jsdenim/thermonuino/main/Specifications Thermonuio.md

Le projet Thermonuino est un ensemble de composants qui communiquent entre eux pour gérer le chauffage d’un appartement.

Le mode de commande est par fil pilote : les radiateurs sont réglés au maximum, et on les commande soit en “CONFORT” \= rien dans le fil pilote, pour les faire chauffer, soit en “HORS-GEL” \= demi-alternance dans le fil pilote.

Il y a 4 type de composants dans le système :
La partie pilote, la partie console, la partie mesure, et la partie détection de fenêtre ouvertes.

La partie pilote et reliée à la partie console par deux paires de cuivre : 5V, GND, et RX et TX pour communiquer.
Les parties mesure et détection de fenêtre communiquent avec la console par RF 433 Mhz via des modules CC1101. Pour ces derniers, chaque module doit avoir une adresse unique et vaguement aléatoire sur 32000 possibilités, (pour éviter des conflits avec d’autres appartements).

Tous les composants fonctionnent avec des Atmega328p à 8Mhz, en 5v quand il y a une alimentation continue, ou en 3.3v quand ils sont sur pile.

Le système est capable de gérer 4 zones de chauffage, et dans chaque zone, il y a une sonde de mesure, et éventuellement un détecteur de portes ouvertes.

Fonctionnement général :

La température commandée se fait par zone, et par apprentissage progressif. Dans un premier temps, l’utilisateur va indiquer sur chaque zone la température qu’il souhaite, et le système va mémoriser qu’à telle heure, tel jour de la semaine, il doit faire telle température dans la zone. Chaque fois qu’il reprécise son souhait, cela enrichit la programmation.

La partie console permet de dériver de la programmation habituelle pour toutes les zones, en demandant un peu plus chaud, un peu plus froid, rien du tout….

Les détecteurs de porte ouverte permettent de mettre en pause le chauffage dans la zone correspondante.

# Partie Pilote

Sur la partie haute tension, elle gère les ordre dans le fil pilote. Ensuite, il y a une alimentation 5V qui alimente la logique de PCB, et alimente aussi la partie console.
Les deux PCB sont reliés par deux paires torsadées, une pour le 5v, l’autre pour une communication série en 9600 bauds.

Cette partie gère aussi une lecture des trames TIC d’un compteur Linky.
La TIC est employée pour deux choses : lire la date et l’heure (et la transmettre a la console), et déterminer la variation de courant soutirée lorsqu’un radiateur est commandé (ce qui aide pour la logique de chauffage).

La partie pilote envoie à la console l’heure courante, l’estimation déduite de la puissance des radiateurs sur chaque zone.
Elle reçoit de la partie console des instructions de chauffage pour chaque zone.
L’instruction est sous forme de duty cycle.
La durée du cycle est indiquée par la console pour toutes les zones à la fois. Probablement que 30 minutes est une bonne base de travail.
Ensuite, la console indique pour chaque zone le temps de travail sur la durée du cycle, par une valeur comprise entre 0 et 255\. 0 représentant aucune activation du chauffage, 255 une activation permanente pour les 30 prochaine minutes du cycle de travail.
127 représente une activation durant 15 minutes, découpées en plusieurs morceaux pour être réparti équitablement dans le temps de travail des 30 minutes.

La réception de nouvelles instructions de travail provoque la rupture du duty cycle déjà en cours.

Sur la partie pilote, il y a un bouton statut, et un bouton par zone, une chaîne de LED adressable, une pour le statut, une pour le Linky, et une par zone.
Tant qu’on appuie sur rien, la partie pilote respecte ce que dit la console.
La LED statut est alors verte.

Si on appuie sur l’un des boutons d’une zone, la partie pilote n’écoute plus ce que dit la centrale. La zone correspondante est inversée, et on ne fait rien de plus. Plusieurs zones peuvent ainsi être forcées à être allumées.
Le bouton statut permet de revenir au mode normal.

Dans tous les cas, les LED des zones indiquent si le chauffage est commandé ou pas.

Si la détection de la puissance d’une zone échoue, on peut afficher une LED violette quand elle n’est pas commandée. Le reste du temps, quand on fait chauffer une zone, on allume en orange, si non éteint.

# Partie Console

La partie console dispose d’un CC1101 pour échanger avec les sondes de mesure et le détecteur de portes ouvertes.

La partie console est responsable de mémoriser la programmation de la température dans chaque pièce, et d’ordonner à la partie pilote un rythme de chauffage pour chaque zone.
La mémoire se fait sur l’EEPROM séparée, accessible en I2C, d’une capacité de 512Kbits.

La partie console dispose d’un ATH30 en I2C pour une mesure de température “de secours”, c’est à dire si les sondes de mesures ne donnent plus de signal.

Le PCB dispose d’une chaine de LED adressables pour chaque zone, et une sous la mode sélectionné, et une au centre du boitier.

La console n'a pas d'écran et ne doit donc pas porter de menu utilisateur complexe. Les interactions utilisateur finales disponibles sur la console sont limitées à la molette de mode et aux LED d'état. Les menus de programmation détaillés sont portés par la sonde avec écran.

## Régulation par puissance lissée

La console ne doit pas piloter le chauffage par simple seuil instantané, par exemple tout allumer tant que la température est sous la consigne puis tout couper dès que la consigne est dépassée. Le comportement recherché doit être plus progressif et peu perceptible.

Pour chaque zone, la console doit raisonner en puissance thermique à injecter sur une période glissante, typiquement une heure. L'apprentissage doit permettre d'estimer qu'une zone a besoin d'une certaine énergie de maintien, par exemple l'équivalent de 3500 W pendant une heure, pour rester stable dans un contexte donné.

La puissance électrique des radiateurs de chaque zone est fournie par la partie pilote, qui l'apprend grâce aux variations de puissance TIC observées pendant les cycles d'apprentissage. Cette information permet à la console de convertir une puissance de maintien souhaitée en workload 0..255 envoyé au pilote. La console considère comme cohérente une puissance comprise entre `700 VA` et `3000 VA`, bornes incluses. Toute autre valeur, notamment `0` lorsque l'apprentissage du pilote a échoué, est remplacée par la valeur de secours `1200 VA`.

Exemple : si une zone dispose de radiateurs estimés à `2400 W` et que l'algorithme souhaite injecter l'équivalent de `1200 W` pendant l'heure, la console peut demander environ 50 % de travail sur cette zone. Le pilote se charge ensuite de lisser ce duty cycle dans le cycle court de commande fil pilote.

Dans une première version de production, la console peut utiliser une régulation proportionnelle simple : si la température mesurée d'une zone est inférieure à sa consigne effective, elle estime une puissance demandée proportionnelle à l'écart, la borne entre une puissance minimale utile et une puissance maximale, puis convertit cette puissance en workload `0..255` à partir de la puissance installée apprise pour la zone. Si la puissance installée est inconnue, la console peut utiliser une valeur de secours prudente jusqu'à réception d'une estimation fiable du pilote.

Cette logique doit rester visible dans le simulateur Web : pour chaque zone, il doit être possible d'observer au moins la puissance installée apprise, la puissance de maintien demandée par l'algorithme, le workload 0..255 correspondant, et l'effet thermique simulé.

L'apprentissage doit aussi tenir compte des habitudes d'aération. Pour chaque zone et chaque créneau hebdomadaire, la console conserve un compteur d'ouverture de porte/fenêtre. Si une porte est ouverte pendant le créneau, le compteur augmente. Si, la semaine suivante, le même créneau passe sans ouverture, le compteur diminue. Une habitude d'aération récurrente peut alors réduire légèrement la puissance demandée avant ou pendant ce créneau, afin d'éviter de chauffer inutilement juste avant une phase où l'air chaud sera évacué.

L’utilisateur peut choisir un mode à l’aide d’une molette, qui s’applique alors sur toutes les zones. Cette molette est réalisée par une piste de cuivre découverte : une seule entrée de mode doit normalement être active à la fois. Pendant les petits recouvrements ou états incertains où aucune entrée ou plusieurs entrées sont actives, la console conserve le dernier mode clairement sélectionné.

* Normal : respecte la programmation habituelle apprise pour chaque zone.
* Plus : augmente d’un degré tout l’appartement par rapport à la programmation normale.
* Moins : diminue d’un degré tout l’appartement par rapport à la programmation normale.

  Les modes plus et moins peuvent être utilisés de manière impulsionnelle : si l'utilisateur part de Plus ou Moins, revient brièvement sur Normal, puis revient sur le même mode Plus ou Moins en moins de 3 secondes, l'effet s'additionne par pas de 1 °C. L'override reste actif tant que la molette reste sur Plus ou Moins.

* Douche : pendant 30 minutes, la zone salle de bain, zone 4, vise une consigne augmentée de 2 °C par rapport à la programmation normale. Cela peut conduire la régulation à demander un workload très élevé au début si l'écart de température est important, mais le chauffage doit ensuite être modulé comme pour les autres modes. Le reste de l’appartement applique temporairement une consigne réduite de 1 °C, car l'utilisateur sort souvent de la douche avec une sensation de chaleur.

* Stop : tout les chauffages sont coupés. Les sondes reçoivent `global_mode = Stop` dans les réponses RF et doivent se mettre en OFF fonctionnel.

* Vacance : applique une consigne Vacances configurable, 17 °C par défaut, pour tout l’appartement, mesuré uniquement sur la centrale. Si la molette est sur Vacance, le mode vacances est forcé et reste actif tant que la molette reste sur cette position.

Le mode vacances peut aussi se déclencher de lui-même lorsque les détecteurs de mouvement ne rapportent plus de mouvement récent, c'est-à-dire depuis environ 48 h. (Fonctionnalité non appliquée lorsqu’aucune zone n’a plus d’information des thermomètres.) Il faut distinguer le mode Vacance forcé par la molette du mode Auto-vacances : le mode automatique s'arrête dès qu'une présence est de nouveau détectée. Une détection PIR ne doit pas déclencher une émission RF immédiate pour préserver les piles ; chaque front de détection est comptabilisé localement par interruption, conservé jusqu'à un ACK valide, puis envoyé lors du prochain échange RF normal. L'indication locale « présence récente » sur 15 minutes doit utiliser les cycles réels du watchdog, car `millis()` ne progresse pas pendant le sommeil profond. La console horodate les présences reçues avec son horloge interne. L'heure fournie par la partie pilote/Linky est une condition normale de démarrage ; la logique applicative considère ensuite l'heure disponible. La première synchronisation horaire valide doit réinitialiser la référence d'absence afin qu'un temps par défaut ou transitoire au démarrage ne déclenche jamais Auto-vacances immédiatement.

L'apprentissage de programmation ne doit être modifié que lorsque la molette est sur Normal. Les modes Plus, Moins, Douche, Stop, Vacance forcé ou Vacance automatique ne doivent pas effacer ni renforcer l'apprentissage existant.

Si une zone est bloquée en porte/fenêtre ouverte mais que le thermomètre de la zone reçoit ensuite une demande utilisateur explicite de consigne, la console doit ignorer temporairement l'information porte ouverte pour cette zone. Ce contournement permet de reprendre le chauffage si le détecteur d'ouverture est défectueux ou si son aimant est mal placé. Dès que le détecteur d'ouverture reparle, l'état porte est considéré de nouveau fiable et le contournement est annulé.

La LED du mode :
Vert \= Normal
Plus \= Orangé
Moins \= Bleu
Douche \= Alternance Orangé / Vert
Stop \= éteint
Vacance \= Bleu clignotant doucement (1 part 10 secondes)

Fonctions des LED par zone :

* Jaune : chauffe en cours.
* Bleu : porte ouverte détectée
* Éteint : pas d’action en cours.
* Violet fixe : plus de communication avec le détecteur de porte ouverte.
* Violet clignotant 1 seconde toutes les 6 secondes : pile du détecteur de porte ouverte à remplacer.
* Rouge clignotant 1 seconde toutes les 6 secondes : pile de la sonde de mesure à remplacer.
* Rouge fixe : plus de communication avec la sonde de mesure.
* Flash violet de 100 ms : réception d'une trame du détecteur de porte ouverte.
* Flash rouge de 100 ms : réception d'une trame de sonde.

Si plusieurs états doivent être affichés sur la même LED de zone, l'affichage peut être séquencé sur une période d'environ 7 secondes. Par exemple, si une porte est ouverte et que la pile du détecteur de porte est faible, la LED peut rester bleue pendant 6 secondes puis afficher 1 seconde de violet. Si seul le chauffage est actif, la LED reste jaune sur toute la période, ce qui donne une impression continue.

La luminosité globale des LED de la console est limitée à `49` en journée. Elle monte progressivement depuis le minimum `3` entre 7h et 9h, reste au maximum jusqu'à 17h, puis redescend progressivement jusqu'au minimum à 21h. En l'absence d'heure valide, la console utilise la luminosité minimale.

La partie console indique aux sondes de mesure de basculer en OFF lorsque l’une des conditions suivantes est remplie :
Le mode de fonctionnement est sur STOP ou VACANCE
La température de la centrale est supérieure à 23° depuis plus d’un jour.

# Partie Mesure

ATH30 en I2C, détecteur de mouvement, état de la pile.

La communication avec la console se fait à l’aide d’un module CC1101 alimenté en 3,3 V permanent.
Par défaut, le CC1101 est placé en basse consommation par commande SPI `SPWD`. Quand il communique avec la console, il écoute pendant quelques secondes la réponse de la console qui accuse réception de ce que la sonde communique, et indique aussi les messages qui étaient en attente pour la sonde de mesure.

La partie sonde dispose aussi un écran et d’un switch bidirectionnel \+ bouton.
La fréquence de communication avec la centrale dépend des conditions, et des interactions avec l’utilisateur :

* Tant que la température est stable, et sans interaction de la part de l’utilisateur, ou que la centrale a indiqué qu’il fallait se mettre en OFF, la sonde ne parle que toutes les heures.
* La sonde signale sous quelques secondes tout changement de température de plus de 0.45°.
* De même, si l'utilisateur fait des changements sur la température transitoire dans la pièce, ou sur la programmation, ils sont communiqués à la centrale sous quelques secondes.

La sonde dispose donc de plusieurs états de fonctionnement, avec une répercussion sur l’écran.

* Normal : affichage HOME classique.
* Menu : navigation et réglages locaux sur deux niveaux.
* Batterie faible : l'écran normal reste utilisable, mais l'information est visible dans le menu Etat et transmise à la console.
* Batterie critique : la sonde affiche un écran bloquant `REMPLACER PILES`, barré par une croix, signale l'état critique à la console pendant environ 1 h, puis cesse toute activité pour éviter de descendre la pile trop bas.
* Défaut RF bloquant : si le self-test SPI du CC1101 échoue au démarrage, la sonde affiche un écran bloquant `RF 433 MHZ KO`, barré par une croix, puis s'arrête. Ce self-test doit rester facilement désactivable temporairement dans le sketch pour tester un PCB avant soudure du CC1101.
* OFF fonctionnel : lorsque la console demande Stop ou Vacance, la sonde affiche l'écran correspondant et ne perturbe pas l'apprentissage.

En mode normal, l’écran HOME affiche principalement la température actuelle en grands chiffres. La flèche représente l'écart entre la consigne courante et la température mesurée : droite si l'écart est nul, inclinée vers le haut si la consigne est plus haute que la mesure, inclinée vers le bas si elle est plus basse.

La flèche n'est affichée que si la console indique qu'il y a eu du chauffage sur la zone dans la journée passée. Si la zone n'a pas chauffé depuis environ 24 h, la flèche est masquée afin de ne pas donner l'impression qu'une action de chauffage est attendue ou pertinente.

L'écran eInk utilise le refresh partiel pour les ajustements rapides pendant une interaction utilisateur, par exemple lorsque l'utilisateur fait défiler une consigne. En revanche, lorsqu'une interaction se termine et qu'une modification est validée ou sauvegardée, le retour à l'écran précédent doit se faire avec un refresh complet. Le flash du refresh complet fait partie de l'interface utilisateur : il indique que la modification est prise en compte et que l'on revient à l'état précédent.

Si l'utilisateur manœuvre le switch vers le haut ou vers le bas, cela signale un souhait de monter ou baisser la température de façon transitoire, c'est-à-dire seulement juqu’au prochain point de programmation.
Si l’utilisateur fait suivre ce gestion par un appui sur le bouton central, cela transforme l’instruction en changement pérenne sur la programmation.

Un appui long sur le bouton central, environ 3 secondes, fait entrer dans le menu depuis HOME. Depuis le menu, le même appui long ramène à HOME. Une absence d'interaction pendant environ 60 secondes ramène aussi à HOME.

## Interface menu de la sonde

Le menu de la sonde doit rester rapide à parcourir. Le premier niveau n'est donc pas une liste de rubriques abstraites, mais une suite de pages directement utiles. Certaines pages affichent un indicateur `+` lorsqu'un sous-menu existe pour consulter des détails ou effectuer un réglage.

Le switch directionnel sert à faire défiler les pages principales. Le bouton central entre dans le sous-menu signalé par `+`, ou bascule une valeur en édition si la page courante est directement réglable. Une fois une valeur en édition, les directions `+` et `-` modifient la valeur, puis un nouvel appui central valide et sauvegarde. Une validation qui revient au niveau précédent doit utiliser un refresh complet, assumé comme retour visuel de sauvegarde.

Pages principales proposées :

| Page principale | Affichage direct | Sous-menu `+` |
|---|---|---|
| Présence | Indique si une présence humaine a été vue récemment, typiquement sur les 15 dernières minutes. Cette information n'est pas un témoin temps réel sur HOME ; elle est mise à jour dans le service de données puis consultable ici. | Historique court ou dernier instant de détection, si cela devient utile au diagnostic. |
| Batterie | Pourcentage de pile, calculé entre tension pleine et tension critique. La tension critique vaut 0 %. La page affiche un `+`. | Tension brute, tension pleine de référence, seuil faible, seuil critique, état `test sans pile` si la mesure est quasi nulle. |
| Lien console | Etat synthétique de la communication avec la centrale : OK si une réponse console valide a été reçue récemment, KO sinon. La page affiche un `+`. | Etat RF détaillé, identifiant RF local, identifiant console appris, résumé de la dernière réponse console. |
| Thermomètre | Valeur réelle mesurée par l'AHT30, affichée au dixième de degré avant correction et avant arrondi au pas de `0,5 °C`. La page affiche un `+`. | Température brute au dixième de degré et étalonnage AHT30 : offset en dixièmes de degrés, borné à `-2,5 °C` / `+2,5 °C`, envoyé à la console puis rediffusé par celle-ci. |
| Apprentissage | Etat synthétique de l'apprentissage pour la zone : consigne habituelle connue, fallback utilisé, ou absence d'information fiable. La page affiche un `+`. | Zone affectée, association de la sonde à une zone, activation/désactivation de l'apprentissage, consultation et maintenance de la mémoire apprise pour la zone. |

Sous-menu de `Lien console` :

| Page de détail | Rôle |
|---|---|
| Debug RF | Distingue le self-test SPI local du CC1101 et la réception effective d'une réponse console valide. |
| Identifiants RF | Affiche l'identifiant RF local et l'identifiant console appris. |
| Dernière réponse | Résume la dernière trame console valide : mode global, consigne courante, indicateur chauffage 1 h / 24 h, porte ouverte, délai conseillé avant prochain rapport. |

Sous-menu de `Batterie` :

| Page de détail | Rôle |
|---|---|
| Tension | Tension brute en millivolts. |
| Seuils | Tension pleine de référence, seuil batterie faible, seuil batterie critique. |
| Etat | Normal, faible, critique, ou test sans pile mesurable. |

Sous-menu de `Thermomètre` :

| Page de détail | Rôle |
|---|---|
| Brut | Température AHT30 avant correction. |
| Correction | Offset AHT modifiable, en dixièmes de degrés, qui devient effectif lorsqu'il est mémorisé puis rediffusé par la console. |
| Corrigé | Température finale utilisée pour HOME et les trames RF. |
| Vacances | Consigne utilisée par la console en mode Vacances forcé ou Auto-vacances. La sonde l'obtient depuis la réponse RF de la console et peut envoyer une demande administrative pour la modifier. La valeur durable est sauvegardée uniquement côté console. |

Sous-menu de `Apprentissage` :

| Page de détail | Rôle |
|---|---|
| Zone | Affiche la zone chauffage affectée à la sonde : zone 1 à 4. |
| Association | Permet de demander l'association ou le changement d'association de la sonde. Un appui central entre en édition, `+` et `-` choisissent la zone candidate 1 à 4, et chaque changement force l'envoi d'une trame RF avec `admin_request = association` et `pair_zone_request`. L'association finale reste mémorisée côté console. |
| Consigne programmee | Affiche la consigne habituelle actuellement retenue par la console pour la zone. |
| Actif | Active ou désactive l'apprentissage pour la zone affectée. Si l'apprentissage est inactif, la console ignore la programmation apprise pour cette zone et applique directement la consigne envoyée par la sonde. Ce réglage est mémorisé par zone côté console. |
| Comm. console | Indique si la communication avec la console est utilisable : `OK` si une réponse console valide a été reçue récemment, `ABSENTE` sinon. La consigne affichée sur la sonde doit toujours être réalignée sur la consigne renvoyée par la console lorsqu'un ACK valide est reçu. |
| Reset zone | Envoie à la console une demande d'effacement de l'apprentissage de la zone affectée à cette sonde. L'écran indique l'envoi tant que la demande n'a pas été acquittée. |
| Reset global | Envoie à la console une demande d'effacement de tout l'apprentissage. L'écran indique l'envoi tant que la demande n'a pas été acquittée. |
| Semaine type | Envoie à la console une demande de chargement de la semaine type pour toutes les zones. L'écran indique l'envoi tant que la demande n'a pas été acquittée. |

La modification quotidienne de température ne se fait pas dans ce menu. Elle reste portée par HOME : `+` ou `-` applique une variation transitoire, puis un appui central peut transformer cette demande en modification pérenne de la programmation selon la logique d'apprentissage.

Le pourcentage de batterie affiché est une valeur pratique, pas une mesure chimique exacte. Il est calculé ainsi :

```text
pourcentage = clamp((tension_mesuree - tension_critique) / (tension_pleine - tension_critique), 0, 1) * 100
```

Si la mesure de pile vaut environ `0 V` ou une valeur très faible, par exemple `<= 0,05 V`, la sonde considère qu'elle est alimentée par programmateur ou banc de test sans pile mesurable, et le contrôle batterie ne bloque pas l'appareil.

Un détecteur de mouvement PIR permettent de savoir s’il y a toujours quelqu’un dans la zone. Du point de vue global de l’appartement, on peut déduire après 2 jours sans mouvement dans tout l’appartement qu’il n’y a personne, et qu’on peut basculer automatiquement en mode vacance. Au niveau d’un pièce, cela peut aussi servir à enrichir la programmation : si on remarque que la personne passe souvent dans un même créneau horaire, et plus rarement dans un autre, on peux ajuster la consigne avec cela.

# Partie détection fenêtre ouverte

Etat de la pile, interrupteur REED, CC1101.
Signale un changement d’état si on ne revient pas à l’état précédent en moins de 10 secondes.
Parle au moins toutes les heures à la centrale.
Un bouton permet de déclencher une interaction locale, notamment pour générer l'identifiant initial de l'appareil, demander l'association, puis faire avancer la zone proposée pendant l'association.

Le détecteur de porte ouverte utilise le même montage de mesure batterie que la sonde : entrée `BAT_SENS` sur A0 / PCINT8, pont diviseur 1 Mohm / 1 Mohm, mesure avant régulateur 3 V, calcul `ADC * 3300 mV * 2 / 1023`.

Contrairement à la sonde, le détecteur de porte ouverte n'utilise qu'une seule pile. Ses seuils batterie sont donc distincts :

* batterie absente ou banc de test : mesure `<= 50 mV`, ignorée pour les alertes ;
* batterie faible : environ `1000 mV` ;
* batterie critique : environ `850 mV`.

En batterie critique, le détecteur peut continuer à signaler son état à la console pendant environ 1 h, puis il doit cesser les émissions périodiques et se rendormir afin d'éviter une décharge trop profonde.

# Robustesse temporelle

Les Atmega328p du projet sont destinés à fonctionner 24 h / 24, sans arrêt volontaire. Le code doit donc tenir compte du débordement de `millis()`.

Sur Arduino/ATmega328p, `millis()` est stocké sur 32 bits non signés et revient à zéro après environ 49,7 jours. Tout code qui mémorise une date issue de `millis()` doit donc être écrit de façon compatible avec ce retour à zéro.

La règle recommandée est de comparer les durées par soustraction non signée :

```cpp
if ((uint32_t)(millis() - lastEventAt) >= intervalMs) {
  lastEventAt = millis();
  // action
}
```

Il faut éviter les comparaisons directes du type :

```cpp
if (millis() > lastEventAt + intervalMs) {
  // fragile au débordement
}
```

Un redémarrage volontaire du MCU lorsqu'on détecte que `millis()` est redevenu inférieur à une valeur précédente peut sembler simple, mais ce ne doit pas être la solution par défaut. Un reboot peut interrompre une communication RF, perdre un état temporaire non sauvegardé, ou provoquer un comportement visible pour l'utilisateur. Il peut rester acceptable comme garde-fou dans un module très simple, à condition que les compteurs importants aient été sauvegardés ou soient reconstruisibles.

Pour le code final, les temporisations doivent donc être conçues comme tolérantes au débordement. Les modules qui gardent des états longs doivent aussi distinguer les horodatages courts basés sur `millis()` des dates calendaires reçues de la console ou du Linky.

# Réglages techniques RF CC1101

Les essais de portée entre la console et le détecteur de porte ouverte ont montré que la communication CC1101 est très sensible aux périodes où le microcontrôleur est occupé à faire autre chose. Les motifs LED de diagnostic ne doivent donc pas bloquer l'exécution radio.

Réglages validés pour les tests de portée :

* La console/dial reste en réception presque permanente.
* Les modules sur pile ne doivent pas émettre des rafales aveugles. Ils utilisent un protocole à tentative unique, ACK, timeout et retry.
* Avant d'émettre, un module sur pile passe brièvement en réception et vérifie si le canal semble occupé. Si le canal est occupé, il attend un délai aléatoire avant de réessayer.
* La trame de test contient un préfixe `TNU`, l'identifiant source, un compteur, un type, puis le compteur accusé :
  * `B` pour une balise du détecteur de porte ouverte ;
  * `A` pour un accusé de réception de la console ;
  * le dernier octet vaut 0 dans une balise, et vaut le compteur reçu dans un ACK.
* Après une trame émise, le module sur pile passe immédiatement en réception et attend un ACK de la console pendant environ 300 ms.
* Si l'ACK n'arrive pas avant timeout, le module attend un délai aléatoire de backoff, puis réessaie. Le backoff augmente avec le nombre d'échecs.
* Valeurs de départ recommandées :
  * écoute canal avant émission : 30 ms ;
  * timeout ACK côté module sur pile : 300 ms ;
  * nombre maximal de tentatives : 6 ;
  * backoff initial : 100 à 600 ms, augmenté à chaque tentative.
* La console répond par une courte série d'ACK pendant environ 300 ms, pour donner plusieurs chances au module sur pile de les recevoir sans saturer le canal.
* Pendant l'émission des ACK, la console peut indiquer visuellement l'émission de retour, par exemple en passant la LED SDB en orange.
* Sur le détecteur de porte ouverte, le résultat de transaction peut être indiqué pendant une fenêtre courte :
  * LED fixe pendant environ 1 s si l'ACK a été reçu ;
  * flash court d'environ 150 ms si aucun ACK n'a été reçu.
* Les FIFO RX doivent être vidées seulement en cas d'overflow réel (`RXBYTES & 0x80`). Il ne faut pas vider la FIFO quand une trame partielle est en cours de réception.
* Les motifs LED doivent être non bloquants. Un `delay()` long dans un clignotement peut faire manquer les balises ou les ACK suivants.
* La reconfiguration complète du CC1101 ne doit pas être faite périodiquement pendant l'écoute normale, car elle peut tomber au moment où une trame arrive. Elle est utile au démarrage, ou après une erreur radio identifiée.
* Les PCB esclaves alimentent le CC1101 en 3,3 V permanent. Il ne faut pas couper son alimentation avec une broche MCU ; la basse consommation RF se fait par commande SPI.
* Le temps laissé après `STX` doit dépendre de la taille réelle de la trame et du débit radio. Un délai qui suffit pour une trame de 6 octets peut couper une trame applicative de 30 à 50 octets avant la fin. Les tests utilisent GDO0 pour attendre la fin d'émission, avec un timeout de secours.
* Sur les appareils sur pile, entre deux cycles d'émission et de réception d'ACK, le CC1101 doit être placé dans le mode le plus économique possible en énergie. Le test actuel peut garder la RF active pour faciliter le diagnostic, mais le code final devra passer explicitement en basse consommation hors fenêtre de communication.

## Sommeil des esclaves sur pile

Les esclaves sur pile, notamment détecteur de porte ouverte et sonde de mesure, doivent dormir entre deux événements. En phase normale :

* le CC1101 doit être placé en mode basse consommation avec le strobe `SPWD` hors fenêtre de communication ;
* l'ATmega doit passer en sommeil profond quand il n'a ni LED de diagnostic à afficher, ni trame RF à envoyer, ni ACK à attendre ;
* le réveil doit être possible par bouton utilisateur, changement d'état REED, et timer périodique ;
* le réveil bouton/REED doit utiliser une source d'interruption adaptée, par exemple pin-change interrupt sur ATmega328P ;
* le réveil périodique peut utiliser le watchdog en mode interruption. Pour les esclaves sur pile, le watchdog doit être testé avec sa période longue, environ 8 s sur ATmega328P. La période applicative réelle est ensuite exprimée en nombre de cycles watchdog : 3 cycles pour le test courant, puis un autre multiple de 8 s en fonctionnement final.

Attention : en sommeil profond, `millis()` ne progresse pas, car le timer Arduino est arrêté. Les délais longs liés au réveil périodique, comme le prochain beacon automatique, doivent donc être comptés avec une base de temps réveillée par watchdog ou équivalent, pas uniquement avec `millis()`.

Tout sketch qui utilise le watchdog doit le désactiver explicitement au tout début de `setup()` avant toute initialisation longue. Après une reprogrammation ou un reset, l'ATmega peut redémarrer avec le watchdog encore actif ; sans désactivation immédiate, le module peut entrer dans une boucle de resets avant même d'allumer une LED ou d'initialiser l'écran.

Après réveil, l'esclave doit réveiller le CC1101, reconfigurer la radio si nécessaire, envoyer sa trame, attendre l'ACK console, puis remettre le CC1101 et l'ATmega en basse consommation.

Si un esclave n'obtient aucun ACK sur 10 échanges applicatifs consécutifs, il doit considérer que la console est hors service ou non alimentée. Dans cet état, il cesse les émissions périodiques rapprochées et ne retente automatiquement qu'après une longue période, par exemple 12 h. Un appui utilisateur sur le bouton local doit sortir immédiatement de cet état et déclencher une nouvelle tentative.

# Protocole RF applicatif console / esclaves

Les sondes de mesure et les détecteurs de porte ouverte doivent utiliser le même format de trame dans le sens esclave vers console. La console doit utiliser un format unique de réponse dans le sens console vers esclave, quel que soit le type d'esclave.

La couche RF doit distinguer clairement :

* les champs nécessaires à la communication elle-même : préfixe, version, longueur, identifiants, type de trame, compteur, flags, CRC radio ;
* les champs applicatifs : mesures, état de porte, présence, consignes, mode global, commandes d'administration.

Le CC1101 est configuré avec CRC matériel. Ce CRC valide l'intégrité radio de la trame reçue. Un checksum applicatif supplémentaire n'est pas prioritaire tant que les trames restent courtes et que le CRC CC1101 est activé.

## Identifiants

Chaque équipement RF possède un identifiant stable sur 15 bits environ. Le CC1101 ne fournit pas d'identifiant matériel unique comparable à une adresse MAC ; l'identifiant doit donc être géré par le firmware.

Sur les esclaves, si aucun identifiant n'est présent en EEPROM au démarrage, l'appareil attend une interaction utilisateur avant de démarrer son fonctionnement normal :

* bouton unique du détecteur de porte ouverte ;
* bouton central du switch directionnel de la sonde.

Le temps écoulé entre le démarrage et cette interaction est utilisé comme une source d'entropie pour générer l'identifiant. L'identifiant généré est ensuite écrit en EEPROM interne de l'esclave et réutilisé aux démarrages suivants. Les collisions ne sont pas gérées explicitement, car elles sont jugées suffisamment improbables pour ce système.

Si le bouton d'un esclave est maintenu enfoncé pendant son démarrage, l'EEPROM locale de l'esclave est effacée. Cela force notamment la régénération d'un identifiant au démarrage suivant, et permet de remettre l'appareil dans un état proche de la sortie de fabrication.

La console possède également un identifiant RF stable, généré au premier démarrage si aucun identifiant valide n'est présent, puis conservé en EEPROM interne de l'ATmega. Les esclaves doivent apprendre l'identifiant de leur console afin de ne pas traiter les réponses provenant d'une autre installation.

Par convention de stockage, les informations de fonctionnement propres à un microcontrôleur doivent être conservées dans l'EEPROM interne de son ATmega : identifiant RF local, identifiant RF de la console appris par un esclave, table courte d'association `slave_id -> type -> zone` côté console, paramètres techniques courts. L'EEPROM I2C séparée de la console est réservée aux données volumineuses ou applicatives : apprentissage utilisateur, programmation horaire et historique compact.

La console dispose d'un reset usine sans sonde ni commande série. A chaque démarrage, avant d'attendre la partie pilote, elle incrémente un compteur en EEPROM interne et ouvre une fenêtre de 5 secondes. Si elle reste alimentée plus de 5 secondes, ce compteur est remis à zéro. Si elle est alimentée puis coupée avant la fin de cette fenêtre 5 fois de suite, le 6e démarrage déclenche un reset usine : EEPROM interne ATmega et EEPROM externe I2C sont effacées, puis la console reste bloquée en fin de procédure. L'utilisateur doit couper puis remettre le courant pour repartir sur une mémoire vierge. Les anciennes adresses EEPROM des premiers compteurs de démarrages courts sont réservées et ne doivent plus être réutilisées. Le compteur actif utilise une double signature et une valeur complémentée afin de ne pas interpréter un contenu EEPROM aléatoire comme un compteur valide. Pendant la fenêtre de détection, la LED centrale alterne lentement rouge/blanc ; pendant l'effacement, toutes les LED sont éteintes sauf la LED centrale qui alterne rouge/blanc toutes les 150 ms ; une fois l'effacement terminé, elle alterne rouge/blanc toutes les 5 secondes. L'effacement de l'EEPROM externe se fait par blocs I2C pour éviter un effacement octet par octet très long.

Les esclaves ne doivent pas mémoriser durablement leur zone d'affectation. La console est la seule source de vérité pour l'association `device_id -> zone`. Au démarrage, une sonde ou un détecteur récupère sa zone depuis le champ `assigned_zone` d'une réponse console. Si l'EEPROM de la console est effacée, les esclaves conservent leur identifiant RF et l'identifiant de la console, mais doivent être réaffectés à une zone.

Au démarrage, une sonde avec écran doit effectuer un premier échange RF avant d'afficher son état principal. Si la console répond avec une zone déjà affectée, la sonde peut afficher HOME. Si la console répond avec `assigned_zone = 0`, la sonde ouvre directement l'écran `PIECE ?` et prépare une trame d'association. Si aucune réponse console n'est reçue, elle affiche l'écran de console hors portée au lieu de continuer comme si les informations console étaient disponibles.

Pendant une association en cours, la console peut utiliser une zone proposée pour ses LED, mais elle ne doit pas l'envoyer comme `assigned_zone` tant que l'association n'a pas été sauvegardée en EEPROM. Dans les ACK RF, `assigned_zone = 0` signifie donc "pas encore affecté durablement", même si une zone est en cours de sélection.

Si aucun identifiant console n'est connu dans l'EEPROM d'un esclave, celui-ci peut apprendre l'identifiant de la console depuis le `source_id` d'une réponse valide reçue pendant les 3 premières minutes suivant son alimentation. Pendant cette même fenêtre de 3 minutes, un esclave peut aussi remplacer un identifiant console déjà mémorisé si une réponse valide ciblée vers lui provient d'une autre console. Cela permet de récupérer proprement après un reset usine de la console. Une fois appris, cet identifiant console est stocké en EEPROM locale de l'esclave.

Après apprentissage de l'identifiant console :

* l'esclave n'accepte comme réponse console que les trames dont `source_id` correspond à l'identifiant console mémorisé ;
* l'esclave vérifie que `target_id` correspond à son propre identifiant ;
* une trame venant d'une autre console est ignorée, même si son format est valide.

Les identifiants applicatifs sont ensuite :

* `source_id` : identifiant de l'équipement qui parle ;
* `target_id` : identifiant du destinataire attendu ;
* `0` peut être réservé pour une trame non encore appairée ou une diffusion d'association ;
* la console possède aussi son propre identifiant RF.

La zone n'est pas déduite de l'identifiant radio. L'association entre `device_id`, type d'appareil et zone est mémorisée par la console.

## Association RF

La console n'entre automatiquement en association que pendant une fenêtre courte après son démarrage, environ les 3 premières minutes. Pendant cette fenêtre seulement, elle accepte les trames destinées à `target_id = 0` comme candidates à l'association. En dehors de cette fenêtre, une trame reçue depuis un identifiant inconnu est ignorée ou traitée comme non appairée, mais ne doit pas provoquer une association automatique.

Pendant cette fenêtre d'association automatique, la console doit privilégier la réception RF et l'émission d'ACK. Les self-tests périodiques non indispensables, notamment les tests I2C et lectures capteur pouvant bloquer brièvement, doivent être suspendus ou fortement espacés pour ne pas perturber l'association.

Pendant cette fenêtre, si la console reçoit une trame valide d'un esclave dont l'identifiant est inconnu, elle bascule en phase d'association pour cet esclave. L'esclave n'utilise pas une trame spéciale d'association : il continue d'envoyer la même trame de rapport que d'habitude. La console se concentre alors sur `source_id`, `device_type` et les informations nécessaires à mémoriser l'appareil.

Dès qu'une association est active pour un `source_id`, la console doit considérer temporairement cet esclave comme connu pour le filtrage RF, même si l'association n'est pas encore sauvegardée en EEPROM. Cela permet à l'esclave de cibler la console avec son `target_id` réel après avoir appris l'identifiant console lors du premier ACK.

La phase d'association sert à :

* mémoriser l'identifiant RF de l'esclave dans l'EEPROM de la console ;
* mémoriser le type d'appareil ;
* choisir la zone à laquelle l'esclave est affecté.

La console doit prévoir jusqu'à deux esclaves par zone de chauffage. Avec les 4 zones, cela représente 8 esclaves associés au maximum dans la table courte stockée en EEPROM interne.

Pendant la fenêtre où la console accepte les associations, la LED centrale est blanche. Pendant l'association, les LED des 4 zones de chauffage de la console ne représentent plus l'état du chauffage. Elles indiquent la zone candidate pour l'association. La zone qui sera sauvegardée clignote en blanc.

Si une sonde avec écran reçoit une réponse valide de la console avec `assigned_zone = 0`, elle doit basculer automatiquement sur l'écran d'affectation `PIECE ?`. L'utilisateur peut alors choisir la zone avec `+` / `-` et valider pour envoyer `admin_request = 1` avec `pair_zone_request`. Quand la console renvoie ensuite une zone `1..4`, la sonde revient à son fonctionnement normal.

Chaque appui sur le bouton de l'esclave provoque l'envoi d'une nouvelle trame. Pendant l'association, la console interprète cette nouvelle trame comme une demande de passer à la zone candidate suivante. La sélection boucle sur les 4 zones de chauffage.

Une demande de changement de zone doit être traitée comme un événement mémorisé côté esclave, et non comme un simple état instantané du bouton. Si l'échange RF doit être répété faute d'ACK, les retries doivent conserver le même numéro de séquence afin que la console ne fasse avancer la zone qu'une seule fois.

Pendant l'association, l'esclave conserve localement la dernière zone candidate demandée. Chaque appui incrémente cette valeur locale, même si l'ACK précédent a été manqué, afin d'éviter de renvoyer indéfiniment une ancienne zone confirmée. Quand un ACK valide est reçu, la valeur `assigned_zone` renvoyée par la console resynchronise cette zone candidate locale.

Au démarrage d'un esclave, les trames périodiques automatiques peuvent être retardées quelques secondes afin de ne pas monopoliser le MCU dans un échange RF sans ACK juste au moment où l'utilisateur veut déclencher l'association. Une trame déclenchée par bouton reste prioritaire et peut être envoyée immédiatement.

Si aucune nouvelle trame de changement de zone n'est reçue pendant environ 10 secondes, la console sauvegarde l'association courante en EEPROM. Une fois l'association terminée, les LED de zone reviennent à leur rôle normal.

En fin d'association, la console doit confirmer visuellement la zone sauvegardée en allumant en blanc pendant environ 5 secondes la LED de la zone chauffage associée. Elle revient ensuite à son affichage normal.

Après réception d'une trame valide et émission de l'ACK, la console peut signaler le dialogue RF en éteignant brièvement les autres LED et en faisant clignoter en cyan uniquement la LED de l'affectation qui vient de parler. Cela permet de distinguer l'activité radio générique de l'appareil effectivement reconnu.

## Enveloppe commune

Toutes les trames RF applicatives doivent commencer par une enveloppe commune :

| Champ | Taille | Description |
|---|---:|---|
| magic | 3 octets | Valeur ASCII `TNU` pour filtrage simple |
| version | 1 octet | Version du protocole RF applicatif |
| frame_type | 1 octet | Type de trame : rapport esclave, réponse console, association, diagnostic |
| source_id | 2 octets | Identifiant RF de l'émetteur |
| target_id | 2 octets | Identifiant RF du destinataire, ou `0` en association/diffusion |
| sequence | 1 octet | Compteur incrémenté à chaque nouvelle trame émise par une source |
| ack_sequence | 1 octet | Séquence accusée, ou `0xFF` si non applicable |
| payload_len | 1 octet | Nombre d'octets applicatifs qui suivent |
| payload | variable | Données applicatives |

Le champ `sequence` sert à ignorer les doublons quand une même trame est répétée. La console doit mémoriser au moins la dernière séquence reçue par `source_id`. Un doublon doit être ignoré côté applicatif, mais la console peut tout de même renvoyer une réponse afin d'aider l'esclave à recevoir son ACK.

## Trame esclave vers console

La trame "esclave vers console" doit être commune aux sondes et aux détecteurs de porte ouverte. Certains champs peuvent valoir `non disponible` selon le type d'appareil.

La console doit valider la cohérence minimale du payload avant d'utiliser les champs applicatifs. Par exemple, `device_type` doit correspondre au type attendu pour l'appareil connu, `temp_count` ne doit pas dépasser la capacité maximale prévue, `door_open` doit valoir `0` ou `1`, et `user_delta_steps` doit rester entre `-8` et `+8`.

Champs applicatifs proposés :

| Champ | Taille | Description |
|---|---:|---|
| device_type | 1 octet | `1` sonde/interface, `2` détecteur porte ouverte |
| battery_mv | 2 octets | Tension pile en millivolts |
| status_flags / pair_zone_request | 1 octet | En fonctionnement normal : flags d'état courts. Pendant `admin_request = 1` : zone candidate demandée, `1..4` ; `0` si aucune demande explicite |
| admin_request | 1 octet | Aucune, association, affecter à zone, effacer apprentissage zone, effacer apprentissage global |
| user_delta_steps | 1 octet signé | Variation utilisateur en pas de 0,5 °C, de `-8` à `+8`, `0` si aucune |
| temp_count | 1 octet | Nombre de mesures de température embarquées. Dans l'implémentation courante : `1` si la sonde a une température courante valide, sinon `0`. |
| temperatures | variable | Température courante mesurée par la sonde, en dixièmes de degrés. La console horodate la réception et gère l'historique nécessaire à la régulation et à l'apprentissage. |
| presence_count | 1 octet | Nombre de détections humaines depuis le dernier envoi |
| door_toggle_count | 1 octet | Nombre de changements d'état REED depuis le dernier envoi |
| door_open | 1 octet | `0` fermé ou non disponible par défaut, `1` ouvert |
| aht_offset | 1 octet signé | Correction AHT en dixièmes de degrés, de `-25` à `+25`, soit `-2,5 °C` à `+2,5 °C`. Valeur spéciale `127` si l'esclave n'envoie pas de demande de correction. |
| setpoint | 2 octets | Consigne locale de la sonde en dixièmes de degrés. Utilisée par la console lorsque l'apprentissage est désactivé pour la zone. |
| report_flags | 1 octet | Flags courts du rapport : consigne locale présente, apprentissage désactivé demandé pour la zone, humidité présente, autres flags futurs. |
| humidity_deci_pct | 2 octets | Humidité relative mesurée par l'AHT, en dixièmes de pourcent, de `0` à `1000`. Valide uniquement si le flag `has_humidity` est positionné. Non disponible sur un détecteur porte ouverte. |
| vacation_setpoint | 2 octets | Consigne Vacances demandée par la sonde, en dixièmes de degrés. Valide uniquement si le flag `has_vacation_setpoint` est positionné et si `admin_request = 8`. |

Pour les compteurs d'événements (`presence_count`, `door_toggle_count`), le module conserve la valeur tant qu'une réponse console valide n'a pas été reçue. Après ACK, le compteur correspondant peut être remis à zéro.

Les températures sont encodées en dixièmes de degrés Celsius signés sur 1 octet avec offset, ou sur 2 octets signés si l'on privilégie la simplicité. Pour une première implémentation, utiliser 2 octets signés en dixièmes de degrés est plus lisible et moins risqué.

Le champ `temp_count` reste dimensionné pour permettre plusieurs mesures dans une future évolution, mais le comportement retenu pour le moment est volontairement simple : la sonde parle dès que la température change significativement et n'envoie donc que son état courant. Un détecteur de porte ouverte met `temp_count = 0`.

Les requêtes d'administration sont des demandes venant d'un esclave ou de son interface utilisateur. Elles ne sont exécutées par la console que si le contexte le permet, par exemple si la console est en mode association ou si la demande est confirmée par l'utilisateur.

Une demande `admin_request = 1` hors contexte d'association actif doit être ignorée par la console au niveau applicatif : elle ne doit pas changer d'association, ne doit pas changer d'état de zone, et ne doit pas déclencher de signal LED d'association. La couche RF peut tout de même répondre pour ne pas dégrader la robustesse radio.

La correction AHT est un réglage global de calibration. Une sonde avec écran peut proposer un menu d'étalonnage permettant de choisir une correction entre `-2,5 °C` et `+2,5 °C`. Si elle envoie une valeur dans cette plage, la console la mémorise dans l'EEPROM interne de l'ATmega, puis la rediffuse dans toutes ses réponses RF. Si la valeur reçue est hors plage, la console l'ignore comme si aucune correction n'avait été demandée.

L'humidité mesurée par l'AHT peut être utilisée par la console comme correction légère de confort en période de chauffage. La consigne affichée et renvoyée à la sonde reste la consigne utilisateur. Pour la régulation seulement, la console peut ajouter une correction proportionnelle de `0,0 °C` à `1,0 °C` entre `40 %` et `80 %` d'humidité relative, bornée hors de cette plage. Cette correction ne s'applique pas aux modes qui neutralisent la régulation normale, comme STOP ou Vacances.

La sonde ne conserve pas d'historique de température durable. La console est responsable d'horodater les températures reçues, de constituer l'historique utile et d'alimenter l'algorithme de régulation ou d'apprentissage.

Valeurs envisagées pour `admin_request` :

| Valeur | Signification |
|---:|---|
| 0 | aucune demande |
| 1 | demander l'association de l'appareil courant |
| 2 | affecter l'appareil courant à une zone |
| 3 | mettre la console en association pour la zone courante |
| 4 | effacer l'apprentissage de la zone |
| 5 | effacer l'apprentissage de toutes les zones |
| 6 | charger une semaine type complète dans la programmation de la console |
| 7 | sauvegarder la consigne courante de la sonde comme point pérenne de programmation |
| 8 | modifier la consigne Vacances mémorisée par la console |

Sur un détecteur de porte ouverte, un appui sur le bouton local peut émettre `admin_request = 1` pour demander l'association de l'appareil courant. Dans ce cas, l'esclave renseigne aussi `pair_zone_request` avec la zone candidate demandée. La console ne doit accepter cette demande que si le contexte d'association est actif ou explicitement autorisé.

Sur une sonde, les demandes `admin_request = 4`, `5` et `6` sont déclenchées depuis le menu `Apprentissage`. La console doit les traiter comme des commandes administratives de la zone associée à la sonde émettrice : reset de la zone courante, reset global, ou chargement d'une semaine type.

La demande `admin_request = 6` charge en EEPROM console une semaine type pour toutes les zones et tous les jours : 06h30 -> 19,5 °C, 16h30 -> 20,5 °C, 21h00 -> 17,5 °C.

La demande `admin_request = 7` est envoyée par la sonde lorsque l'utilisateur valide explicitement une consigne depuis HOME avec le bouton central. La console doit sauvegarder cette consigne en EEPROM comme modification pérenne de la programmation de la zone associée. Une simple variation `+` ou `-` sans validation centrale reste transitoire.

La demande `admin_request = 8` est envoyée par la sonde quand l'utilisateur modifie la consigne Vacances depuis le menu Thermomètre. La console sauvegarde cette valeur en EEPROM interne et la renvoie ensuite dans toutes ses réponses RF. La sonde ne conserve pas cette valeur en EEPROM : elle l'affiche à partir de la dernière réponse console reçue.

## Trame console vers esclave

La trame "console vers esclave" est envoyée en réponse à une trame reçue. Elle sert à accuser réception et à donner à l'esclave les informations utiles pour son affichage, son comportement et son association.

Les champs `global_mode`, `usual_setpoint`, `current_setpoint`, `heat_active` et `zone_door_open` décrivent l'état décidé par la console. Ils peuvent servir à l'affichage ou au comportement local de la sonde, mais la sonde ne décide pas combien chauffer. La décision de chauffage reste centralisée : la console applique l'apprentissage, le mode global, les portes ouvertes et les puissances apprises, puis envoie le workload correspondant à la partie pilote.

Champs applicatifs proposés :

| Champ | Taille | Description |
|---|---:|---|
| assigned_zone | 1 octet | Zone affectée à l'esclave : `0` non affecté, `1` à `4` zones chauffage |
| date_time | 6 octets | Année depuis 2000, mois, jour, heure, minute, seconde |
| global_mode | 1 octet | Normal, Plus, Moins, Douche/SDB, Stop, Vacance |
| heat_active | 1 octet | `1` si la console a commandé du chauffage sur la zone dans les dernières 24 h environ. La sonde utilise ce champ pour décider si la flèche HOME reste pertinente. |
| zone_door_open | 1 octet | `1` si une porte/fenêtre ouverte est connue dans la zone |
| reserved_0 | 2 octets | Réservé pour compatibilité de trame ; doit être émis à `0` et ignoré à la réception |
| usual_setpoint | 2 octets | Consigne habituelle de la zone en dixièmes de degrés |
| current_setpoint | 2 octets | Consigne actuelle appliquée à la zone en dixièmes de degrés |
| command_flags | 1 octet | Flags courts : chauffage vu dans la dernière heure, apprentissage désactivé pour la zone, dormir, OFF sonde, rafraîchir affichage, association acceptée |
| next_report_delay_s | 2 octets | Délai conseillé avant prochain rapport périodique |
| aht_offset | 1 octet signé | Correction AHT globale en dixièmes de degrés, de `-25` à `+25`, à appliquer aux mesures directes AHT des appareils qui possèdent ce capteur. |
| next_setpoint | 2 octets | Prochaine consigne connue pour la zone, en dixièmes de degrés. Valide uniquement si le flag `has_next_setpoint` est positionné. |
| next_setpoint_delay_min | 2 octets | Délai en minutes avant application de `next_setpoint`, depuis l'heure de la trame. Valide uniquement si le flag `has_next_setpoint` est positionné. |
| vacation_setpoint | 2 octets | Consigne Vacances actuellement mémorisée par la console, en dixièmes de degrés. |

`next_report_delay_s` doit être compris comme une limite maximale avant le prochain contact avec la console, et non comme une date exacte de réveil. L'esclave peut reparler plus tôt en cas d'événement local : changement d'état porte, bouton, batterie faible, variation utilisateur, changement de température significatif ou retry après échec ACK.

La sonde récupère `current_setpoint` à chaque réponse de la console et l'utilise comme point de départ lorsqu'on passe de l'affichage HOME à l'édition de consigne. La trame réponse transporte aussi la prochaine consigne programmée connue et le délai avant son application. La sonde horodate la réception de cette information ; si le délai est écoulé avant le prochain dialogue RF, elle applique localement cette prochaine consigne avant d'afficher ou d'éditer la consigne. Cela évite qu'une sonde qui n'a pas parlé à la console depuis un moment parte d'une ancienne consigne déjà remplacée côté console.

La console continue à demander un rapport périodique, typiquement toutes les heures, afin que la sonde reçoive régulièrement le point suivant. Le champ `next_setpoint` ne remplace pas une programmation complète embarquée dans la sonde : il sert à couvrir proprement le prochain changement entre deux échanges RF.

Flags utilisés :

| Sens | Bit | Signification |
|---|---:|---|
| esclave -> console | 0 | La trame contient une consigne locale `setpoint` exploitable |
| esclave -> console | 1 | La sonde demande l'apprentissage désactivé pour sa zone |
| esclave -> console | 2 | La trame contient une humidité exploitable |
| esclave -> console | 3 | La trame contient une consigne Vacances exploitable |
| console -> esclave | 0 | Chauffage vu dans la dernière heure sur la zone affectée |
| console -> esclave | 1 | Apprentissage désactivé pour la zone affectée |
| console -> esclave | 2 | La trame contient `next_setpoint` et `next_setpoint_delay_min` exploitables |

Un esclave doit valider la cohérence minimale de la réponse avant de la considérer comme un ACK applicatif valide. Par exemple, `assigned_zone` doit être compris entre `0` et `4`, et `next_report_delay_s` ne doit pas être nul.

Le champ `target_id` de l'enveloppe indique l'esclave destinataire de la réponse. Même si le contenu parle d'une zone, la réponse est adressée à un appareil précis.

La console mémorise le dernier contact valide reçu pour chaque type d'esclave associé à une zone. Si une sonde ou un détecteur de porte a déjà communiqué puis reste silencieux pendant environ 2 heures, la console marque l'appareil absent et affiche l'état LED correspondant. Un nouveau rapport valide lève immédiatement l'état absent.

Valeurs envisagées pour `global_mode` :

| Valeur | Mode |
|---:|---|
| 0 | Normal |
| 1 | Plus |
| 2 | Moins |
| 3 | Douche / SDB |
| 4 | Stop |
| 5 | Vacance |

Valeurs envisagées pour `command_flags` :

| Bit | Signification |
|---:|---|
| 0 | Chauffage vu dans la dernière heure sur la zone affectée à l'esclave |
| 1 | Apprentissage désactivé pour la zone affectée à l'esclave |
| 2 | Prochaine consigne connue présente dans la trame |

## Contraintes de taille

Le CC1101 permet des paquets plus grands que les trames de test actuelles, mais il faut rester conservateur pour la fiabilité et la mémoire RAM des ATmega328p.

Objectifs de départ :

* viser une trame totale proche de 48 octets quand c'est possible ; l'implémentation courante du rapport esclave utilise 54 octets enveloppe comprise après ajout de l'humidité et de la consigne Vacances ;
* accepter ponctuellement jusqu'à 64 octets si une sonde doit transmettre 12 températures ;
* éviter les allocations dynamiques ;
* encoder/décoder dans des structures C fixes ou dans un buffer `uint8_t`.

Si la trame de sonde avec 12 températures devient trop longue, la sonde peut envoyer moins de mesures par trame et augmenter temporairement la fréquence d'envoi.

## Stratégie d'implémentation

L'implémentation doit avancer en plusieurs étapes :

1. Remplacer la trame de test courte par une enveloppe commune avec `version`, `source_id`, `target_id`, `sequence`, `ack_sequence` et `payload_len`.
2. Garder un payload factice de taille proche du réel pour valider la portée et les timings avec des paquets plus longs.
3. Ajouter le décodage minimal côté console/dial : vérifier magic, version, longueur, source, target et séquence.
4. Ajouter la trame de réponse console avec les champs fixes, même si certaines valeurs sont encore simulées.
5. Remplacer progressivement le payload factice par les vraies mesures et consignes.

La première règle de robustesse est de ne jamais bloquer longtemps dans l'affichage ou dans une attente active pendant les fenêtres RX/TX.

## Points restants couche RF / matériel

Les points suivants concernent uniquement la couche de communication RF, les timings, la consommation ou l'impact matériel. Ils ne portent pas sur le sens fonctionnel du payload.

* Extraire les constantes, offsets, tailles et fonctions d'encodage/décodage RF dans un bloc commun partagé par les sketches, afin d'éviter les divergences entre console, sonde et détecteur de porte ouverte.
* Gérer plusieurs esclaves côté console en mémorisant les dernières séquences par `source_id`, et non avec une seule variable globale.
* Définir précisément la politique d'ACK des doublons : ne pas retraiter deux fois la même trame applicative, mais pouvoir réémettre une réponse si l'esclave répète une trame parce qu'il n'a pas entendu l'ACK précédent.
* Implémenter une vraie trame d'association RF, avec identifiants temporaires ou diffusion contrôlée, sans dépendre d'identifiants codés en dur.
* Rendre les identifiants RF persistants en EEPROM ou dans une mémoire équivalente, au lieu d'utiliser des constantes dans les sketches de test.
* Tester le passage du CC1101 en mode basse consommation entre deux fenêtres de communication sur les appareils sur pile, puis vérifier le temps nécessaire pour revenir en émission/réception fiable.
* Remplacer les délais bloquants restants pendant la séquence ACK par une petite machine d'état, pour préparer la console à gérer plusieurs appareils et éviter les périodes sourdes.
* Tester plusieurs esclaves sur le même canal avec backoff, ACK, répétitions et doublons.
* Définir une stratégie de récupération radio : overflow RX, trames invalides répétées, GDO0 bloqué, reset ciblé du CC1101, puis retour en RX.
* Vérifier que les réglages CC1101 retenus restent stables avec des trames de tailles différentes et avec la portée réellement nécessaire.

# Protocole entre la partie PILOTE et CONSOLE :

Liaison série 9600 abauds.
cable de 2m max. Est-ce utile de prévoir quelque chose pour s’assurer de recevoir des trammes d’info complette ?

Sens PILOTE \-\> CONSOLE :
TIMESTAMP : yyyy-mm-dd hh:mm:ss
Z1\_PUISSANCE : puissance apprise en VA équivalent watt ; `0` indique que l'apprentissage a échoué. La console valide ensuite la plage `700..3000 VA` définie pour la régulation.
Z2\_PUISSANCE
Z3\_PUISSANCE
Z4\_PUISSANCE

Le câblage définitif des sorties du pilote impose la correspondance suivante avec les zones logiques de la console : canal pilote `Z1` = SDB (zone logique 4), `Z2` = Bureau (zone logique 3), `Z3` = Chambre (zone logique 2), `Z4` = Salon (zone logique 1). La console applique ce même mapping aux workloads envoyés et aux puissances reçues ; les sondes, associations, programmes et LED continuent d'utiliser les zones logiques `1=Salon`, `2=Chambre`, `3=Bureau`, `4=SDB`.

Sens CONSOLE \-\> PILOTE

DC\_LENGTH \= 30, durée en minute
Z1\_WORKLOAD \= 0, pas de travail sur les 30 prochaines minutes
Z2\_WORKLOAD \= 255, travail permanence sur les 30 prochaines minutes
Z3\_WORKLOAD \= 127, travail 50% du temps sur les 30 prochaines minutes, réparti harmonieusement.
Z4\_WORKLOAD \= 64, travail 25% du temps sur les 30 prochaines minutes, réparti harmonieusement.

Le workload indiqué ici est purement indicatif. Il s’agit d’un byte qui peut aller de 0 à 255\.

# Programmation des consignes

La console assure une programmation hebdomadaire des consignes de température par zone. Le terme "apprentissage" désigne désormais surtout la création et la maintenance de cette programmation à partir des validations explicites de l'utilisateur.

Sur la sonde, une variation de consigne faite depuis HOME avec `+` ou `-` est transitoire si l'utilisateur ne fait rien d'autre. Si l'utilisateur appuie sur le bouton central avant de sortir de l'écran de consigne, la sonde demande à la console de sauvegarder cette consigne comme point pérenne de programmation.

Les modes Stop, Plus, Moins, Douche et Vacance ne modifient jamais la programmation mémorisée.

### **Découpage temporel**

La semaine est découpée en créneaux de **15 minutes**, soit :

* 96 créneaux par jour ;
* 672 créneaux par semaine ;
* un ensemble indépendant de créneaux pour chaque zone.

Une action effectuée par l'utilisateur est affectée au créneau de 15 minutes en cours, en utilisant le début du créneau.

Par exemple :

* une action à 18h03 correspond au créneau de 18h00 ;
* une action à 18h17 correspond au créneau de 18h15 ;
* une action à 18h29 correspond également au créneau de 18h15.

### **Signification d'un créneau**

Les créneaux représentent des **changements de consigne** et non l'état complet du chauffage.

Un créneau non renseigné ne signifie donc pas qu'aucune température n'est demandée. Il signifie simplement qu'aucun changement de consigne ne doit intervenir.

Par exemple :

18h00 : 20 °C
18h15 : \-
18h30 : \-
18h45 : \-
19h00 : \-
...
22h45 : 17 °C

signifie que la consigne passe à 20 °C à 18h00, reste à 20 °C jusqu'à 22h45, puis passe à 17 °C.

### **Application et héritage**

Une consigne transitoire ou pérenne force la consigne pendant 2 heures, sauf si un autre point de programmation intervient avant.

Un rapport périodique de sonde sans variation utilisateur et sans demande administrative ne recrée pas cette priorité temporaire. Après un redémarrage de la console, la consigne locale éventuellement ancienne annoncée par la sonde doit donc être resynchronisée depuis la programmation de la console, et non remplacer celle-ci.

Après ces 2 heures, la console revient à la consigne programmée précédente si elle existe. Si aucune consigne précédente n'existe, elle conserve la consigne courante jusqu'au prochain point de programmation.

La première journée programmée pour une zone devient sa **journée de référence**. Si un jour ne contient aucune programmation propre, il reprend cette journée de référence à heure équivalente. Ainsi, si le lundi contient 06h30 -> 19,5 °C, 16h30 -> 20,5 °C et 21h00 -> 17,5 °C, les jours encore vierges appliquent la même forme de journée.

Dès qu'un jour reçoit au moins un point explicite, il devient une journée autonome et peut donc être entièrement différent. Cela ne change toutefois ni la journée de référence, ni les autres jours restés vierges. Une exception programmée le jeudi peut transformer tout le jeudi sans modifier le vendredi, le samedi ou le dimanche, qui continuent à reprendre la journée de référence.

### **Anticipation d'une hausse**

Une hausse programmée peut être anticipée sur **un seul créneau de 15 minutes au maximum**. Pendant le créneau qui précède immédiatement le changement, la console connaît déjà la prochaine consigne. Si celle-ci est supérieure à la consigne courante et à la température mesurée, elle devient temporairement la cible de travail du régulateur.

Le point enregistré dans la programmation ne change pas et une baisse de consigne n'est jamais anticipée. Le workload reste calculé par le régulateur commun à partir de l'écart de température, de la puissance installée et des valeurs thermiques apprises. L'anticipation ne signifie donc pas nécessairement une chauffe à pleine puissance.

Le système doit avoir une **mémoire longue pour déterminer qu'une habitude est fiable, mais une mémoire courte pour détecter qu'une habitude est en train de changer**.

Des corrections proches et allant dans le même sens peuvent être considérées comme cohérentes sans nécessairement être strictement identiques. Par exemple, des corrections successives de 20 °C vers 19,5 °C puis vers 19 °C peuvent indiquer une même évolution de l'habitude.

### **Modifications temporaires**

La console générale de la maison permet à l'utilisateur d'indiquer temporairement qu'il souhaite avoir **plus chaud** ou **plus froid** que d'habitude.

Ces commandes constituent volontairement des corrections temporaires et **doivent être totalement exclues de la programmation par apprentissage**.

Elles ne doivent :

* ni créer une nouvelle consigne apprise ;
* ni renforcer une consigne existante ;
* ni diminuer la confiance d'une consigne ;
* ni être considérées comme une contradiction.

L'apprentissage doit uniquement tenir compte des modifications de consigne effectuées depuis les commandes permettant de définir réellement la température souhaitée dans une zone.

### **Stockage**

La programmation est enregistrée dans l'EEPROM externe I2C de **512 kbits (64 Kio)** présente dans la console. Elle ne doit pas être recopiée intégralement en RAM : la console peut lire les points nécessaires directement depuis cette EEPROM, qui supporte très bien les lectures répétées.

Avec des créneaux de 15 minutes, une semaine représente 672 créneaux par zone. Pour quatre zones, cela représente 2 688 créneaux.

La capacité disponible étant largement suffisante, la priorité doit être donnée à une structure de données simple, robuste et facilement modifiable plutôt qu'à une compression agressive des informations. Le format actuellement retenu conserve jusqu'à 6 changements par jour et par zone. Chaque point occupe deux octets : numéro du créneau dans la journée et consigne en demi-degrés. Un octet supplémentaire par zone mémorise sa journée de référence. Les points sont lus directement depuis l'EEPROM externe, sans copie de la semaine complète en RAM.

Les températures ne doivent pas être enregistrées sous forme de nombres à virgule flottante. Elles peuvent être représentées par une valeur entière correspondant aux températures utilisables par le système, par exemple par pas de 0,5 °C entre les limites autorisées.

La programmation et sa règle d'héritage sont implémentées par le même code C++ dans la console et dans le simulateur. Une abstraction commune fournit des opérations de lecture et de mise à jour par octet. Elle est raccordée à l'EEPROM I2C sur la console et à une EEPROM virtuelle initialisée à `0xFF` dans le simulateur. Le simulateur valide ainsi le format, l'adressage et les accès de stockage réellement employés en production.

L'énergie de maintien apprise pour chaque zone, sa confiance et la réponse thermique globale restent uniquement en RAM. Ces informations sont rapides à réapprendre et évoluent fréquemment ; elles ne doivent pas provoquer d'écritures périodiques dans l'EEPROM. Après une coupure de courant, le régulateur repart donc sur ses valeurs initiales et réapprend progressivement le comportement thermique.

Il faudra également tenir compte de **l'endurance en écriture de l'EEPROM** : les données ne doivent pas être réécrites inutilement à chaque cycle de fonctionnement. Les écritures devront être effectuées uniquement lorsqu'une information d'apprentissage doit réellement être conservée, et avec une logique de type `update` qui évite d'écrire une cellule si la valeur stockée est déjà correcte.

# PINOUT & PCB

## PCB Fil Pilote

Fonctionne en 5v avec un Atmega328 en 8mhz internal

LEDCHAINDATA sur PCINT21 : un réseau de 6 LED Adressables (XL-0807RGBC-2812B), dans cet ordre : LEDZONE4, LEDZONE3, LEDZONE2, LEDZONE1, LEDLINKY, LEDSTATUT.
BTNSTAT sur PCINT19, un swtich qui va vers GND quand on appuie dessus.
BTNMUX1 sur PCINT13, 10k vers GND quand SWZ1 est appuyé, 2,2k quand SWZ2 est appuyé.
BTNMUX2 sur PCINT12, 10k vers GND quand SWZ3 est appuyé, 2,2k quand SWZ4 est appuyé.

MOSI sur PCINT3
MISO sur PCINT4
HEARTBEAT sur PCINT18, lui envoyer du 5v pour que le watchdog n'active pas le reset.
TX sur PCINT17 (Pour echanger avec la console déportée)
RX sur PCINT16 (Pour echanger avec la console déportée)
LINKY\_RX sur PCINT22
CMDZ1 sur PCINT11, commande la base d'un MMBT3904. Envoyer du courant pour éteindre l'optocoupleur qui gère la zone.
CMDZ2 sur PCINT10, idem
CMDZ3 sur PCINT9, idem
CMDZ4 sur PCINT8, idem
SCK sur PCINT5

## PCB Sonde

Atmega328 qui fonctionne en 3v 8Mhz.

MOSI et RF\_MOSI sur PCINT3
MISO et RF\_MISO sur PCINT4
SCK et RF\_SCK sur PCINT5
BAT\_SENS sur PCINT8, donne la tension de la batterie entre deux résistance de 1MHom
BODYDETECT sur PCINT23, la sortie OUT d’un EG4005C.
RF\_CSN sur PCINT2
TX de débug sur PCINT17
RF\_GDO0 sur PCINT1
POT\_ALIM sur PCINT0, pour alimenter le potentiomètre de 10kHom que quand on veut en lire sa valeur.
Une LED sur PCINT21

Un switch SLLB510100 avec CMD\_SENS1 sur PCINT16, CMD\_SENS2 sur PCINT9, CMD\_BTN sur PCINT11 , lorsqu’ils sont actionnés, ils conduisent vers GND

Dans PCINT18, y-a le réseau WAKE qui arrive, qui devrait changer quand on appuie sur le bouton, ou que BODYDETECT change

un AHT20-F sur la ligne I2C avec I2CSDA sur PCINT12 et I2CSLC sur PCINT13
Un module à base de CC1101 au bout de RF\_\*

Un écran eInk GoodDisplay de 0.97 pouces avec CS\# sur PCINT22, RES\# sur PCINT20, D/C\# sur PCINT19, BUSY sur PCINT10, le SPI partagé avec le reste.

## PCB Porte Ouverte

Atmega328 qui fonctionne en 3v 8Mhz.

MOSI et RF\_MOSI sur PCINT3
MISO et RF\_MISO sur PCINT4
SCK et RF\_SCK sur PCINT5
BAT\_SENS sur PCINT8, donne la tension de la batterie entre deux résistance de 1MHom
BODYDETECT sur PCINT23, la sortie OUT d’un EG4005C.
RF\_CSN sur PCINT2
TX de débug sur PCINT17
RF\_GDO0 sur PCINT1
POT\_ALIM sur PCINT0, pour alimenter le potentiomètre de 10kHom que quand on veut en lire sa valeur.
Une LED sur PCINT11, qui doit envoyer du courant pour l’allumer.

DOOR\_OPEN sur PCINT18, traverse en parallèle des interrupteurs REED, qui vont vers GND.
Un bouton sur PCINT19 qui fait arriver 3.3v dans le pin quand on appuie dessus.

## PCB Console :

Atmega328 qui fonctionne en 5v 8Mhz.

eprom 24LC512T-I/SN en I2C avec I2CSDA sur PCINT12, et I2CSLC sur PCINT13

LEDCHAINDATA sur PCINT11, un ensemble de LEDS Adressables (XL-0807RGBC-2812B), avec dans l’odre : LEDSALON, LEDCHAMBRE, LEDBUREAU, LEDSDB, LEDCENTRE, LEDMODE.

Un module CC1101 avec CSN sur PCINT18, RF\_GDO0 sur PCINT10, MOSI sur PCINT4 et MISO sur PCINT3, SCK sur PCINT5

Puis une piste sur PCB avec plusieurs positions : chaque entree mode est reliee
au 5 V par une resistance de 4.7 kOhm, puis le contact du bouton/selecteur la
relie a GND quand cette position est active. Le firmware doit donc lire ces
entrees en actif bas : relache = HIGH, position active = LOW. Les retours se
font par ces pins :
MODE\_DOUCHE sur PCINT8
MODE\_STOP sur PCINT9
MODE\_PLUS sur PCINT2
MODE\_NORMAL sur PCINT1
MODE\_MOINS sur PCINT0
MODE\_VAC sur PCINT23.
