jsdenim/thermonuino/main/Documentations/eInk/Redux.jpg

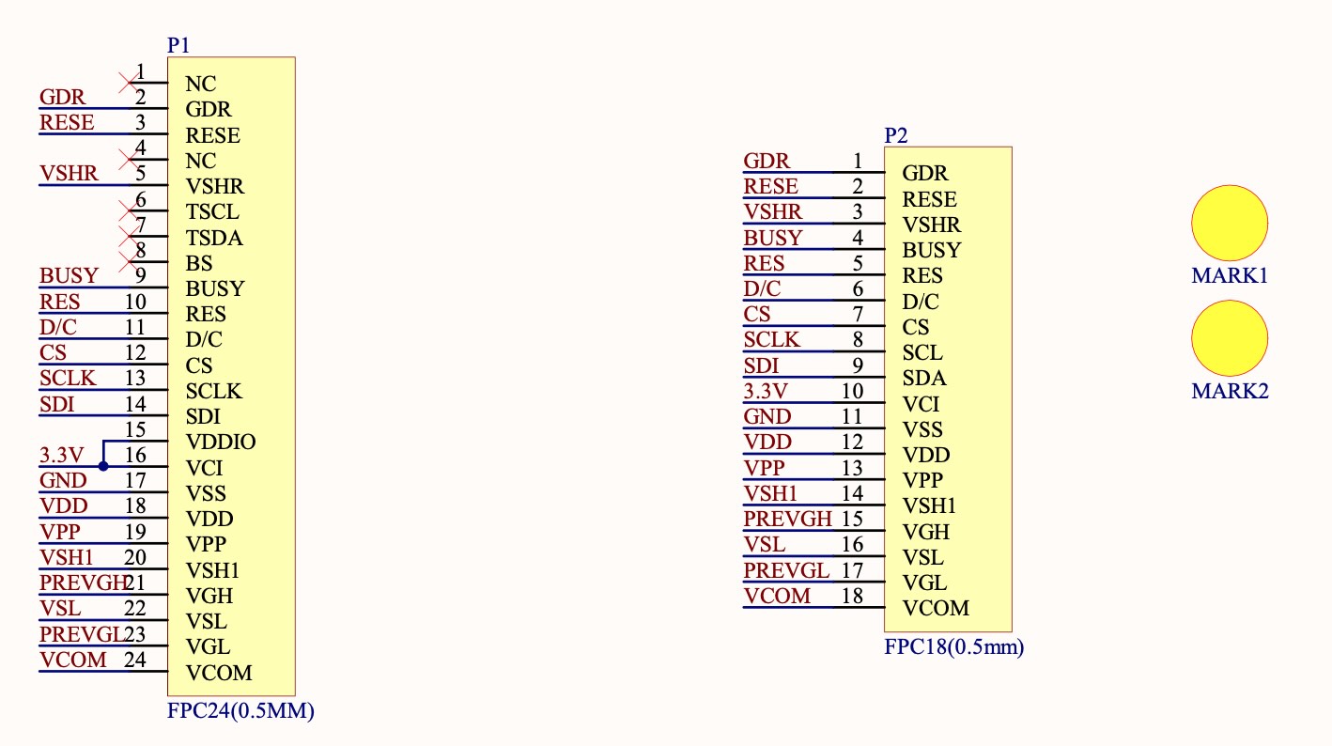
main/Documentations/eInk/Redux.jpg
