jsdenim/thermonuino/main/Documentations/Pilote/6 ordres fil pil.jpeg

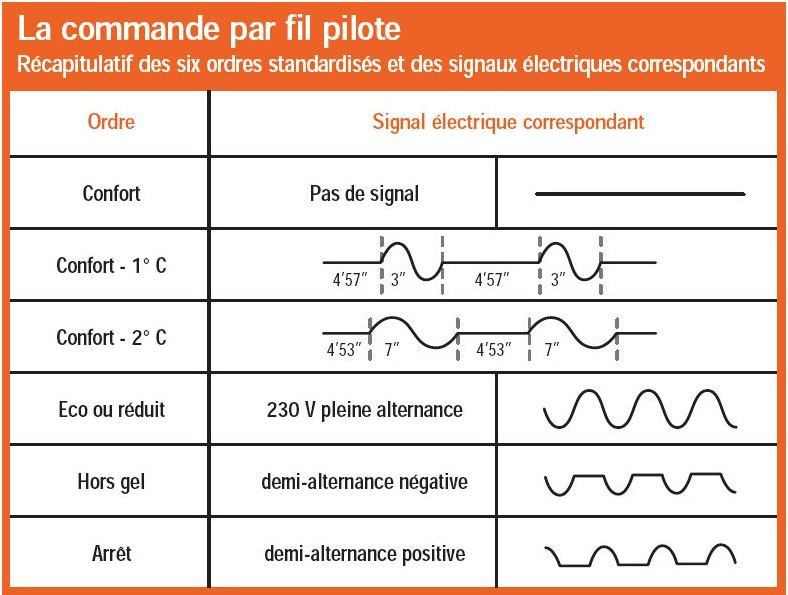
main/Documentations/Pilote/6 ordres fil pil.jpeg
