jsdenim/thermonuino/Guide utilisateur.md

# Guide utilisateur Thermonuino

Ce guide explique l'usage courant du chauffage Thermonuino, sans détail technique.

## Utilisation quotidienne

La console choisit automatiquement quand chauffer chaque pièce. Elle utilise les thermomètres, les détecteurs de fenêtre et la programmation que vous indiquez depuis les thermomètres.

La température d'une pièce se règle depuis le thermomètre de cette pièce :

1. Depuis l'écran principal, appuyer sur `+` ou `-`.
2. Régler la température voulue.
3. Laisser le thermomètre revenir tout seul à l'écran principal pour faire une demande temporaire.
4. Appuyer sur le bouton central avant le retour à l'écran principal pour enregistrer cette température dans la programmation habituelle.

Une demande temporaire dure environ 2 heures, sauf si un autre changement programmé arrive avant.

## Modes de la console

La molette de la console choisit le mode général.

| Mode | Effet |
|---|---|
| Normal | Fonctionnement habituel. La console suit la programmation et les thermomètres. |
| Plus | Demande un peu plus chaud temporairement, sans modifier la programmation. |
| Moins | Demande un peu moins chaud temporairement, sans modifier la programmation. |
| Douche | La salle de bain vise plus chaud pendant environ 30 minutes. Le reste du logement baisse légèrement. |
| Stop | Coupe le chauffage. |
| Vacances | Maintient une température basse de sécurité, autour de 17 degrés. |

Si aucun thermomètre ne signale de présence pendant environ 2 jours, la console peut passer automatiquement en Auto-vacances. Elle revient au fonctionnement normal dès qu'une présence est à nouveau signalée.

Les modes Plus, Moins, Douche, Stop et Vacances ne changent pas la programmation enregistrée.

## Partie pilote

La partie pilote est le module placé près du tableau électrique. Elle reçoit les décisions de la console, commande réellement le chauffage des quatre zones et lit les informations du compteur Linky.

Ne pas ouvrir le coffret ni intervenir sur son câblage. Les actions ci-dessous concernent uniquement les boutons accessibles prévus à cet effet.

### Boutons des zones

Chaque zone possède un bouton. Un appui fait passer la partie pilote en commande manuelle et inverse l'état de la zone correspondante : si elle était forcée à l'arrêt, elle chauffe ; si elle était forcée à chauffer, elle s'arrête.

Il est possible d'appuyer sur plusieurs boutons pour forcer plusieurs zones. Ce mode sert surtout au contrôle ou au dépannage. Un appui court sur le bouton `STATUT` permet de revenir immédiatement au fonctionnement automatique. Une nouvelle instruction complète reçue de la console remet également la partie pilote en fonctionnement automatique.

### Bouton Statut

| Action | Effet |
|---|---|
| Appui court | Annule les commandes manuelles et reprend les ordres de la console. |
| Appui long, environ 3 secondes | Relance l'apprentissage de la puissance des radiateurs. |

Pendant l'apprentissage, la partie pilote coupe d'abord toutes les zones, puis les allume une par une pendant environ 5 secondes. Elle observe la variation de consommation fournie par le Linky et mémorise la puissance estimée de chaque zone. Une variation inférieure à environ 500 VA est ignorée.

Le chauffage reprend automatiquement son fonctionnement normal à la fin du cycle. Lors d'un premier démarrage sans puissance déjà mémorisée, ce cycle peut se lancer tout seul.

### LED des zones de la partie pilote

| Etat | Signification |
|---|---|
| Orange | La zone est actuellement commandée à chauffer. |
| Eteinte | La zone ne chauffe pas et sa puissance est connue. |
| Violette | La zone ne chauffe pas, mais sa puissance n'a pas pu être déterminée. Relancer l'apprentissage peut corriger cela. |

### LED Linky de la partie pilote

| Etat | Signification |
|---|---|
| Flash vert | Une information utile vient d'être reçue du compteur Linky. |
| Eteinte | Aucune nouvelle information Linky ne vient d'être reçue. |

### LED Statut de la partie pilote

| Etat | Signification |
|---|---|
| Verte | Fonctionnement automatique, avec des ordres récents reçus de la console. |
| Orange | Commande manuelle activée avec les boutons de zone. |
| Bleue clignotante rapidement | Apprentissage de la puissance des zones en cours. |
| Rouge | La partie pilote n'a reçu aucune instruction de la console depuis environ 10 minutes. |

Au démarrage, le bref défilement bleu sur les LED est simplement un contrôle visuel du module.

## Thermomètres

L'écran principal affiche la température de la pièce.

Avec `+` ou `-`, le thermomètre passe sur l'écran de consigne. C'est la température souhaitée.

Un appui long sur le bouton central ouvre le menu. Le menu sert surtout à :

| Page | Utilité |
|---|---|
| Pièce ? | Choisir la pièce associée au thermomètre. |
| Apprentissage | Activer ou désactiver la programmation automatique de la pièce. |
| Thermomètre | Voir la mesure du capteur et régler une petite correction si besoin. |
| Batterie | Voir l'état de la pile. |
| Comm. console | Vérifier si le thermomètre parle bien avec la console. |
| Reset zone | Effacer la programmation de la pièce. |
| Reset global | Effacer toute la programmation. |

Si la console est en Stop ou Vacances, le thermomètre affiche l'état correspondant et ne change pas la programmation.

### Utiliser une consigne fixe dans une pièce

Ce réglage s'applique uniquement à la pièce associée au thermomètre. Les autres pièces continuent à suivre leur propre programmation.

1. Depuis l'écran principal, maintenir le bouton central environ 3 secondes.
2. Aller sur la page `APPRENT / ZONE`, puis appuyer sur le bouton central.
3. Faire défiler les pages jusqu'à `APPRENT ACTIF`.
4. Appuyer sur le bouton central : l'écran indique alors `APPRENT INACTIF`.
5. Le thermomètre transmet ce choix à la console. La console mémorise le réglage pour cette pièce et utilise désormais directement la consigne indiquée sur ce thermomètre, sans suivre sa programmation hebdomadaire.

Pour revenir à la programmation habituelle, refaire la même opération afin de repasser sur `APPRENT ACTIF`.

Les modes généraux de la console restent prioritaires : Stop arrête toujours le chauffage, Vacances applique sa température dédiée, et les modes Plus, Moins ou Douche conservent leurs effets habituels.

## Détecteurs de fenêtre

Un détecteur de fenêtre indique à la console qu'une fenêtre est ouverte.

Quand une fenêtre ouverte est détectée dans une pièce, la console évite de chauffer inutilement cette pièce.

## Appairage

L'appairage sert à dire à la console quel thermomètre ou quel détecteur de fenêtre appartient à quelle pièce.

La console accepte les appairages pendant les premières minutes après son démarrage. Pendant ce temps, la LED centrale est blanche.

### Appairer un thermomètre

1. Redémarrer la console.
2. Pendant que la LED centrale est blanche, aller dans le menu du thermomètre.
3. Ouvrir `Piece ?`.
4. Choisir la pièce.
5. Valider.
6. Attendre la confirmation.

### Appairer un détecteur de fenêtre

1. Redémarrer la console.
2. Pendant que la LED centrale est blanche, appuyer sur le bouton du détecteur.
3. Chaque appui fait passer à la pièce suivante.
4. Arrêter d'appuyer quand la bonne pièce est indiquée par la console.
5. Après quelques secondes sans appui, la console enregistre.

La console confirme la pièce enregistrée avec une LED de zone blanche pendant quelques secondes.

## Reset EEPROM

Un reset EEPROM efface les informations mémorisées localement dans l'appareil concerné. Il faut ensuite refaire l'appairage.

| Appareil | Procédure |
|---|---|
| Thermomètre | Maintenir le bouton central enfoncé pendant l'alimentation du thermomètre. |
| Détecteur de fenêtre | Maintenir le bouton du détecteur enfoncé pendant l'alimentation du détecteur. |
| Console | Couper puis remettre le courant 5 fois de suite en coupant à chaque fois avant 5 secondes. Au 6e démarrage, la console efface sa mémoire complète, puis reste en attente. Couper puis remettre le courant une dernière fois pour repartir. |

Après un reset d'un thermomètre ou d'un détecteur de fenêtre, l'appareil peut attendre une première pression de bouton pour recréer son identité.
Pendant la fenêtre de reset de la console, la LED centrale alterne lentement rouge/blanc. Pendant l'effacement, elle alterne rouge/blanc toutes les 150 ms. Quand l'effacement est terminé, elle alterne rouge/blanc toutes les 5 secondes.

## Signification des LED

### LED centrale de la console

| Etat | Signification |
|---|---|
| Verte quelques instants au démarrage | La console communique bien avec la partie pilote. |
| Rouge fixe | Problème avec la communication vers la partie pilote. La console s'arrête. |
| Rouge clignotant | Problème avec la radio 433 MHz. La console s'arrête. |
| Blanche | La console accepte les appairages. |
| Eteinte | Fonctionnement normal, rien de particulier à signaler. |

### LED de mode de la console

| Etat | Signification |
|---|---|
| Verte | Mode Normal. |
| Orange | Mode Plus. |
| Bleue | Mode Moins. |
| Orange et verte en alternance | Mode Douche. |
| Eteinte | Mode Stop. |
| Bleue, clignotement lent | Mode Vacances. |
| Bleue, clignotement lent alors que la molette est sur Normal | Auto-vacances : aucune présence vue depuis environ 2 jours. |

### LED des zones de la console

| Etat | Signification |
|---|---|
| Jaune ou orange fixe | La zone chauffe. |
| Bleue fixe | Fenêtre ouverte dans cette zone. |
| Eteinte | Rien de particulier. |
| Rouge fixe | Le thermomètre de cette zone ne donne plus de nouvelles. |
| Rouge clignotant lent | Pile du thermomètre faible. |
| Petit flash rouge | La console vient de recevoir une trame du thermomètre. |
| Violet fixe | Le détecteur de fenêtre de cette zone ne donne plus de nouvelles. |
| Violet clignotant lent | Pile du détecteur de fenêtre faible. |
| Petit flash violet | La console vient de recevoir une trame du détecteur de fenêtre. |
| Blanche clignotante | Zone candidate pendant un appairage. |
| Blanche fixe quelques secondes | Appairage enregistré sur cette zone. |

Si plusieurs choses arrivent en même temps, la console peut alterner les indications. Par exemple, une fenêtre ouverte peut s'afficher en bleu, puis laisser apparaître brièvement une alerte de pile faible.

### LED du détecteur de fenêtre

| Etat | Signification |
|---|---|
| Eteinte avec l'aimant en place | Fenêtre fermée. |
| Allumée sans l'aimant | Fenêtre ouverte. |
| Flash court après un appui | L'appui a été pris en compte. |
| Allumée environ 1 seconde après une émission | La console a répondu. |
| Flash court répété après une émission | La console n'a pas répondu. |

## En cas de doute

1. Vérifier le mode de la console.
2. Vérifier si la LED centrale signale un défaut.
3. Vérifier la LED de la zone concernée.
4. Vérifier l'écran du thermomètre.
5. Si un thermomètre ou un détecteur de fenêtre semble perdu, refaire l'appairage.
