jsdenim/thermonuino/tests/thermonuino-autre/README.md

# thermonuino
Centrale d'installation à Fil Pilote, en Arduino
