jsdenim/thermonuino/tests/thermonuino-autre/pilote-bt/info.md

Téléchargement Time@1.6.1
Time@1.6.0
Installing Time@1.6.1
Installed Time@1.6.1
