jsdenim/thermonuino/(list of files, drawings)

Other design files:
tests/Thermonuino 2/Centrale/Centrale-Commande.fzz
tests/Thermonuino 2/Centrale/Centrale-DIN.fzz
tests/Thermonuino 2/Stations/Projet Fritzing.fzz
