jsdenim/thermonuino/main/modules/sonde/sonde.ino

/*
  Thermonuino - module sonde

  Base de production :
    - affichage eInk GoodDisplay GDEM0097T61 ;
    - page HOME de l'interface sonde ;
    - eInk remis en deep sleep apres mise a jour.

  ATmega328P 3.3 V / 8 MHz.
*/

#include <SPI.h>
#include <Wire.h>
#include <EEPROM.h>
#include <avr/wdt.h>
#include <ThermioRfCc1101.h>
#include <ThermioRfFrame.h>
#include <ThermioRfIds.h>
#include <ThermioSlaveLink.h>
#include <ThermioSlavePower.h>

#include "SondeBatteryService.h"
#include "SondeDataService.h"
#include "SondeInputService.h"
#include "SondeRfStatusService.h"
#include "SondeUi.h"
#include "graphics/ThermioEink097.h"

constexpr uint8_t PIN_LED = 5;       // PCINT21 / PD5 / D5
constexpr uint8_t PIN_RF_CSN = 10;   // PCINT2 / PB2 / D10
constexpr uint8_t PIN_EPD_BUSY = A2; // PCINT10 / PC2 / A2
constexpr uint8_t PIN_EPD_RST = 4;   // PCINT20 / PD4 / D4
constexpr uint8_t PIN_EPD_DC = 3;    // PCINT19 / PD3 / D3
constexpr uint8_t PIN_EPD_CS = 6;    // PCINT22 / PD6 / D6
constexpr uint8_t PIN_BAT_SENS = A0;  // PCINT8 / PC0 / A0
constexpr uint8_t PIN_BODYDETECT = 7; // PCINT23 / PD7 / D7
constexpr uint8_t PIN_CMD_SENS1 = 0;  // PCINT16 / PD0 / D0, actif GND
constexpr uint8_t PIN_CMD_SENS2 = A1; // PCINT9 / PC1 / A1, actif GND
constexpr uint8_t PIN_CMD_BTN = A3;   // PCINT11 / PC3 / A3, actif GND
constexpr uint8_t PIN_WAKE = 2;       // PCINT18 / PD2 / D2
constexpr uint8_t PIN_RF_GDO0 = 9;     // PCINT1 / PB1 / D9
constexpr uint8_t PIN_RF_MOSI = 11;    // PCINT3 / PB3 / D11
constexpr uint8_t PIN_RF_MISO = 12;    // PCINT4 / PB4 / D12
constexpr uint8_t PIN_RF_SCK = 13;     // PCINT5 / PB5 / D13

constexpr UiPage FORCE_SCREEN_TEST_PAGE = UI_PAGE_HOME;
constexpr bool ENABLE_RF_STARTUP_SELF_TEST = true;
constexpr bool FAST_SETPOINT_ENTRY_TEST = true;
constexpr uint32_t EPD_SPI_HZ = 2000000;
constexpr uint16_t RF_DEFAULT_NODE_ID = 0x0501;
constexpr uint8_t RF_ASSOC_ZONE_COUNT = 4;
constexpr uint32_t RF_CONSOLE_LEARN_WINDOW_MS = 180000;
constexpr uint16_t RF_REPORT_INTERVAL_WATCHDOG_TICKS = 8; // ~64 s for the current test phase.
constexpr uint16_t RF_STARTUP_AUTO_REPORT_DELAY_WATCHDOG_TICKS = 2; // ~16 s
constexpr uint16_t RF_CHANNEL_LISTEN_MS = 30;
constexpr uint16_t RF_ACK_TIMEOUT_MS = 2000;
constexpr uint16_t RF_RX_SETTLE_MS = 50;
constexpr uint16_t RF_TX_COMPLETE_TIMEOUT_MS = 350;
constexpr uint8_t RF_MAX_ATTEMPTS = 6;
constexpr uint8_t RF_TX_COPIES_PER_ATTEMPT = 3;
constexpr uint16_t RF_TX_COPY_GAP_MS = 60;
constexpr uint16_t RF_BACKOFF_MIN_MS = 100;
constexpr uint16_t RF_BACKOFF_SPAN_MS = 500;
constexpr uint16_t RF_BACKOFF_STEP_MS = 150;
constexpr int16_t SETPOINT_STEP_DECI_C = 5;
constexpr int16_t SETPOINT_MIN_DECI_C = 50;
constexpr int16_t SETPOINT_MAX_DECI_C = 300;
constexpr int16_t VACATION_SETPOINT_DEFAULT_DECI_C = 170;
constexpr int16_t TEMP_CHANGE_RF_MAX_DECI_C = 230;
constexpr uint16_t CRITICAL_BATTERY_REPORT_WATCHDOG_TICKS = 450; // ~1 h.
constexpr uint8_t CRITICAL_BATTERY_RETRY_WATCHDOG_TICKS = 8; // ~1 min.
constexpr uint32_t SENSOR_PAUSE_AFTER_INPUT_MS = 120000;
constexpr uint32_t SETPOINT_EDIT_TIMEOUT_MS = 10000;
constexpr uint32_t MENU_IDLE_TIMEOUT_MS = 60000;
constexpr uint32_t CENTER_LONG_PRESS_MS = 3000;
constexpr uint8_t TEMPERATURE_REFRESH_WATCHDOG_TICKS = 8; // 8 x 8 s ~= 1 min.
constexpr uint8_t FULL_PARTIAL_REFRESH_X = 0;
constexpr uint8_t FULL_PARTIAL_REFRESH_Y = 0;
constexpr uint8_t FULL_PARTIAL_REFRESH_W = ThermioEink097::FrontWidth;
constexpr uint8_t FULL_PARTIAL_REFRESH_H = ThermioEink097::FrontHeight;
constexpr uint8_t HOME_DIGITS_REFRESH_X = 0;
constexpr uint8_t HOME_DIGITS_REFRESH_Y = 18;
constexpr uint8_t HOME_DIGITS_REFRESH_W = ThermioEink097::FrontWidth;
constexpr uint8_t HOME_DIGITS_REFRESH_H = 56;
constexpr uint8_t SETPOINT_SCREEN_REFRESH_X = 0;
constexpr uint8_t SETPOINT_SCREEN_REFRESH_Y = 0;
constexpr uint8_t SETPOINT_SCREEN_REFRESH_W = ThermioEink097::FrontWidth;
constexpr uint8_t SETPOINT_SCREEN_REFRESH_H = 74;
constexpr uint8_t FULL_REFRESH_PENDING_X = 0;
constexpr uint8_t FULL_REFRESH_PENDING_Y = 29;
constexpr uint8_t FULL_REFRESH_PENDING_W = ThermioEink097::FrontWidth;
constexpr uint8_t FULL_REFRESH_PENDING_H = 30;

enum ConsoleGlobalMode : uint8_t {
  CONSOLE_MODE_NORMAL = 0,
  CONSOLE_MODE_PLUS = 1,
  CONSOLE_MODE_MOINS = 2,
  CONSOLE_MODE_DOUCHE = 3,
  CONSOLE_MODE_STOP = 4,
  CONSOLE_MODE_VACATION = 5
};

constexpr ThermioRfIds::EepromSlot EEPROM_CONSOLE_ID = {
  0, 1, 2, 3, 0x54, 0x43
};

constexpr ThermioRfIds::EepromSlot EEPROM_NODE_ID = {
  4, 5, 6, 7, 0x54, 0x4E
};

const ThermioEink097::Pins einkPins = {
  PIN_EPD_CS,
  PIN_EPD_DC,
  PIN_EPD_RST,
  PIN_EPD_BUSY,
  PIN_RF_CSN
};

const ThermioRfCc1101::Pins rfPins = {
  PIN_RF_CSN,
  PIN_RF_GDO0,
  PIN_RF_MOSI,
  PIN_RF_MISO,
  PIN_RF_SCK
};

ThermioEink097 eink(einkPins, SPISettings(EPD_SPI_HZ, MSBFIRST, SPI_MODE0));
ThermioRfCc1101 radio(rfPins, SPISettings(1000000, MSBFIRST, SPI_MODE0));
ThermioSlaveLink link(RF_ASSOC_ZONE_COUNT);
SondeBatteryService batteryService({PIN_BAT_SENS});
SondeDataService dataService;
SondeInputService inputService({
  PIN_BODYDETECT,
  PIN_CMD_SENS1,
  PIN_CMD_SENS2,
  PIN_CMD_BTN,
  PIN_WAKE
});
SondeRfStatusService rfStatusService(radio);

bool lastDisplayOk = false;
UiState displayedUi = ui;
uint32_t criticalBatteryReportUntilWatchdogTick = 0;
uint32_t criticalBatteryNextReportWatchdogTick = 0;
uint32_t setpointEditUntilAt = 0;
uint32_t nextSetpointDueAtWatchdogTick = 0;
bool armSetpointEditTimeoutAfterRefresh = false;
bool setpointEditEntered = false;
bool batteryTerminalMode = false;
bool startupTerminalMode = false;
uint8_t temperatureWatchdogTicks = 0;
uint32_t awakeWatchdogTicks = 0;
uint32_t autoReportEnabledAtWatchdogTick = 0;
uint16_t rfReportIntervalWatchdogTicks = RF_REPORT_INTERVAL_WATCHDOG_TICKS;
uint8_t rfSequence = 0;
uint8_t presenceCountSinceAck = 0;
int8_t pendingUserDeltaSteps = 0;
uint8_t pendingAdminRequest = ThermioRfFrame::AdminNone;
bool pendingRfReport = false;
bool setpointReportPending = false;
bool pendingAhtOffsetReport = false;
bool pairingRequestActive = false;
bool pairingSendInProgress = false;
bool pairingLastOk = false;
bool consoleCommTestInProgress = false;
uint32_t menuLastInteractionAt = 0;
uint32_t centerPressedAt = 0;
bool centerWasPressed = false;
bool centerLongHandled = false;

void ledOn() {
  digitalWrite(PIN_LED, HIGH);
}

void ledOff() {
  digitalWrite(PIN_LED, LOW);
}

void isolateRfSpi() {
  digitalWrite(PIN_RF_CSN, HIGH);
}

void clearLocalEeprom() {
  for (uint16_t address = 0; address < EEPROM.length(); address++) {
    EEPROM.update(address, 0xFF);
  }
  link.clearConsoleId();
}

void waitForNodeIdCreation() {
  while (digitalRead(PIN_CMD_BTN) == LOW) {
    ledOn();
    delay(80);
    ledOff();
    delay(220);
  }

  while (digitalRead(PIN_CMD_BTN) != LOW) {
    ledOn();
    delay(40);
    ledOff();
    delay(460);
  }

  const uint16_t nodeId = ThermioRfIds::generate(PIN_BAT_SENS, RF_DEFAULT_NODE_ID);
  ThermioRfIds::save(EEPROM_NODE_ID, nodeId);
  link.setLocalId(nodeId);
  for (uint8_t i = 0; i < 3; i++) {
    ledOn();
    delay(120);
    ledOff();
    delay(120);
  }
  while (digitalRead(PIN_CMD_BTN) == LOW) {
    delay(10);
  }
}

bool consumeTemperatureRefreshWake(uint16_t watchdogTicks) {
  if (watchdogTicks == 0) {
    return false;
  }

  if (watchdogTicks >= TEMPERATURE_REFRESH_WATCHDOG_TICKS ||
      temperatureWatchdogTicks + watchdogTicks >= TEMPERATURE_REFRESH_WATCHDOG_TICKS) {
    temperatureWatchdogTicks = 0;
    return true;
  }

  temperatureWatchdogTicks += watchdogTicks;
  return false;
}

void sleepWhenIdle() {
  ledOff();
  isolateRfSpi();
  radio.sleep();
  ThermioSlavePower::sleepPowerDown(false);
}

bool fullRefreshPendingPixel(uint16_t x, uint16_t y, void *context) {
  (void)context;
  if (y < FULL_REFRESH_PENDING_Y ||
      y >= (uint16_t)FULL_REFRESH_PENDING_Y + FULL_REFRESH_PENDING_H) {
    return false;
  }

  const uint8_t stripe = (x + y * 2) % 18;
  return stripe < 5;
}

void syncUiFromDataService() {
  ui.currentTempKnown = dataService.currentTempKnown();
  if (ui.currentTempKnown) {
    ui.currentTempDeciC = dataService.currentTempDeciC();
    ui.rawTempDeciC = dataService.rawTempDeciC();
  }
  ui.humidityKnown = dataService.humidityKnown();
  if (ui.humidityKnown) {
    ui.humidityDeciPct = dataService.humidityDeciPct();
  }
  ui.ahtOffsetDeciC = dataService.temperatureOffsetDeciC();
  ui.batteryMv = batteryService.batteryMv();
  ui.batteryLow = batteryService.batteryLow();
  ui.batteryCritical = batteryService.batteryCritical();
  ui.rfSpiOk = rfStatusService.spiOk();
  ui.consoleOk = rfStatusService.consoleOk(awakeWatchdogTicks);
  ui.localRfId = link.localId();
  ui.consoleRfId = link.consoleId();
  ui.assignedZone = link.assignedZone();
  ui.pairingZoneRequest = link.pairZoneRequest();
  ui.pairingActive = pairingRequestActive;
  ui.pairingSending = pairingSendInProgress;
  ui.pairingOk = pairingLastOk;
  ui.consoleCommTesting = consoleCommTestInProgress;
  ui.resetZonePending = pendingAdminRequest == ThermioRfFrame::AdminClearZoneLearning;
  ui.resetGlobalPending = pendingAdminRequest == ThermioRfFrame::AdminClearAllLearning;
  ui.loadTypicalWeekPending = pendingAdminRequest == ThermioRfFrame::AdminLoadTypicalWeek;
}

void capturePresenceForReport() {
  const uint8_t detected = inputService.consumeMotionEvents();
  const uint16_t total = (uint16_t)presenceCountSinceAck + detected;
  presenceCountSinceAck = total > 255 ? 255 : (uint8_t)total;
}

void markPresenceForReport() {
  if (presenceCountSinceAck < 255) {
    presenceCountSinceAck++;
  }
}

bool temperatureChangeShouldTriggerRfReport() {
  return dataService.currentTempKnown() &&
      dataService.currentTempDeciC() <= TEMP_CHANGE_RF_MAX_DECI_C;
}

uint16_t nextReportDelayToWatchdogTicks(uint16_t seconds) {
  uint32_t ticks = ((uint32_t)seconds + 7) / 8;
  if (ticks < 1) {
    ticks = 1;
  }
  if (ticks > ThermioSlaveLink::ConsoleOfflineRetryWatchdogTicks) {
    ticks = ThermioSlaveLink::ConsoleOfflineRetryWatchdogTicks;
  }
  return ticks;
}

bool nextSetpointIsDue() {
  if (!ui.hasNextSetpoint || ui.nextSetpointDelayMin == 0) {
    return false;
  }
  return (int32_t)(awakeWatchdogTicks - nextSetpointDueAtWatchdogTick) >= 0;
}

bool applyDueNextSetpoint() {
  if (!nextSetpointIsDue()) {
    return false;
  }
  if (ui.setpointDeciC == ui.nextSetpointDeciC) {
    ui.hasNextSetpoint = false;
    return false;
  }
  ui.setpointDeciC = ui.nextSetpointDeciC;
  ui.hasNextSetpoint = false;
  return true;
}

uint8_t buildReportPacket(uint8_t *packet, uint8_t sequence) {
  ThermioRfFrame::Header header;
  header.frameType = ThermioRfFrame::FrameReport;
  header.sourceId = link.localId();
  header.targetId = link.reportTargetId();
  header.sequence = sequence;
  header.ackSequence = 0xFF;
  header.payloadLen = ThermioRfFrame::ReportPayloadLen;
  ThermioRfFrame::writeHeader(packet, header);

  ThermioRfFrame::Report report;
  report.deviceType = ThermioRfFrame::DeviceSonde;
  report.batteryMv = batteryService.batteryMv();
  report.pairZoneRequest = pairingRequestActive ? link.pairZoneRequest() : 0;
  report.adminRequest = pairingRequestActive ?
      (uint8_t)ThermioRfFrame::AdminPair : pendingAdminRequest;
  report.userDeltaSteps = pendingUserDeltaSteps;
  report.hasSetpoint = true;
  report.setpointDeciC = ui.setpointDeciC;
  report.learningEnabled = ui.learningEnabled;
  report.hasVacationSetpoint =
      pendingAdminRequest == ThermioRfFrame::AdminSetVacationSetpoint;
  report.vacationSetpointDeciC = ui.vacationSetpointDeciC;
  report.hasAhtOffset = pendingAhtOffsetReport;
  report.ahtOffsetDeciC = dataService.temperatureOffsetDeciC();
  report.hasHumidity = dataService.humidityKnown();
  report.humidityDeciPct = report.hasHumidity ? dataService.humidityDeciPct() : 0;
  report.tempCount = dataService.currentTempKnown() ? 1 : 0;
  if (report.tempCount > 0) {
    report.temperaturesDeciC[0] = dataService.currentTempDeciC();
  }
  report.presenceCount = presenceCountSinceAck;
  report.doorToggleCount = 0;
  report.doorOpen = false;
  ThermioRfFrame::encodeReportPayload(packet + ThermioRfFrame::HeaderLen, report);
  return ThermioRfFrame::HeaderLen + ThermioRfFrame::ReportPayloadLen;
}

bool syncPageFromConsoleMode(uint8_t globalMode) {
  const UiPage previousPage = ui.page;
  if (batteryTerminalMode || ui.page == UI_PAGE_RF_ERROR || ui.page == UI_PAGE_BATTERY_DEAD) {
    return false;
  }

  if (globalMode == CONSOLE_MODE_STOP) {
    ui.page = UI_PAGE_STOP;
    ui.setpointEditing = false;
    ui.menuInSubmenu = false;
    ui.menuEditing = false;
    ui.menuSubPage = UI_SUB_NONE;
  } else if (globalMode == CONSOLE_MODE_VACATION) {
    ui.page = UI_PAGE_VACATION;
    ui.setpointEditing = false;
    ui.menuInSubmenu = false;
    ui.menuEditing = false;
    ui.menuSubPage = UI_SUB_NONE;
  } else if (ui.page == UI_PAGE_STOP ||
             ui.page == UI_PAGE_VACATION ||
             ui.page == UI_PAGE_CONSOLE_LOST) {
    ui.page = UI_PAGE_HOME;
  }

  return ui.page != previousPage;
}

bool showConsoleLostPage() {
  if (batteryTerminalMode ||
      ui.page == UI_PAGE_RF_ERROR ||
      ui.page == UI_PAGE_BATTERY_DEAD ||
      ui.page == UI_PAGE_CONSOLE_LOST) {
    return false;
  }

  ui.page = UI_PAGE_CONSOLE_LOST;
  ui.setpointEditing = false;
  ui.menuInSubmenu = false;
  ui.menuEditing = false;
  ui.menuSubPage = UI_SUB_NONE;
  return true;
}

bool applyConsoleResponse(const ThermioRfFrame::Response &response, uint32_t now) {
  bool displayChanged = false;
  const uint8_t previousAssignedZone = link.assignedZone();
  const uint8_t previousGlobalMode = ui.lastGlobalMode;

  if (response.assignedZone >= 1 && response.assignedZone <= RF_ASSOC_ZONE_COUNT) {
    link.markAckReceived(response.assignedZone);
  } else {
    link.markAckReceived(0);
  }

  if (response.nextReportDelayS > 0) {
    rfReportIntervalWatchdogTicks = nextReportDelayToWatchdogTicks(response.nextReportDelayS);
  }

  const int16_t previousSetpoint = ui.setpointDeciC;
  const int16_t previousNextSetpoint = ui.nextSetpointDeciC;
  const int16_t previousVacationSetpoint = ui.vacationSetpointDeciC;
  const uint16_t previousNextSetpointDelayMin = ui.nextSetpointDelayMin;
  const bool previousHasNextSetpoint = ui.hasNextSetpoint;
  const int16_t previousOffset = dataService.temperatureOffsetDeciC();
  const bool previousConsoleOk = rfStatusService.consoleOk(awakeWatchdogTicks);
  const bool previousLearningEnabled = ui.learningEnabled;

  if (!ui.setpointEditing) {
    ui.setpointDeciC = response.currentSetpointDeciC;
  }
  ui.lastGlobalMode = response.globalMode;
  displayChanged = syncPageFromConsoleMode(response.globalMode);
  ui.zoneDoorOpen = response.zoneDoorOpen;
  ui.heatActive = response.heatActive;
  ui.heatLastHour = (response.commandFlags & ThermioRfFrame::ResponseFlagHeatLastHour) != 0;
  ui.learningEnabled = (response.commandFlags & ThermioRfFrame::ResponseFlagLearningDisabled) == 0;
  ui.hasNextSetpoint = response.hasNextSetpoint;
  ui.nextSetpointDeciC = response.nextSetpointDeciC;
  ui.nextSetpointDelayMin = response.nextSetpointDelayMin;
  ui.vacationSetpointDeciC = response.vacationSetpointDeciC;
  if (response.assignedZone == 0 && !pairingRequestActive && ui.page != UI_PAGE_MENU) {
    openPairingScreen();
    displayChanged = true;
  }
  if (response.hasNextSetpoint) {
    const uint32_t delayTicks =
        ((uint32_t)response.nextSetpointDelayMin * 60UL + 7UL) / 8UL;
    nextSetpointDueAtWatchdogTick = awakeWatchdogTicks + delayTicks;
  }
  dataService.setTemperatureOffsetDeciC(response.ahtOffsetDeciC);
  rfStatusService.recordConsoleResponse(awakeWatchdogTicks);

  if (previousOffset != response.ahtOffsetDeciC) {
    dataService.update(now, true);
  }

  displayChanged = displayChanged ||
      previousConsoleOk != rfStatusService.consoleOk(awakeWatchdogTicks) ||
      previousAssignedZone != link.assignedZone() ||
      previousGlobalMode != response.globalMode ||
      previousOffset != response.ahtOffsetDeciC ||
      previousLearningEnabled != ui.learningEnabled ||
      previousHasNextSetpoint != ui.hasNextSetpoint ||
      previousNextSetpoint != ui.nextSetpointDeciC ||
      previousNextSetpointDelayMin != ui.nextSetpointDelayMin ||
      previousVacationSetpoint != ui.vacationSetpointDeciC ||
      previousSetpoint != ui.setpointDeciC;
  return displayChanged;
}

bool readAck(uint8_t expectedSequence, bool &displayChanged) {
  if (radio.rxOverflow()) {
    radio.flushRx();
    radio.strobeRx();
    return false;
  }

  const uint8_t expectedLength = ThermioRfFrame::HeaderLen + ThermioRfFrame::ResponsePayloadLen;
  if (radio.rxBytes() < expectedLength + 1) {
    return false;
  }

  uint8_t packet[ThermioRfFrame::MaxPacketLen] = {0};
  const uint8_t length = radio.readPacket(packet, sizeof(packet));
  ThermioRfFrame::Header header;
  if (!ThermioRfFrame::readHeader(packet, length, header) ||
      header.frameType != ThermioRfFrame::FrameResponse ||
      header.targetId != link.localId() ||
      header.ackSequence != expectedSequence ||
      header.sourceId == link.localId()) {
    return false;
  }

  const uint32_t now = millis();
  const bool consoleIdCanBeUpdated =
      now < RF_CONSOLE_LEARN_WINDOW_MS &&
      header.sourceId != ThermioRfFrame::BroadcastId &&
      header.sourceId != link.localId();
  if (link.consoleIdKnown() &&
      header.sourceId != link.consoleId() &&
      !consoleIdCanBeUpdated) {
    return false;
  }

  ThermioRfFrame::Response response;
  if (!ThermioRfFrame::decodeResponse(packet, length, response, RF_ASSOC_ZONE_COUNT)) {
    return false;
  }

  if ((!link.consoleIdKnown() || header.sourceId != link.consoleId()) &&
      consoleIdCanBeUpdated) {
    link.setConsoleId(header.sourceId);
    ThermioRfIds::save(EEPROM_CONSOLE_ID, header.sourceId);
  }

  displayChanged = applyConsoleResponse(response, now) || displayChanged;
  presenceCountSinceAck = 0;
  pendingUserDeltaSteps = 0;
  pendingAhtOffsetReport = false;
  pendingAdminRequest = ThermioRfFrame::AdminNone;
  return true;
}

bool uiInputPending() {
  return inputService.hasPendingEvent() || inputService.centerPressed();
}

bool runRfExchange(bool *ackReceived = nullptr,
                   bool *abortedByUiOut = nullptr,
                   bool abortOnUi = true) {
  radio.wake();
  SPI.beginTransaction(SPISettings(1000000, MSBFIRST, SPI_MODE0));
  radio.configureTestRadio(ThermioRfFrame::MaxPacketLen);

  bool received = false;
  bool displayChanged = false;
  bool abortedByUi = false;
  const uint8_t sequence = rfSequence++;
  for (uint8_t attempt = 0; attempt < RF_MAX_ATTEMPTS && !received; attempt++) {
    if (abortOnUi && uiInputPending()) {
      abortedByUi = true;
      break;
    }
    if (radio.channelBusy(RF_CHANNEL_LISTEN_MS)) {
      delay(random(RF_BACKOFF_MIN_MS, RF_BACKOFF_MIN_MS + RF_BACKOFF_SPAN_MS + 1) + attempt * RF_BACKOFF_STEP_MS);
      if (abortOnUi && uiInputPending()) {
        abortedByUi = true;
        break;
      }
    }

    for (uint8_t copy = 0; copy < RF_TX_COPIES_PER_ATTEMPT; copy++) {
      if (abortOnUi && uiInputPending()) {
        abortedByUi = true;
        break;
      }
      uint8_t packet[ThermioRfFrame::MaxPacketLen] = {0};
      const uint8_t length = buildReportPacket(packet, sequence);
      radio.writePacket(packet, length);
      radio.waitTxComplete(RF_TX_COMPLETE_TIMEOUT_MS);
      if (copy + 1 < RF_TX_COPIES_PER_ATTEMPT) {
        delay(RF_TX_COPY_GAP_MS);
      }
    }
    if (abortOnUi && uiInputPending()) {
      abortedByUi = true;
      break;
    }

    radio.strobeRx();
    delay(RF_RX_SETTLE_MS);
    const uint32_t rxStartedAt = millis();
    while ((uint32_t)(millis() - rxStartedAt) < RF_ACK_TIMEOUT_MS) {
      if (abortOnUi && uiInputPending()) {
        abortedByUi = true;
        break;
      }
      if (readAck(sequence, displayChanged)) {
        received = true;
        break;
      }
      delay(10);
    }

    if (!received) {
      delay(random(RF_BACKOFF_MIN_MS, RF_BACKOFF_MIN_MS + RF_BACKOFF_SPAN_MS + 1) + attempt * RF_BACKOFF_STEP_MS);
    }
  }

  radio.idle();
  SPI.endTransaction();
  radio.sleep();
  if (!received && !abortedByUi) {
    link.markAckMissed(awakeWatchdogTicks);
    if (link.consoleOffline()) {
      displayChanged = showConsoleLostPage() || displayChanged;
    }
  }
  if (ackReceived != nullptr) {
    *ackReceived = received;
  }
  if (abortedByUiOut != nullptr) {
    *abortedByUiOut = abortedByUi;
  }
  return displayChanged;
}

void touchMenu(uint32_t now) {
  menuLastInteractionAt = now;
}

void enterMenu(uint32_t now) {
  ui.page = UI_PAGE_MENU;
  ui.menuInSubmenu = false;
  ui.menuEditing = false;
  if (ui.setpointEditing && setpointReportPending) {
    pendingRfReport = true;
    setpointReportPending = false;
  }
  ui.setpointEditing = false;
  ui.menuSubPage = UI_SUB_NONE;
  touchMenu(now);
  updateDisplay();
}

void exitMenu() {
  ui.page = UI_PAGE_HOME;
  ui.menuInSubmenu = false;
  ui.menuEditing = false;
  ui.menuSubPage = UI_SUB_NONE;
  updateDisplay();
}

void refreshMenuFast() {
  updateDisplayPartialCurrentOnly(FULL_PARTIAL_REFRESH_X,
                                  FULL_PARTIAL_REFRESH_Y,
                                  FULL_PARTIAL_REFRESH_W,
                                  FULL_PARTIAL_REFRESH_H);
}

void moveMenuMain(int8_t direction) {
  int8_t next = (int8_t)ui.menuPage + direction;
  if (next < 0) {
    next = UI_MENU_COUNT - 1;
  } else if (next >= UI_MENU_COUNT) {
    next = 0;
  }
  ui.menuPage = (UiMenuPage)next;
  ui.menuSubPage = UI_SUB_NONE;
}

void moveMenuSub(int8_t direction) {
  const uint8_t count = uiMenuSubCount(ui.menuPage);
  if (count == 0) {
    return;
  }

  int8_t index = uiMenuSubIndex(ui.menuPage, ui.menuSubPage);
  if (index < 0) {
    index = 0;
  } else {
    index += direction;
  }
  if (index < 0) {
    index = count - 1;
  } else if (index >= count) {
    index = 0;
  }
  ui.menuSubPage = uiMenuSubAt(ui.menuPage, index);
}

bool currentMenuSubEditable() {
  return ui.menuSubPage == UI_SUB_THERMO_OFFSET ||
      ui.menuSubPage == UI_SUB_THERMO_VACATION ||
      ui.menuSubPage == UI_SUB_LEARNING_ACTIVE ||
      ui.menuSubPage == UI_SUB_CONSOLE_PAIRING;
}

bool currentMenuSubAction() {
  return ui.menuSubPage == UI_SUB_LEARNING_RESET_ZONE ||
      ui.menuSubPage == UI_SUB_LEARNING_CONSOLE_COMM ||
      ui.menuSubPage == UI_SUB_LEARNING_RESET_GLOBAL ||
      ui.menuSubPage == UI_SUB_LEARNING_LOAD_TYPICAL;
}

void beginPairingEdit() {
  uint8_t zone = link.pairZoneRequest();
  if (zone < 1 || zone > RF_ASSOC_ZONE_COUNT) {
    zone = link.assignedZone();
  }
  if (zone < 1 || zone > RF_ASSOC_ZONE_COUNT) {
    zone = 1;
  }
  link.setPairZoneRequest(zone);
  pairingRequestActive = true;
  pairingLastOk = false;
  pendingRfReport = true;
}

void endPairingEdit() {
  pairingSendInProgress = true;
  pairingLastOk = false;
  pendingRfReport = false;
  updateDisplay();

  bool ackReceived = false;
  bool abortedByUi = false;
  link.markReportAttemptStarted(awakeWatchdogTicks);
  const bool displayChanged = runRfExchange(&ackReceived, &abortedByUi, false);

  pairingSendInProgress = false;
  pairingLastOk = ackReceived;
  pairingRequestActive = abortedByUi;
  pendingRfReport = abortedByUi;
  (void)displayChanged;
  updateDisplay();
}

void changePairingZone(int8_t direction) {
  int8_t zone = link.pairZoneRequest();
  if (zone < 1 || zone > RF_ASSOC_ZONE_COUNT) {
    zone = link.assignedZone();
  }
  if (zone < 1 || zone > RF_ASSOC_ZONE_COUNT) {
    zone = 1;
  }
  zone += direction;
  if (zone < 1) {
    zone = RF_ASSOC_ZONE_COUNT;
  } else if (zone > RF_ASSOC_ZONE_COUNT) {
    zone = 1;
  }
  link.setPairZoneRequest(zone);
  pairingRequestActive = true;
  pairingLastOk = false;
  pendingRfReport = true;
}

void cancelPairingRequest() {
  pairingRequestActive = false;
  pairingSendInProgress = false;
}

void openPairingScreen() {
  beginPairingEdit();
  ui.page = UI_PAGE_MENU;
  ui.menuPage = UI_MENU_LEARNING;
  ui.menuInSubmenu = true;
  ui.menuEditing = true;
  ui.menuSubPage = UI_SUB_CONSOLE_PAIRING;
}

void sendAdminRequest(uint8_t request) {
  pendingAdminRequest = request;
  pendingRfReport = false;
  updateDisplay();

  bool ackReceived = false;
  link.markReportAttemptStarted(awakeWatchdogTicks);
  (void)runRfExchange(&ackReceived, nullptr, false);

  pendingRfReport = !ackReceived;
  updateDisplay();
}

void testConsoleCommunication() {
  consoleCommTestInProgress = true;
  pendingRfReport = false;
  updateDisplay();

  bool ackReceived = false;
  link.markReportAttemptStarted(awakeWatchdogTicks);
  const bool displayChanged = runRfExchange(&ackReceived, nullptr, false);

  consoleCommTestInProgress = false;
  pendingRfReport = !ackReceived;
  (void)displayChanged;
  updateDisplay();
}

void handleMenuCenterClick(uint32_t now) {
  touchMenu(now);
  if (!ui.menuInSubmenu) {
    if (uiMenuSubCount(ui.menuPage) == 0) {
      return;
    }
    ui.menuInSubmenu = true;
    ui.menuEditing = false;
    ui.menuSubPage = uiMenuSubAt(ui.menuPage, 0);
    refreshMenuFast();
    return;
  }

  if (currentMenuSubEditable()) {
    if (ui.menuSubPage == UI_SUB_LEARNING_ACTIVE) {
      ui.learningEnabled = !ui.learningEnabled;
      pendingRfReport = true;
      updateDisplay();
      return;
    }

    ui.menuEditing = !ui.menuEditing;
    if (!ui.menuEditing) {
      if (ui.menuSubPage == UI_SUB_CONSOLE_PAIRING) {
        endPairingEdit();
      } else if (ui.menuSubPage == UI_SUB_THERMO_VACATION) {
        pendingAdminRequest = ThermioRfFrame::AdminSetVacationSetpoint;
        pendingRfReport = true;
      }
      updateDisplay();
    } else {
      if (ui.menuSubPage == UI_SUB_CONSOLE_PAIRING) {
        beginPairingEdit();
      }
      refreshMenuFast();
    }
    return;
  }

  if (currentMenuSubAction()) {
    if (ui.menuSubPage == UI_SUB_LEARNING_CONSOLE_COMM) {
      testConsoleCommunication();
      return;
    }

    uint8_t request = ThermioRfFrame::AdminClearAllLearning;
    if (ui.menuSubPage == UI_SUB_LEARNING_RESET_ZONE) {
      request = ThermioRfFrame::AdminClearZoneLearning;
    } else if (ui.menuSubPage == UI_SUB_LEARNING_LOAD_TYPICAL) {
      request = ThermioRfFrame::AdminLoadTypicalWeek;
    }
    sendAdminRequest(request);
    return;
  }

  ui.menuInSubmenu = false;
  ui.menuEditing = false;
  ui.menuSubPage = UI_SUB_NONE;
  updateDisplay();
}

bool updateCenterButton(uint32_t now) {
  const bool pressed = inputService.centerPressed();
  if (pressed && !centerWasPressed) {
    centerWasPressed = true;
    centerPressedAt = now;
    centerLongHandled = false;
  }

  if (pressed && !centerLongHandled &&
      (uint32_t)(now - centerPressedAt) >= CENTER_LONG_PRESS_MS) {
    centerLongHandled = true;
    if (ui.page == UI_PAGE_HOME) {
      enterMenu(now);
    } else if (ui.page == UI_PAGE_MENU) {
      exitMenu();
    }
    return true;
  }

  if (!pressed && centerWasPressed) {
    const bool shortPress = !centerLongHandled;
    centerWasPressed = false;
    centerLongHandled = false;
    if (shortPress && ui.page == UI_PAGE_HOME && ui.setpointEditing) {
      cancelPairingRequest();
      pendingAdminRequest = ThermioRfFrame::AdminSaveCurrentSetpoint;
      setpointReportPending = false;
      ui.setpointEditing = false;
      updateDisplayPartialCurrentOnly(SETPOINT_SCREEN_REFRESH_X,
                                      SETPOINT_SCREEN_REFRESH_Y,
                                      SETPOINT_SCREEN_REFRESH_W,
                                      SETPOINT_SCREEN_REFRESH_H);
      bool ackReceived = false;
      if (runRfExchange(&ackReceived, nullptr, false)) {
        updateDisplayPartial(FULL_PARTIAL_REFRESH_X,
                             FULL_PARTIAL_REFRESH_Y,
                             FULL_PARTIAL_REFRESH_W,
                             FULL_PARTIAL_REFRESH_H);
      }
      pendingRfReport = !ackReceived;
      return true;
    }
    if (shortPress && ui.page == UI_PAGE_MENU) {
      handleMenuCenterClick(now);
      return true;
    }
  }
  return false;
}

bool handleMenuInput(SondeInputEvent event, uint32_t now) {
  if (ui.page != UI_PAGE_MENU) {
    return false;
  }

  if (event == SONDE_INPUT_CENTER || event == SONDE_INPUT_NONE) {
    return false;
  }

  touchMenu(now);
  const int8_t direction = event == SONDE_INPUT_PLUS ? 1 : -1;
  if (ui.menuEditing && ui.menuSubPage == UI_SUB_THERMO_OFFSET) {
    int16_t nextOffset = ui.ahtOffsetDeciC + direction;
    if (nextOffset < -25) {
      nextOffset = -25;
    }
    if (nextOffset > 25) {
      nextOffset = 25;
    }
    dataService.setTemperatureOffsetDeciC(nextOffset);
    dataService.update(now, true);
    pendingAhtOffsetReport = true;
    pendingRfReport = true;
  } else if (ui.menuEditing && ui.menuSubPage == UI_SUB_THERMO_VACATION) {
    int16_t nextVacationSetpoint =
        ui.vacationSetpointDeciC + direction * SETPOINT_STEP_DECI_C;
    if (nextVacationSetpoint < SETPOINT_MIN_DECI_C) {
      nextVacationSetpoint = SETPOINT_MIN_DECI_C;
    }
    if (nextVacationSetpoint > SETPOINT_MAX_DECI_C) {
      nextVacationSetpoint = SETPOINT_MAX_DECI_C;
    }
    if (nextVacationSetpoint != ui.vacationSetpointDeciC) {
      ui.vacationSetpointDeciC = nextVacationSetpoint;
      pendingRfReport = true;
    }
  } else if (ui.menuEditing && ui.menuSubPage == UI_SUB_CONSOLE_PAIRING) {
    changePairingZone(direction);
  } else if (ui.menuInSubmenu) {
    moveMenuSub(direction);
  } else {
    moveMenuMain(direction);
  }
  refreshMenuFast();
  return true;
}

bool handleTerminalModeInput(SondeInputEvent event) {
  if (ui.page != UI_PAGE_STOP &&
      ui.page != UI_PAGE_VACATION &&
      ui.page != UI_PAGE_CONSOLE_LOST) {
    return false;
  }
  if (event == SONDE_INPUT_NONE) {
    return false;
  }

  ui.motionDetected = true;
  markPresenceForReport();
  link.forceRetryByUser();
  pendingRfReport = true;
  return true;
}

bool applyInputEvent(SondeInputEvent event) {
  if (ui.page != UI_PAGE_HOME) {
    return false;
  }

  if (event != SONDE_INPUT_PLUS && event != SONDE_INPUT_MINUS) {
    return false;
  }

  ui.motionDetected = true;
  markPresenceForReport();
  link.forceRetryByUser();
  cancelPairingRequest();
  dataService.pauseUntil(millis() + SENSOR_PAUSE_AFTER_INPUT_MS);
  armSetpointEditTimeoutAfterRefresh = true;

  if (!ui.setpointEditing) {
    (void)applyDueNextSetpoint();
    ui.setpointEditing = true;
    setpointEditEntered = true;
    return true;
  }

  int16_t nextSetpoint = ui.setpointDeciC;
  const int8_t deltaStep = event == SONDE_INPUT_PLUS ? 1 : -1;
  nextSetpoint += deltaStep * SETPOINT_STEP_DECI_C;
  if (nextSetpoint < SETPOINT_MIN_DECI_C) {
    nextSetpoint = SETPOINT_MIN_DECI_C;
  }
  if (nextSetpoint > SETPOINT_MAX_DECI_C) {
    nextSetpoint = SETPOINT_MAX_DECI_C;
  }
  if (nextSetpoint != ui.setpointDeciC) {
    ui.setpointDeciC = nextSetpoint;
    int16_t nextDelta = pendingUserDeltaSteps + deltaStep;
    if (nextDelta < -8) {
      nextDelta = -8;
    }
    if (nextDelta > 8) {
      nextDelta = 8;
    }
    pendingUserDeltaSteps = nextDelta;
    setpointReportPending = true;
  }
  return true;
}

void drainSetpointInputRepeats(uint32_t now) {
  if (ui.page != UI_PAGE_HOME || !ui.setpointEditing) {
    return;
  }

  for (uint8_t i = 0; i < 12; i++) {
    const SondeInputEvent event = inputService.update(now);
    if (event != SONDE_INPUT_PLUS && event != SONDE_INPUT_MINUS) {
      return;
    }
    if (!applyInputEvent(event)) {
      return;
    }
  }
}

bool enterBatteryTerminalMode() {
  if (!batteryService.batteryCritical() || batteryTerminalMode) {
    return false;
  }

  batteryTerminalMode = true;
  criticalBatteryReportUntilWatchdogTick =
      awakeWatchdogTicks + CRITICAL_BATTERY_REPORT_WATCHDOG_TICKS;
  criticalBatteryNextReportWatchdogTick =
      awakeWatchdogTicks + CRITICAL_BATTERY_RETRY_WATCHDOG_TICKS;
  pendingRfReport = true;
  ui.page = UI_PAGE_BATTERY_DEAD;
  return true;
}

void showFullRefreshPendingIndicator() {
  const bool wakeOk = eink.wakeForPartialUpdate();
  if (wakeOk) {
    eink.writeFrontImagePartial(fullRefreshPendingPixel,
                                nullptr,
                                FULL_REFRESH_PENDING_X,
                                FULL_REFRESH_PENDING_Y,
                                FULL_REFRESH_PENDING_W,
                                FULL_REFRESH_PENDING_H);
  }
  eink.sleep();
}

void updateDisplay() {
  isolateRfSpi();
  syncUiFromDataService();

  showFullRefreshPendingIndicator();

  const bool initOk = eink.init();
  ui.displayOk = initOk && lastDisplayOk;
  const bool refreshOk = eink.writeFrontImage(sondeScreenPixel, &ui);

  lastDisplayOk = initOk && refreshOk;
  ui.displayOk = lastDisplayOk;
  if (lastDisplayOk) {
    displayedUi = ui;
    if (ui.setpointEditing) {
      setpointEditUntilAt = millis() + SETPOINT_EDIT_TIMEOUT_MS;
      armSetpointEditTimeoutAfterRefresh = false;
    } else {
      armSetpointEditTimeoutAfterRefresh = false;
    }
    ledOff();
  }
  eink.sleep();
}

void updateDisplayPartial(uint8_t x, uint8_t y, uint8_t w, uint8_t h) {
  if (!lastDisplayOk) {
    updateDisplay();
    return;
  }

  isolateRfSpi();
  syncUiFromDataService();

  const bool wakeOk = eink.wakeForPartialUpdate();
  const bool refreshOk = wakeOk &&
      eink.writeFrontImagePartial(sondeScreenPixel,
                                  &displayedUi,
                                  sondeScreenPixel,
                                  &ui,
                                  x,
                                  y,
                                  w,
                                  h);

  lastDisplayOk = wakeOk && refreshOk;
  ui.displayOk = lastDisplayOk;
  if (lastDisplayOk) {
    displayedUi = ui;
    if (ui.setpointEditing) {
      setpointEditUntilAt = millis() + SETPOINT_EDIT_TIMEOUT_MS;
      armSetpointEditTimeoutAfterRefresh = false;
    } else {
      armSetpointEditTimeoutAfterRefresh = false;
    }
    ledOff();
  }
  eink.sleep();
}

void updateDisplayPartialCurrentOnly(uint8_t x, uint8_t y, uint8_t w, uint8_t h) {
  if (!lastDisplayOk) {
    updateDisplay();
    return;
  }

  isolateRfSpi();
  syncUiFromDataService();

  const bool wakeOk = eink.wakeForPartialUpdate();
  const bool refreshOk = wakeOk &&
      eink.writeFrontImagePartial(sondeScreenPixel, &ui, x, y, w, h);

  lastDisplayOk = wakeOk && refreshOk;
  ui.displayOk = lastDisplayOk;
  if (lastDisplayOk) {
    displayedUi = ui;
    if (ui.setpointEditing) {
      setpointEditUntilAt = millis() + SETPOINT_EDIT_TIMEOUT_MS;
      armSetpointEditTimeoutAfterRefresh = false;
    } else {
      armSetpointEditTimeoutAfterRefresh = false;
    }
    ledOff();
  }
  eink.sleep();
}

void setup() {
  wdt_disable();

  pinMode(PIN_LED, OUTPUT);
  pinMode(PIN_RF_CSN, OUTPUT);
  ledOff();
  isolateRfSpi();
  ui.setpointDeciC = 190;
  ui.nextSetpointDeciC = 190;
  ui.vacationSetpointDeciC = VACATION_SETPOINT_DEFAULT_DECI_C;
  ui.learningEnabled = true;

  Wire.begin();
  SPI.begin();
  eink.begin();
  inputService.begin();

  if (inputService.centerPressed()) {
    clearLocalEeprom();
  }

  uint16_t nodeId = RF_DEFAULT_NODE_ID;
  if (!ThermioRfIds::load(EEPROM_NODE_ID, nodeId)) {
    waitForNodeIdCreation();
  } else {
    link.setLocalId(nodeId);
  }

  uint16_t consoleId = ThermioRfFrame::BroadcastId;
  if (ThermioRfIds::load(EEPROM_CONSOLE_ID, consoleId, link.localId())) {
    link.setConsoleId(consoleId);
  }

  ThermioSlavePower::setupWatchdog8s();
  batteryService.begin();
  rfStatusService.begin();

  if (FORCE_SCREEN_TEST_PAGE != UI_PAGE_HOME) {
    ui.page = FORCE_SCREEN_TEST_PAGE;
    updateDisplay();
    return;
  }

  if (ENABLE_RF_STARTUP_SELF_TEST && !rfStatusService.spiOk()) {
    rfStatusService.update(awakeWatchdogTicks, true);
    if (!rfStatusService.spiOk()) {
      startupTerminalMode = true;
      ui.page = UI_PAGE_RF_ERROR;
      updateDisplay();
      return;
    }
  }

  dataService.begin();
  batteryService.update(awakeWatchdogTicks, true);
  rfStatusService.update(awakeWatchdogTicks, true);
  randomSeed(analogRead(PIN_BAT_SENS) ^ micros());
  enterBatteryTerminalMode();
  ui.motionDetected = inputService.motionDetected();
  capturePresenceForReport();
  dataService.update(millis(), true);
  pendingRfReport = true;
  bool startupAckReceived = false;
  link.markReportAttemptStarted(awakeWatchdogTicks);
  (void)runRfExchange(&startupAckReceived, nullptr, false);
  pendingRfReport = !startupAckReceived;
  autoReportEnabledAtWatchdogTick =
      awakeWatchdogTicks + RF_STARTUP_AUTO_REPORT_DELAY_WATCHDOG_TICKS;
  updateDisplay();
}

void loop() {
  if (FORCE_SCREEN_TEST_PAGE != UI_PAGE_HOME || startupTerminalMode) {
    sleepWhenIdle();
    return;
  }

  const uint16_t watchdogTicks = ThermioSlavePower::consumeWatchdogTicks();
  awakeWatchdogTicks += watchdogTicks;
  ThermioSlavePower::consumePinWake();
  const uint32_t now = millis();

  if (batteryTerminalMode) {
    if ((int32_t)(awakeWatchdogTicks - criticalBatteryReportUntilWatchdogTick) < 0) {
      const bool retryDue =
          (int32_t)(awakeWatchdogTicks - criticalBatteryNextReportWatchdogTick) >= 0;
      if (pendingRfReport || retryDue) {
        pendingRfReport = false;
        criticalBatteryNextReportWatchdogTick =
            awakeWatchdogTicks + CRITICAL_BATTERY_RETRY_WATCHDOG_TICKS;
        link.markReportAttemptStarted(awakeWatchdogTicks);
        (void)runRfExchange(nullptr, nullptr, false);
      }
    } else {
      ThermioSlavePower::disableWatchdog();
    }
    sleepWhenIdle();
    return;
  }

  const bool forceTemperatureRefresh = consumeTemperatureRefreshWake(watchdogTicks);
  bool displayNeedsRefresh = dataService.update(now, forceTemperatureRefresh);
  if (displayNeedsRefresh && temperatureChangeShouldTriggerRfReport()) {
    pendingRfReport = true;
  }
  if (batteryService.update(awakeWatchdogTicks)) {
    displayNeedsRefresh = true;
  }
  if (rfStatusService.update(awakeWatchdogTicks)) {
    displayNeedsRefresh = true;
  }
  if (!ui.setpointEditing && applyDueNextSetpoint()) {
    displayNeedsRefresh = true;
  }
  if (enterBatteryTerminalMode()) {
    displayNeedsRefresh = true;
  }

  const SondeInputEvent inputEvent = inputService.update(now, watchdogTicks);
  capturePresenceForReport();
  if (updateCenterButton(now)) {
    return;
  }

  ui.motionDetected = inputService.motionDetected();
  const bool terminalInputHandled = handleTerminalModeInput(inputEvent);
  if (!terminalInputHandled) {
    if (handleMenuInput(inputEvent, now)) {
      return;
    }

    if (ui.page == UI_PAGE_MENU) {
      if ((uint32_t)(now - menuLastInteractionAt) >= MENU_IDLE_TIMEOUT_MS) {
        exitMenu();
      }
      return;
    }
  }

  bool displayNeedsDigitsRefresh = false;
  bool displayNeedsFullRefresh = false;
  bool displayNeedsSetpointScreenRefresh = false;
  if (!terminalInputHandled && applyInputEvent(inputEvent)) {
    drainSetpointInputRepeats(now);
    if (setpointEditEntered) {
      setpointEditEntered = false;
      displayNeedsFullRefresh = !FAST_SETPOINT_ENTRY_TEST;
      displayNeedsSetpointScreenRefresh = FAST_SETPOINT_ENTRY_TEST;
    }
    if (!displayNeedsRefresh) {
      if (displayNeedsFullRefresh) {
        updateDisplay();
      } else if (displayNeedsSetpointScreenRefresh) {
        updateDisplayPartialCurrentOnly(SETPOINT_SCREEN_REFRESH_X,
                                        SETPOINT_SCREEN_REFRESH_Y,
                                        SETPOINT_SCREEN_REFRESH_W,
                                        SETPOINT_SCREEN_REFRESH_H);
      } else if (ui.setpointEditing) {
        updateDisplayPartialCurrentOnly(SETPOINT_SCREEN_REFRESH_X,
                                        SETPOINT_SCREEN_REFRESH_Y,
                                        SETPOINT_SCREEN_REFRESH_W,
                                        SETPOINT_SCREEN_REFRESH_H);
      } else {
        updateDisplayPartialCurrentOnly(HOME_DIGITS_REFRESH_X,
                                        HOME_DIGITS_REFRESH_Y,
                                        HOME_DIGITS_REFRESH_W,
                                        HOME_DIGITS_REFRESH_H);
      }
      return;
    }
    displayNeedsDigitsRefresh = !displayNeedsFullRefresh;
  }

  if (ui.setpointEditing && !armSetpointEditTimeoutAfterRefresh &&
      (int32_t)(now - setpointEditUntilAt) >= 0) {
    ui.setpointEditing = false;
    if (setpointReportPending) {
      pendingRfReport = true;
      setpointReportPending = false;
    }
    displayNeedsSetpointScreenRefresh = true;
  }

  if (displayNeedsFullRefresh) {
    updateDisplay();
  } else if (displayNeedsRefresh) {
    updateDisplayPartial(FULL_PARTIAL_REFRESH_X,
                         FULL_PARTIAL_REFRESH_Y,
                         FULL_PARTIAL_REFRESH_W,
                         FULL_PARTIAL_REFRESH_H);
  } else if (displayNeedsSetpointScreenRefresh) {
    updateDisplayPartialCurrentOnly(SETPOINT_SCREEN_REFRESH_X,
                                    SETPOINT_SCREEN_REFRESH_Y,
                                    SETPOINT_SCREEN_REFRESH_W,
                                    SETPOINT_SCREEN_REFRESH_H);
  } else if (displayNeedsDigitsRefresh) {
    if (ui.setpointEditing) {
      updateDisplayPartialCurrentOnly(SETPOINT_SCREEN_REFRESH_X,
                                      SETPOINT_SCREEN_REFRESH_Y,
                                      SETPOINT_SCREEN_REFRESH_W,
                                      SETPOINT_SCREEN_REFRESH_H);
    } else {
      updateDisplayPartialCurrentOnly(HOME_DIGITS_REFRESH_X,
                                      HOME_DIGITS_REFRESH_Y,
                                      HOME_DIGITS_REFRESH_W,
                                      HOME_DIGITS_REFRESH_H);
    }
  }

  if (lastDisplayOk) {
    ledOff();
  }
  isolateRfSpi();
  const bool autoReportDue = link.autoReportDue(
      awakeWatchdogTicks,
      autoReportEnabledAtWatchdogTick,
      rfReportIntervalWatchdogTicks);
  if (!ui.setpointEditing && !uiInputPending() && (pendingRfReport || autoReportDue)) {
    pendingRfReport = false;
    link.markReportAttemptStarted(awakeWatchdogTicks);
    bool abortedByUi = false;
    if (runRfExchange(nullptr, &abortedByUi)) {
      updateDisplayPartial(FULL_PARTIAL_REFRESH_X,
                           FULL_PARTIAL_REFRESH_Y,
                           FULL_PARTIAL_REFRESH_W,
                           FULL_PARTIAL_REFRESH_H);
    }
    if (abortedByUi) {
      pendingRfReport = true;
    }
  }
  if (ui.page == UI_PAGE_HOME && !ui.setpointEditing && !uiInputPending()) {
    sleepWhenIdle();
  }
}
