jsdenim/thermonuino/main/modules/sonde/SondeBatteryService.h

#ifndef SONDE_BATTERY_SERVICE_H
#define SONDE_BATTERY_SERVICE_H

#include <Arduino.h>

class SondeBatteryService {
public:
  struct Pins {
    uint8_t batterySense;
  };

  explicit SondeBatteryService(const Pins &pins) : pins_(pins) {
  }

  void begin();
  bool update(uint32_t watchdogTick, bool force = false);

  uint16_t batteryMv() const;
  bool batteryKnown() const;
  bool batteryLow() const;
  bool batteryCritical() const;

private:
  static const uint8_t RefreshWatchdogTicks = 38; // ~5 min at 8 s per tick.
  static const uint16_t AdcReferenceMv = 3300;
  static const uint16_t DividerMultiplier = 2;
  static const uint16_t NoBatteryThresholdMv = 500;
  static const uint16_t LowThresholdMv = 2000;
  static const uint16_t CriticalThresholdMv = 1700;

  Pins pins_;
  uint32_t nextRefreshAtWatchdogTick_ = 0;
  uint16_t batteryMv_ = 0;
  bool batteryKnown_ = false;
  bool batteryLow_ = false;
  bool batteryCritical_ = false;

  uint16_t readBatteryMv();
};

#endif
