jsdenim/thermonuino/tests/thermonuino-door-open-test/pcb_porte_ouverte_test/pcb_porte_ouverte_test.ino

/*
  Test PCB Thermonuino Porte Ouverte

  Cible: ATmega328P 3.3 V / 8 MHz.
  Pinout d'apres Specifications Thermonuio.md / PCB Porte Ouverte.

  Fonctions testees:
    - LED PCB sur PCINT11 / A3, active HIGH ;
    - DOOR_OPEN sur PCINT18 / D2, REED en parallele vers GND, actif LOW ;
    - bouton sur PCINT19 / D3, arrive a 3.3 V a l'appui, actif HIGH ;
    - CC1101 sur SPI, alimentation 3.3 V permanente.
    - sommeil ATmega + CC1101 SPWD, reveil bouton, REED ou watchdog.

  Codes LED:
    - demarrage: 1 blink court ;
    - test CC1101 OK au demarrage: 5 blinks courts ;
    - test CC1101 KO/timeout au demarrage: 2 blinks longs ;
    - REED ferme: LED fixe ;
    - bouton appuye: clignotement rapide tant que le bouton reste actif.
    - appui bouton detecte: 1 flash tres court ;
    - trame PAIR lancee: 3 flashs rapides ;
    - apres emission RF: LED allumee 1 s si ACK recu ;
    - apres emission RF sans ACK: flashs de 250 ms pendant 1 s.

  Le test SPI a des timeouts pour ne pas rester bloque si le CC1101 ne repond
  pas ou si MISO reste haut.

  Test RF portee:
    - tentative toutes les 3 s ;
    - ecoute canal avant emission ;
    - emission d'une balise puis attente courte d'un ACK ;
    - retry avec backoff aleatoire si l'ACK n'arrive pas.
*/

#include <EEPROM.h>
#include <SPI.h>
#include <avr/interrupt.h>
#include <avr/sleep.h>
#include <avr/wdt.h>

const uint8_t PIN_RF_EN = 8;       // PCINT0 / PB0 / D8
const uint8_t PIN_RF_GDO0 = 9;     // PCINT1 / PB1 / D9
const uint8_t PIN_RF_CSN = 10;     // PCINT2 / PB2 / D10
const uint8_t PIN_RF_MOSI = 11;    // PCINT3 / PB3 / D11
const uint8_t PIN_RF_MISO = 12;    // PCINT4 / PB4 / D12
const uint8_t PIN_RF_SCK = 13;     // PCINT5 / PB5 / D13

const uint8_t PIN_DOOR_OPEN = 2;   // PCINT18 / PD2 / D2, REED vers GND
const uint8_t PIN_BUTTON = 3;      // PCINT19 / PD3 / D3, appui vers 3.3 V
const uint8_t PIN_LED = A3;        // PCINT11 / PC3 / A3, active HIGH

const uint8_t CC1101_READ_BURST = 0xC0;
const uint8_t CC1101_WRITE_BURST = 0x40;
const uint8_t CC1101_PARTNUM = 0x30;
const uint8_t CC1101_VERSION = 0x31;
const uint8_t CC1101_TXFIFO = 0x3F;
const uint8_t CC1101_RXFIFO = 0x3F;
const uint8_t CC1101_PKTSTATUS = 0x38;
const uint8_t CC1101_RXBYTES = 0x3B;
const uint8_t CC1101_SRES = 0x30;
const uint8_t CC1101_SRX = 0x34;
const uint8_t CC1101_STX = 0x35;
const uint8_t CC1101_SIDLE = 0x36;
const uint8_t CC1101_SPWD = 0x39;
const uint8_t CC1101_SFRX = 0x3A;
const uint8_t CC1101_SFTX = 0x3B;

const unsigned int RF_POWER_UP_MS = 20;
const unsigned int CC1101_READY_TIMEOUT_MS = 15;
const unsigned int CC1101_TOTAL_TIMEOUT_MS = 120;
const unsigned int BUTTON_BLINK_MS = 90;
const uint16_t RF_BEACON_INTERVAL_WATCHDOG_TICKS = 3;
const uint16_t RF_STARTUP_AUTO_BEACON_DELAY_WATCHDOG_TICKS = 3;
const uint8_t RF_CONSOLE_OFFLINE_ACK_FAILURES = 10;
const uint16_t RF_CONSOLE_OFFLINE_RETRY_WATCHDOG_TICKS = 5400; // ~12 h at 8 s per tick
const unsigned long RF_CHANNEL_LISTEN_MS = 30;
const unsigned long RF_ACK_TIMEOUT_MS = 2000;
const unsigned int RF_RX_SETTLE_MS = 50;
const uint8_t RF_MAX_ATTEMPTS = 6;
const unsigned int RF_BACKOFF_MIN_MS = 100;
const unsigned int RF_BACKOFF_SPAN_MS = 500;
const unsigned int RF_BACKOFF_STEP_MS = 150;
const unsigned int RF_TX_COMPLETE_DELAY_MS = 350;
const uint8_t RF_TX_COPIES_PER_ATTEMPT = 3;
const unsigned int RF_TX_COPY_GAP_MS = 60;
const unsigned long RF_RESULT_LED_MS = 1000;
const unsigned int RF_RESULT_FAIL_ON_MS = 250;
const unsigned int BUTTON_ACCEPTED_ON_MS = 40;
const unsigned int PAIR_TX_BLINK_ON_MS = 70;
const unsigned int PAIR_TX_BLINK_OFF_MS = 70;
const unsigned long RF_CONSOLE_LEARN_WINDOW_MS = 180000;
const uint8_t RF_PROTOCOL_VERSION = 1;
const uint8_t RF_HEADER_LEN = 12;
const uint8_t RF_MAX_PACKET_LEN = 64;
const uint8_t RF_REPORT_PAYLOAD_LEN = 34;
const uint8_t RF_RESPONSE_PAYLOAD_LEN = 19;
const uint16_t RF_DEFAULT_NODE_ID = 0x0D01;
const uint16_t RF_BROADCAST_ID = 0x0000;
const uint8_t RF_FRAME_REPORT = 1;
const uint8_t RF_FRAME_RESPONSE = 2;
const uint8_t RF_DEVICE_TYPE_DOOR = 2;
const uint8_t RF_ADMIN_REQUEST_NONE = 0;
const uint8_t RF_ADMIN_REQUEST_PAIR = 1;
const uint8_t REPORT_DEVICE_TYPE = 0;
const uint8_t REPORT_BATTERY_MV = 1;
const uint8_t REPORT_STATUS_FLAGS = 3;
const uint8_t REPORT_ADMIN_REQUEST = 4;
const uint8_t REPORT_USER_DELTA_STEPS = 5;
const uint8_t REPORT_TEMP_COUNT = 6;
const uint8_t REPORT_TEMPERATURES = 7;
const uint8_t REPORT_PRESENCE_COUNT = 31;
const uint8_t REPORT_DOOR_TOGGLE_COUNT = 32;
const uint8_t REPORT_DOOR_OPEN = 33;
const uint8_t RESPONSE_ASSIGNED_ZONE = 0;
const uint8_t RESPONSE_ZONE_DOOR_OPEN = 9;
const uint8_t RESPONSE_COMMAND_FLAGS = 16;
const uint8_t RESPONSE_NEXT_REPORT_DELAY_S = 17;
const uint8_t RF_ASSOC_ZONE_COUNT = 5;
const int EEPROM_CONSOLE_MAGIC_0 = 0;
const int EEPROM_CONSOLE_MAGIC_1 = 1;
const int EEPROM_CONSOLE_ID_L = 2;
const int EEPROM_CONSOLE_ID_H = 3;
const int EEPROM_NODE_MAGIC_0 = 4;
const int EEPROM_NODE_MAGIC_1 = 5;
const int EEPROM_NODE_ID_L = 6;
const int EEPROM_NODE_ID_H = 7;
const uint8_t EEPROM_CONSOLE_MAGIC_VALUE_0 = 0x54;
const uint8_t EEPROM_CONSOLE_MAGIC_VALUE_1 = 0x43;
const uint8_t EEPROM_NODE_MAGIC_VALUE_0 = 0x54;
const uint8_t EEPROM_NODE_MAGIC_VALUE_1 = 0x4E;

const SPISettings RF_SPI_SETTINGS(1000000, MSBFIRST, SPI_MODE0);

unsigned long lastButtonBlinkAt = 0;
bool buttonBlinkOn = false;
uint32_t awakeWatchdogTicks = 0;
uint32_t lastRfBeaconAtWatchdogTick = 0;
uint32_t autoBeaconEnabledAtWatchdogTick = 0;
uint8_t rfSequence = 0;
bool rfResultActive = false;
bool rfResultAckReceived = false;
bool rfResultLedOn = false;
unsigned long rfResultUntil = 0;
unsigned long nextRfResultToggleAt = 0;
bool lastButtonPressed = false;
bool pendingPairRequest = false;
bool activePairRequest = false;
uint8_t pairZoneRequest = 0;
bool doorOpenState = false;
bool lastDoorOpenState = false;
uint8_t doorToggleCountSinceAck = 0;
uint8_t lastAssignedZone = 0;
bool lastZoneDoorOpen = false;
uint8_t lastCommandFlags = 0;
uint16_t lastNextReportDelayS = 0;
bool consoleIdKnown = false;
uint16_t learnedConsoleId = RF_BROADCAST_ID;
uint16_t rfNodeId = RF_DEFAULT_NODE_ID;
uint8_t consecutiveAckFailures = 0;
bool consoleOffline = false;
uint32_t consoleOfflineRetryAtWatchdogTick = 0;
volatile bool wakeByPinChange = false;
volatile uint16_t watchdogTicks = 0;

ISR(PCINT2_vect) {
  wakeByPinChange = true;
}

ISR(WDT_vect) {
  watchdogTicks++;
}

void ledOn() {
  digitalWrite(PIN_LED, HIGH);
}

void ledOff() {
  digitalWrite(PIN_LED, LOW);
}

void blinkLed(uint8_t count, unsigned int onMs, unsigned int offMs) {
  for (uint8_t i = 0; i < count; i++) {
    ledOn();
    delay(onMs);
    ledOff();
    delay(offMs);
  }
}

void updateWatchdogTime() {
  noInterrupts();
  const uint16_t ticks = watchdogTicks;
  watchdogTicks = 0;
  interrupts();
  awakeWatchdogTicks += ticks;
}

void setupWakeSources() {
  PCICR |= _BV(PCIE2);
  PCMSK2 |= _BV(PCINT18) | _BV(PCINT19);

  MCUSR &= ~_BV(WDRF);
  noInterrupts();
  WDTCSR = _BV(WDCE) | _BV(WDE);
  WDTCSR = _BV(WDIE) | _BV(WDP3) | _BV(WDP0); // interrupt every ~8 s
  interrupts();
}

void sleepAtmegaUntilEvent() {
  if (pendingPairRequest || rfResultActive || digitalRead(PIN_BUTTON) == HIGH) {
    return;
  }

  ADCSRA &= ~_BV(ADEN);
  set_sleep_mode(SLEEP_MODE_PWR_DOWN);
  noInterrupts();
  sleep_enable();
#if defined(BODS) && defined(BODSE)
  sleep_bod_disable();
#endif
  interrupts();
  sleep_cpu();
  sleep_disable();
  ADCSRA |= _BV(ADEN);
}

void clearLocalEeprom() {
  for (int address = 0; address < EEPROM.length(); address++) {
    EEPROM.update(address, 0xFF);
  }
  consoleIdKnown = false;
  learnedConsoleId = RF_BROADCAST_ID;
  rfNodeId = RF_DEFAULT_NODE_ID;
}

bool isValidNodeId(uint16_t nodeId) {
  return nodeId != RF_BROADCAST_ID && nodeId != learnedConsoleId && nodeId != 0xFFFF;
}

uint16_t generateNodeId() {
  uint32_t seed = micros() ^ ((uint32_t)millis() << 16);
  for (uint8_t i = 0; i < 24; i++) {
    seed ^= (uint32_t)analogRead(A0) << (i % 10);
    seed = (seed << 5) | (seed >> 27);
    delay(2);
  }

  uint16_t nodeId = (uint16_t)(seed & 0x7FFF);
  if (!isValidNodeId(nodeId)) {
    nodeId = RF_DEFAULT_NODE_ID;
  }
  return nodeId;
}

bool loadNodeIdFromEeprom() {
  const bool magicOk =
      EEPROM.read(EEPROM_NODE_MAGIC_0) == EEPROM_NODE_MAGIC_VALUE_0 &&
      EEPROM.read(EEPROM_NODE_MAGIC_1) == EEPROM_NODE_MAGIC_VALUE_1;
  if (!magicOk) {
    return false;
  }

  const uint16_t nodeId =
      (uint16_t)EEPROM.read(EEPROM_NODE_ID_L) |
      ((uint16_t)EEPROM.read(EEPROM_NODE_ID_H) << 8);
  if (!isValidNodeId(nodeId)) {
    return false;
  }

  rfNodeId = nodeId;
  return true;
}

void saveNodeIdToEeprom(uint16_t nodeId) {
  EEPROM.update(EEPROM_NODE_MAGIC_0, EEPROM_NODE_MAGIC_VALUE_0);
  EEPROM.update(EEPROM_NODE_MAGIC_1, EEPROM_NODE_MAGIC_VALUE_1);
  EEPROM.update(EEPROM_NODE_ID_L, nodeId & 0xFF);
  EEPROM.update(EEPROM_NODE_ID_H, nodeId >> 8);
  rfNodeId = nodeId;
}

void waitForNodeIdCreation() {
  while (digitalRead(PIN_BUTTON) == HIGH) {
    blinkLed(1, 80, 220);
  }

  while (digitalRead(PIN_BUTTON) != HIGH) {
    blinkLed(1, 40, 460);
  }

  saveNodeIdToEeprom(generateNodeId());
  blinkLed(3, 120, 120);
  while (digitalRead(PIN_BUTTON) == HIGH) {
    delay(10);
  }
}

void loadConsoleIdFromEeprom() {
  const bool magicOk =
      EEPROM.read(EEPROM_CONSOLE_MAGIC_0) == EEPROM_CONSOLE_MAGIC_VALUE_0 &&
      EEPROM.read(EEPROM_CONSOLE_MAGIC_1) == EEPROM_CONSOLE_MAGIC_VALUE_1;
  if (!magicOk) {
    consoleIdKnown = false;
    learnedConsoleId = RF_BROADCAST_ID;
    return;
  }

  learnedConsoleId =
      (uint16_t)EEPROM.read(EEPROM_CONSOLE_ID_L) |
      ((uint16_t)EEPROM.read(EEPROM_CONSOLE_ID_H) << 8);
  consoleIdKnown = learnedConsoleId != RF_BROADCAST_ID && learnedConsoleId != rfNodeId;
}

void saveConsoleIdToEeprom(uint16_t consoleId) {
  EEPROM.update(EEPROM_CONSOLE_MAGIC_0, EEPROM_CONSOLE_MAGIC_VALUE_0);
  EEPROM.update(EEPROM_CONSOLE_MAGIC_1, EEPROM_CONSOLE_MAGIC_VALUE_1);
  EEPROM.update(EEPROM_CONSOLE_ID_L, consoleId & 0xFF);
  EEPROM.update(EEPROM_CONSOLE_ID_H, consoleId >> 8);
  learnedConsoleId = consoleId;
  consoleIdKnown = true;
}

bool canLearnConsoleId() {
  return !consoleIdKnown && (uint32_t)millis() < RF_CONSOLE_LEARN_WINDOW_MS;
}

bool readDoorOpenState() {
  return digitalRead(PIN_DOOR_OPEN) != LOW;
}

void updateDoorState() {
  doorOpenState = readDoorOpenState();
  if (doorOpenState != lastDoorOpenState) {
    lastDoorOpenState = doorOpenState;
    if (doorToggleCountSinceAck < 255) {
      doorToggleCountSinceAck++;
    }
  }
}

uint16_t readBatteryMv() {
  return 3000;
}

uint8_t readAdminRequest() {
  return activePairRequest ? RF_ADMIN_REQUEST_PAIR : RF_ADMIN_REQUEST_NONE;
}

uint8_t nextPairZone(uint8_t currentZone) {
  if (currentZone < 1 || currentZone >= RF_ASSOC_ZONE_COUNT) {
    return 1;
  }
  return currentZone + 1;
}

void startRfResultIndicator(bool ackReceived) {
  rfResultActive = true;
  rfResultAckReceived = ackReceived;
  rfResultLedOn = ackReceived;
  rfResultUntil = millis() + RF_RESULT_LED_MS;
  nextRfResultToggleAt = millis();
  digitalWrite(PIN_LED, ackReceived ? HIGH : LOW);
}

bool updateRfResultIndicator() {
  if (!rfResultActive) {
    return false;
  }

  if ((int32_t)(millis() - rfResultUntil) >= 0) {
    rfResultActive = false;
    ledOff();
    return false;
  }

  if (rfResultAckReceived) {
    ledOn();
    return true;
  }

  if (!rfResultLedOn && (int32_t)(millis() - nextRfResultToggleAt) >= 0) {
    rfResultLedOn = true;
    ledOn();
    nextRfResultToggleAt = millis() + RF_RESULT_FAIL_ON_MS;
  } else if (rfResultLedOn && (int32_t)(millis() - nextRfResultToggleAt) >= 0) {
    rfResultLedOn = false;
    ledOff();
  }
  return true;
}

void rfPowerOn() {
  digitalWrite(PIN_RF_CSN, LOW);
  delayMicroseconds(10);
  digitalWrite(PIN_RF_CSN, HIGH);
  delay(RF_POWER_UP_MS);
}

void rfPowerOff() {
  SPI.beginTransaction(RF_SPI_SETTINGS);
  cc1101TransferStrobe(CC1101_SIDLE);
  cc1101TransferStrobe(CC1101_SPWD);
  SPI.endTransaction();
  digitalWrite(PIN_RF_CSN, HIGH);
  digitalWrite(PIN_RF_MOSI, LOW);
  digitalWrite(PIN_RF_SCK, LOW);
}

bool waitCc1101Ready(unsigned int timeoutMs) {
  const unsigned long startedAt = millis();
  while (digitalRead(PIN_RF_MISO) == HIGH) {
    if ((uint32_t)(millis() - startedAt) >= timeoutMs) {
      return false;
    }
  }

  return true;
}

bool cc1101ReadStatusRegister(uint8_t address, uint8_t &value) {
  digitalWrite(PIN_RF_CSN, LOW);
  if (!waitCc1101Ready(CC1101_READY_TIMEOUT_MS)) {
    digitalWrite(PIN_RF_CSN, HIGH);
    return false;
  }

  SPI.transfer(CC1101_READ_BURST | address);
  value = SPI.transfer(0x00);
  digitalWrite(PIN_RF_CSN, HIGH);
  return true;
}

uint8_t cc1101TransferStrobe(uint8_t strobe) {
  digitalWrite(PIN_RF_CSN, LOW);
  waitCc1101Ready(CC1101_READY_TIMEOUT_MS);
  const uint8_t status = SPI.transfer(strobe);
  digitalWrite(PIN_RF_CSN, HIGH);
  return status;
}

void cc1101ResetRadio() {
  digitalWrite(PIN_RF_CSN, HIGH);
  delayMicroseconds(5);
  digitalWrite(PIN_RF_CSN, LOW);
  waitCc1101Ready(CC1101_READY_TIMEOUT_MS);
  SPI.transfer(CC1101_SRES);
  digitalWrite(PIN_RF_CSN, HIGH);
  delay(2);
}

void cc1101WriteRegister(uint8_t address, uint8_t value) {
  digitalWrite(PIN_RF_CSN, LOW);
  waitCc1101Ready(CC1101_READY_TIMEOUT_MS);
  SPI.transfer(address);
  SPI.transfer(value);
  digitalWrite(PIN_RF_CSN, HIGH);
}

uint8_t cc1101ReadRegisterValue(uint8_t address) {
  uint8_t value = 0xFF;
  cc1101ReadStatusRegister(address, value);
  return value;
}

void cc1101FlushRx() {
  cc1101TransferStrobe(CC1101_SIDLE);
  cc1101TransferStrobe(CC1101_SFRX);
}

void cc1101ConfigureTestRadio() {
  cc1101ResetRadio();
  cc1101TransferStrobe(CC1101_SIDLE);
  cc1101TransferStrobe(CC1101_SFRX);
  cc1101TransferStrobe(CC1101_SFTX);

  cc1101WriteRegister(0x02, 0x06); // IOCFG0: sync word received/sent on GDO0
  cc1101WriteRegister(0x07, RF_MAX_PACKET_LEN); // PKTLEN
  cc1101WriteRegister(0x08, 0x05); // PKTCTRL0: variable length + CRC
  cc1101WriteRegister(0x0B, 0x06); // FSCTRL1
  cc1101WriteRegister(0x0D, 0x10); // FREQ2 433.92 MHz
  cc1101WriteRegister(0x0E, 0xB0); // FREQ1
  cc1101WriteRegister(0x0F, 0x71); // FREQ0
  cc1101WriteRegister(0x10, 0xF5); // MDMCFG4
  cc1101WriteRegister(0x11, 0x83); // MDMCFG3
  cc1101WriteRegister(0x12, 0x13); // MDMCFG2: 2-FSK, sync 30/32
  cc1101WriteRegister(0x15, 0x15); // DEVIATN
  cc1101WriteRegister(0x18, 0x18); // MCSM0
  cc1101WriteRegister(0x19, 0x16); // FOCCFG
  cc1101WriteRegister(0x23, 0xE9); // FSCAL3
  cc1101WriteRegister(0x24, 0x2A); // FSCAL2
  cc1101WriteRegister(0x25, 0x00); // FSCAL1
  cc1101WriteRegister(0x26, 0x1F); // FSCAL0

  digitalWrite(PIN_RF_CSN, LOW);
  waitCc1101Ready(CC1101_READY_TIMEOUT_MS);
  SPI.transfer(CC1101_WRITE_BURST | 0x3E); // PATABLE
  SPI.transfer(0xC0);
  digitalWrite(PIN_RF_CSN, HIGH);
}

void writeU16(uint8_t *buffer, uint8_t offset, uint16_t value) {
  buffer[offset] = value & 0xFF;
  buffer[offset + 1] = value >> 8;
}

uint16_t readU16(const uint8_t *buffer, uint8_t offset) {
  return (uint16_t)buffer[offset] | ((uint16_t)buffer[offset + 1] << 8);
}

uint8_t expectedPayloadLen(uint8_t frameType) {
  return frameType == RF_FRAME_RESPONSE ? RF_RESPONSE_PAYLOAD_LEN : RF_REPORT_PAYLOAD_LEN;
}

uint8_t buildRfPacket(uint8_t *packet, uint8_t frameType, uint8_t sequence, uint8_t ackSequence) {
  const uint8_t payloadLen = frameType == RF_FRAME_REPORT ? RF_REPORT_PAYLOAD_LEN : 0;

  packet[0] = 'T';
  packet[1] = 'N';
  packet[2] = 'U';
  packet[3] = RF_PROTOCOL_VERSION;
  packet[4] = frameType;
  writeU16(packet, 5, rfNodeId);
  writeU16(packet, 7, consoleIdKnown ? learnedConsoleId : RF_BROADCAST_ID);
  packet[9] = sequence;
  packet[10] = ackSequence;
  packet[11] = payloadLen;

  if (frameType == RF_FRAME_REPORT) {
    updateDoorState();
    uint8_t *payload = packet + RF_HEADER_LEN;
    const uint16_t batteryMv = readBatteryMv();
    payload[REPORT_DEVICE_TYPE] = RF_DEVICE_TYPE_DOOR;
    payload[REPORT_BATTERY_MV] = batteryMv & 0xFF;
    payload[REPORT_BATTERY_MV + 1] = batteryMv >> 8;
    payload[REPORT_STATUS_FLAGS] = activePairRequest ? pairZoneRequest : 0;
    payload[REPORT_ADMIN_REQUEST] = readAdminRequest();
    payload[REPORT_USER_DELTA_STEPS] = 0;
    payload[REPORT_TEMP_COUNT] = 12; // payload factice proche d'une sonde
    for (uint8_t i = 0; i < 12; i++) {
      const int16_t tempDeciC = 190 + i;
      payload[REPORT_TEMPERATURES + i * 2] = tempDeciC & 0xFF;
      payload[REPORT_TEMPERATURES + i * 2 + 1] = tempDeciC >> 8;
    }
    payload[REPORT_PRESENCE_COUNT] = 0;
    payload[REPORT_DOOR_TOGGLE_COUNT] = doorToggleCountSinceAck;
    payload[REPORT_DOOR_OPEN] = doorOpenState ? 1 : 0;
  }

  return RF_HEADER_LEN + payloadLen;
}

void waitRfTxComplete() {
  const unsigned long startedAt = millis();
  while (digitalRead(PIN_RF_GDO0) == LOW) {
    if ((uint32_t)(millis() - startedAt) >= RF_TX_COMPLETE_DELAY_MS) {
      return;
    }
  }

  while (digitalRead(PIN_RF_GDO0) == HIGH) {
    if ((uint32_t)(millis() - startedAt) >= RF_TX_COMPLETE_DELAY_MS) {
      return;
    }
  }
}

bool decodeResponsePayload(const uint8_t *packet) {
  const uint8_t *payload = packet + RF_HEADER_LEN;
  const uint8_t assignedZone = payload[RESPONSE_ASSIGNED_ZONE];
  const uint16_t nextReportDelayS = readU16(payload, RESPONSE_NEXT_REPORT_DELAY_S);

  if (assignedZone > RF_ASSOC_ZONE_COUNT || nextReportDelayS == 0) {
    return false;
  }

  lastAssignedZone = assignedZone;
  if (assignedZone >= 1 && assignedZone <= RF_ASSOC_ZONE_COUNT) {
    pairZoneRequest = assignedZone;
  }
  lastZoneDoorOpen = payload[RESPONSE_ZONE_DOOR_OPEN] != 0;
  lastCommandFlags = payload[RESPONSE_COMMAND_FLAGS];
  lastNextReportDelayS = nextReportDelayS;
  return true;
}

bool readThermonuinoPacket(uint16_t expectedSource, uint8_t expectedFrameType, uint8_t expectedAckSequence, uint8_t &sequence) {
  const uint8_t rxBytesRaw = cc1101ReadRegisterValue(CC1101_RXBYTES);
  if ((rxBytesRaw & 0x80) != 0) {
    cc1101FlushRx();
    cc1101TransferStrobe(CC1101_SRX);
    return false;
  }

  const uint8_t rxBytes = rxBytesRaw & 0x7F;
  const uint8_t expectedLength = RF_HEADER_LEN + expectedPayloadLen(expectedFrameType);
  if (rxBytes < expectedLength + 1) {
    return false;
  }

  uint8_t payload[RF_MAX_PACKET_LEN] = {0};
  uint8_t length = 0;
  digitalWrite(PIN_RF_CSN, LOW);
  waitCc1101Ready(CC1101_READY_TIMEOUT_MS);
  SPI.transfer(CC1101_READ_BURST | CC1101_RXFIFO);
  length = SPI.transfer(0x00);
  if (length > rxBytes - 1) {
    length = rxBytes - 1;
  }
  if (length > sizeof(payload)) {
    length = sizeof(payload);
  }
  for (uint8_t i = 0; i < length; i++) {
    payload[i] = SPI.transfer(0x00);
  }
  digitalWrite(PIN_RF_CSN, HIGH);
  cc1101FlushRx();
  cc1101TransferStrobe(CC1101_SRX);

  const uint16_t packetSourceId = readU16(payload, 5);
  const bool sourceOk = expectedSource == RF_BROADCAST_ID ?
      (packetSourceId != rfNodeId && canLearnConsoleId()) :
      packetSourceId == expectedSource;
  const bool ok = length >= RF_HEADER_LEN &&
      payload[0] == 'T' &&
      payload[1] == 'N' &&
      payload[2] == 'U' &&
      payload[3] == RF_PROTOCOL_VERSION &&
      payload[4] == expectedFrameType &&
      sourceOk &&
      readU16(payload, 7) == rfNodeId &&
      length == expectedLength &&
      payload[11] == length - RF_HEADER_LEN &&
      (expectedAckSequence == 0xFF || payload[10] == expectedAckSequence);
  if (ok && (expectedFrameType != RF_FRAME_RESPONSE || decodeResponsePayload(payload))) {
    if (expectedFrameType == RF_FRAME_RESPONSE && !consoleIdKnown) {
      saveConsoleIdToEeprom(packetSourceId);
    }
    sequence = payload[9];
    return true;
  }
  return false;
}

void sendThermonuinoPacket(uint8_t frameType, uint8_t sequence) {
  uint8_t payload[RF_MAX_PACKET_LEN] = {0};
  const uint8_t length = buildRfPacket(payload, frameType, sequence, 0xFF);
  cc1101TransferStrobe(CC1101_SIDLE);
  cc1101TransferStrobe(CC1101_SFTX);

  digitalWrite(PIN_RF_CSN, LOW);
  waitCc1101Ready(CC1101_READY_TIMEOUT_MS);
  SPI.transfer(CC1101_WRITE_BURST | CC1101_TXFIFO);
  SPI.transfer(length);
  for (uint8_t i = 0; i < length; i++) {
    SPI.transfer(payload[i]);
  }
  digitalWrite(PIN_RF_CSN, HIGH);
  cc1101TransferStrobe(CC1101_STX);
  waitRfTxComplete();
}

bool rfChannelBusy() {
  cc1101FlushRx();
  cc1101TransferStrobe(CC1101_SRX);
  delay(RF_CHANNEL_LISTEN_MS);
  const uint8_t pktStatus = cc1101ReadRegisterValue(CC1101_PKTSTATUS);
  const uint8_t rxBytes = cc1101ReadRegisterValue(CC1101_RXBYTES) & 0x7F;
  cc1101FlushRx();
  return (pktStatus & 0x10) == 0 || rxBytes >= 7; // CCA=0 means channel not clear.
}

bool captureButtonRequest() {
  const bool buttonPressed = digitalRead(PIN_BUTTON) == HIGH;
  const bool pressedNow = buttonPressed && !lastButtonPressed;
  if (pressedNow) {
    pairZoneRequest = nextPairZone(pairZoneRequest);
    pendingPairRequest = true;
    consoleOffline = false;
    consecutiveAckFailures = 0;
    blinkLed(1, BUTTON_ACCEPTED_ON_MS, 0);
  }
  lastButtonPressed = buttonPressed;
  return pressedNow;
}

void runRfBeaconExchange() {
  activePairRequest = pendingPairRequest;
  pendingPairRequest = false;
  if (activePairRequest) {
    blinkLed(3, PAIR_TX_BLINK_ON_MS, PAIR_TX_BLINK_OFF_MS);
  }

  rfPowerOn();
  SPI.beginTransaction(RF_SPI_SETTINGS);
  cc1101ConfigureTestRadio();

  bool received = false;
  const uint8_t beaconSequence = rfSequence;
  rfSequence++;
  for (uint8_t attempt = 0; attempt < RF_MAX_ATTEMPTS && !received; attempt++) {
    if (rfChannelBusy()) {
      delay(random(RF_BACKOFF_MIN_MS, RF_BACKOFF_MIN_MS + RF_BACKOFF_SPAN_MS + 1) + attempt * RF_BACKOFF_STEP_MS);
    }

    for (uint8_t copy = 0; copy < RF_TX_COPIES_PER_ATTEMPT; copy++) {
      sendThermonuinoPacket(RF_FRAME_REPORT, beaconSequence);
      if (copy + 1 < RF_TX_COPIES_PER_ATTEMPT) {
        delay(RF_TX_COPY_GAP_MS);
      }
    }
    cc1101TransferStrobe(CC1101_SRX);
    delay(RF_RX_SETTLE_MS);

    const unsigned long rxStartedAt = millis();
    while ((uint32_t)(millis() - rxStartedAt) < RF_ACK_TIMEOUT_MS) {
      uint8_t ackSequence = 0;
      if (readThermonuinoPacket(consoleIdKnown ? learnedConsoleId : RF_BROADCAST_ID, RF_FRAME_RESPONSE, beaconSequence, ackSequence)) {
        received = true;
        break;
      }
      delay(10);
    }

    if (!received) {
      delay(random(RF_BACKOFF_MIN_MS, RF_BACKOFF_MIN_MS + RF_BACKOFF_SPAN_MS + 1) + attempt * RF_BACKOFF_STEP_MS);
    }
  }

  cc1101TransferStrobe(CC1101_SIDLE);
  SPI.endTransaction();
  rfPowerOff();
  if (received) {
    doorToggleCountSinceAck = 0;
    consecutiveAckFailures = 0;
    consoleOffline = false;
  } else if (consecutiveAckFailures < RF_CONSOLE_OFFLINE_ACK_FAILURES) {
    consecutiveAckFailures++;
    if (consecutiveAckFailures >= RF_CONSOLE_OFFLINE_ACK_FAILURES) {
      consoleOffline = true;
      consoleOfflineRetryAtWatchdogTick =
          awakeWatchdogTicks + RF_CONSOLE_OFFLINE_RETRY_WATCHDOG_TICKS;
    }
  }
  activePairRequest = false;
  startRfResultIndicator(received);
}

bool testCc1101Spi() {
  const unsigned long startedAt = millis();
  bool ok = false;

  rfPowerOn();
  SPI.beginTransaction(RF_SPI_SETTINGS);

  uint8_t partnum = 0xFF;
  uint8_t version1 = 0xFF;
  uint8_t version2 = 0xFF;
  const bool readOk =
      cc1101ReadStatusRegister(CC1101_PARTNUM, partnum) &&
      cc1101ReadStatusRegister(CC1101_VERSION, version1) &&
      cc1101ReadStatusRegister(CC1101_VERSION, version2);

  if ((uint32_t)(millis() - startedAt) < CC1101_TOTAL_TIMEOUT_MS) {
    const bool busIsNotFloating = version1 != 0x00 && version1 != 0xFF;
    const bool responseIsStable = version1 == version2;
    const bool partnumLooksValid = partnum == 0x00;
    ok = readOk && busIsNotFloating && responseIsStable && partnumLooksValid;
  }

  SPI.endTransaction();
  rfPowerOff();
  return ok;
}

void updateButtonRequest() {
  captureButtonRequest();
}

void updateInputLed() {
  if (updateRfResultIndicator()) {
    return;
  }

  const bool reedClosed = digitalRead(PIN_DOOR_OPEN) == LOW;
  const bool buttonPressed = digitalRead(PIN_BUTTON) == HIGH;

  if (buttonPressed) {
    if ((uint32_t)(millis() - lastButtonBlinkAt) >= BUTTON_BLINK_MS) {
      lastButtonBlinkAt = millis();
      buttonBlinkOn = !buttonBlinkOn;
      digitalWrite(PIN_LED, buttonBlinkOn ? HIGH : LOW);
    }
    return;
  }

  buttonBlinkOn = false;
  if (reedClosed) {
    ledOn();
  } else {
    ledOff();
  }
}

void setup() {
  pinMode(PIN_LED, OUTPUT);
  ledOff();

  pinMode(PIN_DOOR_OPEN, INPUT_PULLUP);
  pinMode(PIN_BUTTON, INPUT);
  if (digitalRead(PIN_BUTTON) == HIGH) {
    clearLocalEeprom();
  }
  if (!loadNodeIdFromEeprom()) {
    waitForNodeIdCreation();
  }
  loadConsoleIdFromEeprom();
  doorOpenState = readDoorOpenState();
  lastDoorOpenState = doorOpenState;

  pinMode(PIN_RF_EN, INPUT);
  pinMode(PIN_RF_GDO0, INPUT);
  pinMode(PIN_RF_CSN, OUTPUT);
  pinMode(PIN_RF_MOSI, OUTPUT);
  pinMode(PIN_RF_MISO, INPUT);
  pinMode(PIN_RF_SCK, OUTPUT);
  
  digitalWrite(PIN_RF_CSN, HIGH);
  digitalWrite(PIN_RF_MOSI, LOW);
  digitalWrite(PIN_RF_SCK, LOW);
  SPI.begin();
  rfPowerOff();

  blinkLed(1, 80, 150);
  delay(1000);
  const bool rfOk = testCc1101Spi();
  blinkLed(rfOk ? 5 : 2, rfOk ? 100 : 350, rfOk ? 120 : 350);
  randomSeed(analogRead(A0) ^ micros());
  setupWakeSources();
  lastRfBeaconAtWatchdogTick = awakeWatchdogTicks;
  autoBeaconEnabledAtWatchdogTick =
      awakeWatchdogTicks + RF_STARTUP_AUTO_BEACON_DELAY_WATCHDOG_TICKS;
  
}

void loop() {
  updateWatchdogTime();
  updateDoorState();
  updateButtonRequest();
  const bool offlineRetryDue =
      consoleOffline &&
      (int32_t)(awakeWatchdogTicks - consoleOfflineRetryAtWatchdogTick) >= 0;
  const bool autoBeaconDue =
      (!consoleOffline || offlineRetryDue) &&
      (int32_t)(awakeWatchdogTicks - autoBeaconEnabledAtWatchdogTick) >= 0 &&
      (uint32_t)(awakeWatchdogTicks - lastRfBeaconAtWatchdogTick) >= RF_BEACON_INTERVAL_WATCHDOG_TICKS;
  if (pendingPairRequest || autoBeaconDue) {
    if (offlineRetryDue) {
      consoleOfflineRetryAtWatchdogTick =
          awakeWatchdogTicks + RF_CONSOLE_OFFLINE_RETRY_WATCHDOG_TICKS;
    }
    runRfBeaconExchange();
    lastRfBeaconAtWatchdogTick = awakeWatchdogTicks;
  }
  updateInputLed();
  sleepAtmegaUntilEvent();
  delay(5);
}
