jsdenim/thermonuino/tests/Thermonuino 2/Stations/MyThermonuino433Device/MyThermonuino433Device.ino

#include <Manchester.h>

#define DATA_ARRAY_SIZE 3
uint8_t data[DATA_ARRAY_SIZE] = {9, 9, 9};

#define TEMP_IDX_START 0
#define TEMP_IDX_END 3




// SETTINGS
#define INTVAL 5  // frequency of sending the data in seconds.
#define CHAN 1  // set channel bit (0=CH1,1=CH2,2=CH3, )
#define REP 3  // signal repeats (default=7x)
//#define ID 1318  // device id (1280-1535) [when disabled, random id on start]

// sleep function libraries
#include <avr/sleep.h>
#include <avr/interrupt.h>
#include <avr/power.h>
#include <avr/wdt.h>


// initialize DHT sensor library
#include <dht.h>
dht DHT;

#define TX_PIN  PB3
#define PIR_PIN  PB1
#define DHT_PIN  PB2
#define LED_PIN PB0

// variables of sleep code
volatile bool watchdogActive = false;
byte sleepCycles = 0;

// buffer to store message ready-to-send by bits
byte message[36];

long scale_constant = 112640L; // default scale_constant (1.1*1024*100)

// define watchdog timer interrupt action
ISR(WDT_vect) {
  watchdogActive = true;  // set flag
}

volatile bool excited = false;

void excitationFnc (){
  excited = true;
   //sleep();  // go to sleep!
}

void setup() {
  //OSCCAL = 0x4E;  // internal oscillator calibration value (important! see manual...)

  //man.workAround1MhzTinyCore(); //add this in order for transmitter to work with 1Mhz Attiny85/84
  man.setupTransmit(TX_PIN, MAN_1200);
  
  pinMode(LED_PIN, OUTPUT);  // STATUS LED
  pinMode(TX_PIN, OUTPUT);  // RF TRANSMITTER
  //pinMode(DHT_PIN, INPUT);  // DHT SENSOR

  //pinMode(PIR_PIN, INPUT);  // PIR

  //attachInterrupt(1, excitationFnc, RISING);
  
  data[0] = 0;
  data[1] = 1;
  data[2] = 2;

  ledBlink(10);
  
}

void loop() {


  for (int i = 5; i > 0; i--) {

    man.transmitArray(DATA_ARRAY_SIZE, data);
    ledBlink(1);
    delay(800);
 
  }

  delay(15000);

  
}


// A very simple led blinking function for feedback
void ledBlink(byte n) {
  for (n; n>0; n--) {
    digitalWrite(LED_PIN, HIGH);
    delay(150);
    digitalWrite(LED_PIN, LOW);
    delay(150);
  }
}

void resetData(){
  for(int i = 0; i < DATA_ARRAY_SIZE; i++){
    data[i] = 0;
  }
}
