jsdenim/thermonuino/main/modules/sonde/SondeUi.cpp

#include "SondeUi.h"

#include "graphics/ThermioEink097.h"
#include "graphics/ThermioFont5x7.h"

UiState ui = {};

namespace {

const UiMenuSubPage BatterySubPages[] = {
  UI_SUB_BATTERY_VOLTAGE,
  UI_SUB_BATTERY_THRESHOLDS,
  UI_SUB_BATTERY_STATE
};

const UiMenuSubPage ConsoleSubPages[] = {
  UI_SUB_CONSOLE_RF_DEBUG,
  UI_SUB_CONSOLE_IDS,
  UI_SUB_CONSOLE_LAST_RESPONSE
};

const UiMenuSubPage ThermometerSubPages[] = {
  UI_SUB_THERMO_RAW,
  UI_SUB_THERMO_OFFSET,
  UI_SUB_THERMO_CORRECTED,
  UI_SUB_THERMO_VACATION
};

const UiMenuSubPage LearningSubPages[] = {
  UI_SUB_CONSOLE_PAIRING,
  UI_SUB_LEARNING_SETPOINT,
  UI_SUB_LEARNING_ACTIVE,
  UI_SUB_LEARNING_CONSOLE_COMM,
  UI_SUB_LEARNING_RESET_ZONE,
  UI_SUB_LEARNING_RESET_GLOBAL,
  UI_SUB_LEARNING_LOAD_TYPICAL
};

bool rectPixel(int16_t x0,
               int16_t y0,
               int16_t w,
               int16_t h,
               uint16_t x,
               uint16_t y);
bool segmentedTempPixel(int16_t tempDeciC,
                        bool known,
                        int16_t x0,
                        int16_t y0,
                        uint16_t x,
                        uint16_t y,
                        bool roundHalfDegree = true);

uint8_t appendUint16(char *buffer, uint8_t pos, uint16_t value) {
  char digits[10];
  uint8_t count = 0;
  do {
    digits[count++] = '0' + (value % 10);
    value /= 10;
  } while (value > 0 && count < sizeof(digits));

  while (count > 0) {
    buffer[pos++] = digits[--count];
  }
  buffer[pos] = '\0';
  return pos;
}

uint8_t appendSignedDeciText(char *buffer, int16_t deciC) {
  uint8_t pos = 0;
  if (deciC < 0) {
    buffer[pos++] = '-';
    deciC = -deciC;
  } else if (deciC > 0) {
    buffer[pos++] = '+';
  }
  pos = appendUint16(buffer, pos, (uint16_t)(deciC / 10));
  buffer[pos++] = '.';
  buffer[pos++] = '0' + (deciC % 10);
  buffer[pos] = '\0';
  return pos;
}

int16_t roundToHalfDegree(int16_t tempDeciC) {
  if (tempDeciC >= 0) {
    return ((tempDeciC + 2) / 5) * 5;
  }
  return ((tempDeciC - 2) / 5) * 5;
}

bool textLinePixel(const char *text,
                   uint8_t x0,
                   uint8_t y0,
                   uint16_t x,
                   uint16_t y,
                   uint8_t scale = 2) {
  return ThermioFont5x7::textPixel(text, x0, y0, x, y, scale);
}

bool textLinePixelP(PGM_P text,
                    uint8_t x0,
                    uint8_t y0,
                    uint16_t x,
                    uint16_t y,
                    uint8_t scale = 2) {
  return ThermioFont5x7::textPixel_P(text, x0, y0, x, y, scale);
}

bool plusMarkerPixel(uint16_t x, uint16_t y) {
  return rectPixel(168, 12, 13, 3, x, y) ||
      rectPixel(173, 7, 3, 13, x, y);
}

uint8_t batteryPercent(uint16_t batteryMv) {
  const uint16_t noBatteryMv = 50;
  const uint16_t criticalMv = 1700;
  const uint16_t fullMv = 3000;
  if (batteryMv <= noBatteryMv || batteryMv <= criticalMv) {
    return 0;
  }
  if (batteryMv >= fullMv) {
    return 100;
  }
  return (uint8_t)(((uint32_t)(batteryMv - criticalMv) * 100UL) / (fullMv - criticalMv));
}

bool numericValueLinePixel(uint16_t value,
                           const char *suffix,
                           uint8_t x0,
                           uint8_t y0,
                           uint16_t x,
                           uint16_t y,
                           uint8_t scale = 2) {
  char text[16];
  uint8_t pos = appendUint16(text, 0, value);
  if (suffix != nullptr) {
    while (*suffix != '\0' && pos < sizeof(text) - 1) {
      text[pos++] = *suffix++;
    }
    text[pos] = '\0';
  }
  return textLinePixel(text, x0, y0, x, y, scale);
}

bool humidityLinePixel(bool known,
                       uint16_t humidityDeciPct,
                       uint16_t x,
                       uint16_t y) {
  char text[10];
  text[0] = 'H';
  text[1] = ' ';
  if (!known) {
    text[2] = 'N';
    text[3] = 'A';
    text[4] = '\0';
  } else {
    uint8_t pos = appendUint16(text, 2, (humidityDeciPct + 5) / 10);
    text[pos++] = 'P';
    text[pos++] = 'C';
    text[pos++] = 'T';
    text[pos] = '\0';
  }
  return textLinePixel(text, 70, 78, x, y, 1);
}

bool signedDeciLinePixel(int16_t value,
                         uint8_t x0,
                         uint8_t y0,
                         uint16_t x,
                         uint16_t y,
                         uint8_t scale = 2) {
  char text[18];
  appendSignedDeciText(text, value);
  return textLinePixel(text, x0, y0, x, y, scale);
}

bool centeredStatusPixel(PGM_P title,
                         PGM_P value,
                         bool hasSubmenu,
                         uint16_t x,
                         uint16_t y) {
  if (textLinePixelP(title, 6, 7, x, y, 2)) {
    return true;
  }
  if (hasSubmenu && plusMarkerPixel(x, y)) {
    return true;
  }
  return textLinePixelP(value, 22, 43, x, y, 3);
}

PGM_P zoneName(uint8_t zone) {
  switch (zone) {
    case 1:
      return PSTR("SALON");
    case 2:
      return PSTR("CHAMBRE");
    case 3:
      return PSTR("BUREAU");
    case 4:
      return PSTR("SDB");
    default:
      return PSTR("INCONNUE");
  }
}

bool menuMainPixel(const UiState *state, uint16_t x, uint16_t y) {
  switch (state->menuPage) {
    case UI_MENU_PRESENCE:
      return centeredStatusPixel(PSTR("PRESENCE"), state->motionDetected ? PSTR("OUI") : PSTR("NON"), false, x, y);
    case UI_MENU_BATTERY:
      if (centeredStatusPixel(PSTR("BATTERIE"), PSTR(""), true, x, y)) {
        return true;
      }
      if (state->batteryMv <= 50) {
        return textLinePixelP(PSTR("TEST"), 58, 43, x, y, 3);
      }
      return numericValueLinePixel(batteryPercent(state->batteryMv), " PCT", 36, 43, x, y, 3);
    case UI_MENU_CONSOLE:
      return centeredStatusPixel(PSTR("CONSOLE"), state->consoleOk ? PSTR("OK") : PSTR("KO"), true, x, y);
    case UI_MENU_THERMOMETER:
      if (textLinePixelP(PSTR("AHT30"), 6, 7, x, y, 2) || plusMarkerPixel(x, y)) {
        return true;
      }
      return segmentedTempPixel(state->rawTempDeciC,
                                state->currentTempKnown,
                                47,
                                30,
                                x,
                                y,
                                false) ||
          humidityLinePixel(state->humidityKnown, state->humidityDeciPct, x, y);
    case UI_MENU_LEARNING:
    default:
      return centeredStatusPixel(PSTR("APPRENT"), PSTR("ZONE"), true, x, y);
  }
}

bool menuSubPixel(const UiState *state, uint16_t x, uint16_t y) {
  switch (state->menuSubPage) {
    case UI_SUB_BATTERY_VOLTAGE:
      return textLinePixelP(PSTR("TENSION"), 6, 7, x, y, 2) ||
          numericValueLinePixel(state->batteryMv, " MV", 32, 43, x, y, 3);
    case UI_SUB_BATTERY_THRESHOLDS:
      return textLinePixelP(PSTR("SEUILS"), 6, 7, x, y, 2) ||
          textLinePixelP(PSTR("LOW 2000"), 20, 35, x, y, 2) ||
          textLinePixelP(PSTR("STOP 1700"), 20, 57, x, y, 2);
    case UI_SUB_BATTERY_STATE:
      return centeredStatusPixel(PSTR("ETAT PILE"),
                                 state->batteryCritical ? PSTR("STOP") : state->batteryLow ? PSTR("FAIBLE") : PSTR("OK"),
                                 false,
                                 x,
                                 y);
    case UI_SUB_CONSOLE_PAIRING:
      if (textLinePixelP(state->pairingSending ? PSTR("PIECE ENVOI") :
                         state->pairingOk ? PSTR("PIECE OK") :
                         state->pairingActive ? PSTR("PIECE EDIT") :
                         PSTR("PIECE ?"), 6, 7, x, y, 2)) {
        return true;
      }
      if (!state->pairingSending && !state->pairingOk && plusMarkerPixel(x, y)) {
        return true;
      }
      return textLinePixelP(zoneName(state->pairingZoneRequest), 22, 43, x, y, 3);
    case UI_SUB_CONSOLE_RF_DEBUG:
      return textLinePixelP(PSTR("DEBUG RF"), 6, 7, x, y, 2) ||
          textLinePixelP(state->rfSpiOk ? PSTR("SPI OK") : PSTR("SPI KO"), 20, 35, x, y, 2) ||
          textLinePixelP(state->consoleOk ? PSTR("ACK OK") : PSTR("ACK KO"), 20, 57, x, y, 2);
    case UI_SUB_CONSOLE_IDS:
      return textLinePixelP(PSTR("IDS RF"), 6, 7, x, y, 2) ||
          numericValueLinePixel(state->localRfId, " LOCAL", 12, 35, x, y, 2) ||
          numericValueLinePixel(state->consoleRfId, " CONS", 12, 57, x, y, 2);
    case UI_SUB_CONSOLE_LAST_RESPONSE:
      return textLinePixelP(PSTR("REPONSE"), 6, 7, x, y, 2) ||
          textLinePixelP(state->heatLastHour ? PSTR("CHAUF 1H") : PSTR("CHAUF 24H"), 16, 35, x, y, 2) ||
          textLinePixelP(state->zoneDoorOpen ? PSTR("PORTE OUV") : PSTR("PORTE OK"), 16, 57, x, y, 2);
    case UI_SUB_THERMO_RAW:
      if (textLinePixelP(PSTR("BRUT"), 6, 7, x, y, 2)) {
        return true;
      }
      return segmentedTempPixel(state->rawTempDeciC,
                                state->currentTempKnown,
                                47,
                                30,
                                x,
                                y,
                                false) ||
          humidityLinePixel(state->humidityKnown, state->humidityDeciPct, x, y);
    case UI_SUB_THERMO_OFFSET:
      return textLinePixelP(state->menuEditing ? PSTR("OFFSET EDIT") : PSTR("OFFSET"), 6, 7, x, y, 2) ||
          signedDeciLinePixel(state->ahtOffsetDeciC, 48, 43, x, y, 3);
    case UI_SUB_THERMO_CORRECTED:
      if (textLinePixelP(PSTR("CORRIGE"), 6, 7, x, y, 2)) {
        return true;
      }
      return segmentedTempPixel(state->currentTempDeciC, state->currentTempKnown, 47, 30, x, y) ||
          humidityLinePixel(state->humidityKnown, state->humidityDeciPct, x, y);
    case UI_SUB_THERMO_VACATION:
      if (textLinePixelP(state->menuEditing ? PSTR("VACANCES EDIT") : PSTR("VACANCES"),
                         6,
                         7,
                         x,
                         y,
                         2)) {
        return true;
      }
      return segmentedTempPixel(state->vacationSetpointDeciC, true, 47, 30, x, y);
    case UI_SUB_LEARNING_SETPOINT:
      if (textLinePixelP(PSTR("CONSIGNE"), 6, 7, x, y, 2)) {
        return true;
      }
      return segmentedTempPixel(state->setpointDeciC, true, 47, 30, x, y);
    case UI_SUB_LEARNING_ACTIVE:
      return centeredStatusPixel(PSTR("APPRENT"),
                                 state->learningEnabled ? PSTR("ACTIF") : PSTR("INACTIF"),
                                 false,
                                 x,
                                 y);
    case UI_SUB_LEARNING_CONSOLE_COMM:
      return centeredStatusPixel(PSTR("COMM. CONSOLE"),
                                 state->consoleCommTesting ? PSTR("ENVOI") :
                                 state->consoleOk ? PSTR("OK") : PSTR("ABSENTE"),
                                 false,
                                 x,
                                 y) ||
          (!state->consoleCommTesting && plusMarkerPixel(x, y));
    case UI_SUB_LEARNING_RESET_ZONE:
      return centeredStatusPixel(PSTR("RESET ZONE"), state->resetZonePending ? PSTR("ENVOI") : PSTR("OK"), false, x, y);
    case UI_SUB_LEARNING_RESET_GLOBAL:
      return centeredStatusPixel(PSTR("RESET ALL"), state->resetGlobalPending ? PSTR("ENVOI") : PSTR("OK"), false, x, y);
    case UI_SUB_LEARNING_LOAD_TYPICAL:
      return centeredStatusPixel(PSTR("SEMAINE TYPE"), state->loadTypicalWeekPending ? PSTR("ENVOI") : PSTR("OK"), false, x, y);
    case UI_SUB_NONE:
    default:
      return menuMainPixel(state, x, y);
  }
}
bool thickDiagonalPixel(uint16_t x1,
                        uint16_t y1,
                        uint16_t x2,
                        uint16_t y2,
                        uint16_t x,
                        uint16_t y) {
  const int32_t dx = (int32_t)x2 - x1;
  const int32_t dy = (int32_t)y2 - y1;
  const int32_t distance = ((int32_t)x - x1) * dy - ((int32_t)y - y1) * dx;
  return distance >= -220 && distance <= 220;
}

bool batteryDeadPixel(uint16_t x, uint16_t y) {
  if (thickDiagonalPixel(1, 1, ThermioEink097::FrontWidth - 2,
                         ThermioEink097::FrontHeight - 2, x, y) ||
      thickDiagonalPixel(ThermioEink097::FrontWidth - 2, 1, 1,
                         ThermioEink097::FrontHeight - 2, x, y)) {
    return true;
  }

  return ThermioFont5x7::textPixel_P(PSTR("REMPLACER"), 11, 20, x, y, 3) ||
      ThermioFont5x7::textPixel_P(PSTR("PILES"), 47, 48, x, y, 3);
}

bool stopPixel(uint16_t x, uint16_t y) {
  return ThermioFont5x7::textPixel_P(PSTR("STOP"), 56, 34, x, y, 3);
}

bool vacationPixel(uint16_t x, uint16_t y) {
  return ThermioFont5x7::textPixel_P(PSTR("VACANCES"), 29, 34, x, y, 3);
}

bool rfErrorPixel(uint16_t x, uint16_t y) {
  if (thickDiagonalPixel(1, 1, ThermioEink097::FrontWidth - 2,
                         ThermioEink097::FrontHeight - 2, x, y) ||
      thickDiagonalPixel(ThermioEink097::FrontWidth - 2, 1, 1,
                         ThermioEink097::FrontHeight - 2, x, y)) {
    return true;
  }

  return ThermioFont5x7::textPixel_P(PSTR("RF 433 MHZ"), 2, 26, x, y, 3) ||
      ThermioFont5x7::textPixel_P(PSTR("KO"), 65, 52, x, y, 3);
}

bool consoleLostPixel(uint16_t x, uint16_t y) {
  if (thickDiagonalPixel(1, 1, ThermioEink097::FrontWidth - 2,
                         ThermioEink097::FrontHeight - 2, x, y) ||
      thickDiagonalPixel(ThermioEink097::FrontWidth - 2, 1, 1,
                         ThermioEink097::FrontHeight - 2, x, y)) {
    return true;
  }

  return ThermioFont5x7::textPixel_P(PSTR("CONSOLE"), 28, 13, x, y, 3) ||
      ThermioFont5x7::textPixel_P(PSTR("HORS PORTEE"), 17, 43, x, y, 2);
}

bool rectPixel(int16_t x0,
               int16_t y0,
               int16_t w,
               int16_t h,
               uint16_t x,
               uint16_t y) {
  return (int16_t)x >= x0 && (int16_t)y >= y0 &&
      (int16_t)x < x0 + w && (int16_t)y < y0 + h;
}

uint8_t sevenSegmentMask(char value) {
  switch (value) {
    case '0':
      return 0b0111111;
    case '1':
      return 0b0000110;
    case '2':
      return 0b1011011;
    case '3':
      return 0b1001111;
    case '4':
      return 0b1100110;
    case '5':
      return 0b1101101;
    case '6':
      return 0b1111101;
    case '7':
      return 0b0000111;
    case '8':
      return 0b1111111;
    case '9':
      return 0b1101111;
    case 'C':
      return 0b0111001;
    case '-':
      return 0b1000000;
    default:
      return 0;
  }
}

bool sevenSegmentDigitPixel(char value,
                            int16_t x0,
                            int16_t y0,
                            uint16_t x,
                            uint16_t y) {
  const int16_t digitW = 29;
  const int16_t digitH = 48;
  const int16_t thick = 6;
  const uint8_t mask = sevenSegmentMask(value);
  if (mask == 0 || !rectPixel(x0, y0, digitW, digitH, x, y)) {
    return false;
  }

  return ((mask & 0b0000001) && rectPixel(x0 + thick, y0, digitW - 2 * thick, thick, x, y)) ||
      ((mask & 0b0000010) && rectPixel(x0 + digitW - thick, y0 + thick, thick, digitH / 2 - thick, x, y)) ||
      ((mask & 0b0000100) && rectPixel(x0 + digitW - thick, y0 + digitH / 2, thick, digitH / 2 - thick, x, y)) ||
      ((mask & 0b0001000) && rectPixel(x0 + thick, y0 + digitH - thick, digitW - 2 * thick, thick, x, y)) ||
      ((mask & 0b0010000) && rectPixel(x0, y0 + digitH / 2, thick, digitH / 2 - thick, x, y)) ||
      ((mask & 0b0100000) && rectPixel(x0, y0 + thick, thick, digitH / 2 - thick, x, y)) ||
      ((mask & 0b1000000) && rectPixel(x0 + thick, y0 + digitH / 2 - thick / 2, digitW - 2 * thick, thick, x, y));
}

bool sevenSegmentCommaPixel(int16_t x0, int16_t y0, uint16_t x, uint16_t y) {
  return rectPixel(x0, y0 + 35, 4, 4, x, y) ||
      rectPixel(x0 - 1, y0 + 39, 3, 3, x, y);
}

bool sevenSegmentDegreePixel(int16_t x0, int16_t y0, uint16_t x, uint16_t y) {
  return rectPixel(x0 + 2, y0 + 1, 5, 2, x, y) ||
      rectPixel(x0 + 2, y0 + 8, 5, 2, x, y) ||
      rectPixel(x0, y0 + 3, 2, 5, x, y) ||
      rectPixel(x0 + 7, y0 + 3, 2, 5, x, y);
}

bool segmentedTempPixel(int16_t tempDeciC,
                        bool known,
                        int16_t x0,
                        int16_t y0,
                        uint16_t x,
                        uint16_t y,
                        bool roundHalfDegree) {
  const int16_t digitW = 29;
  const int16_t digitH = 48;
  const int16_t gap = 4;
  const int16_t commaW = 4;
  const int16_t totalW = digitW * 3 + gap * 4 + commaW + 9;
  if (!rectPixel(x0, y0, totalW, digitH, x, y)) {
    return false;
  }

  char tens = '-';
  char units = '-';
  char decimal = '-';
  if (known) {
    if (roundHalfDegree) {
      tempDeciC = roundToHalfDegree(tempDeciC);
    }
    const int16_t tempAbs = tempDeciC < 0 ? -tempDeciC : tempDeciC;
    uint8_t whole = tempAbs / 10;
    if (whole > 99) {
      whole = 99;
    }
    tens = whole >= 10 ? (char)('0' + whole / 10) : ' ';
    if (tempDeciC < 0 && whole < 10) {
      tens = '-';
    }
    units = (char)('0' + whole % 10);
    decimal = (char)('0' + tempAbs % 10);
  }

  const int16_t tensX = x0;
  const int16_t unitsX = tensX + digitW + gap;
  const int16_t commaX = unitsX + digitW + gap - 1;
  const int16_t decimalX = commaX + commaW + gap;
  const int16_t degreeX = decimalX + digitW + gap;

  return sevenSegmentDigitPixel(tens, tensX, y0, x, y) ||
      sevenSegmentDigitPixel(units, unitsX, y0, x, y) ||
      sevenSegmentCommaPixel(commaX, y0, x, y) ||
      sevenSegmentDigitPixel(decimal, decimalX, y0, x, y) ||
      sevenSegmentDegreePixel(degreeX, y0, x, y);
}

bool homeSetpointPixel(int16_t setpointDeciC, uint16_t x, uint16_t y) {
  return textLinePixelP(PSTR("CONSIGNE"), 36, 4, x, y, 2) ||
      segmentedTempPixel(setpointDeciC, true, 66, 20, x, y);
}

}

uint8_t uiMenuSubCount(UiMenuPage page) {
  switch (page) {
    case UI_MENU_BATTERY:
      return sizeof(BatterySubPages) / sizeof(BatterySubPages[0]);
    case UI_MENU_CONSOLE:
      return sizeof(ConsoleSubPages) / sizeof(ConsoleSubPages[0]);
    case UI_MENU_THERMOMETER:
      return sizeof(ThermometerSubPages) / sizeof(ThermometerSubPages[0]);
    case UI_MENU_LEARNING:
      return sizeof(LearningSubPages) / sizeof(LearningSubPages[0]);
    case UI_MENU_PRESENCE:
    default:
      return 0;
  }
}

UiMenuSubPage uiMenuSubAt(UiMenuPage page, uint8_t index) {
  switch (page) {
    case UI_MENU_BATTERY:
      return index < uiMenuSubCount(page) ? BatterySubPages[index] : UI_SUB_NONE;
    case UI_MENU_CONSOLE:
      return index < uiMenuSubCount(page) ? ConsoleSubPages[index] : UI_SUB_NONE;
    case UI_MENU_THERMOMETER:
      return index < uiMenuSubCount(page) ? ThermometerSubPages[index] : UI_SUB_NONE;
    case UI_MENU_LEARNING:
      return index < uiMenuSubCount(page) ? LearningSubPages[index] : UI_SUB_NONE;
    case UI_MENU_PRESENCE:
    default:
      return UI_SUB_NONE;
  }
}

int8_t uiMenuSubIndex(UiMenuPage page, UiMenuSubPage subPage) {
  const uint8_t count = uiMenuSubCount(page);
  for (uint8_t i = 0; i < count; i++) {
    if (uiMenuSubAt(page, i) == subPage) {
      return i;
    }
  }
  return -1;
}

bool sondeScreenPixel(uint16_t x, uint16_t y, void *context) {
  UiState *state = (UiState *)context;

  if (x == 0 || y == 0 ||
      x == ThermioEink097::FrontWidth - 1 ||
      y == ThermioEink097::FrontHeight - 1) {
    return true;
  }

  if (state->page == UI_PAGE_BATTERY_DEAD) {
    return batteryDeadPixel(x, y);
  }
  if (state->page == UI_PAGE_STOP) {
    return stopPixel(x, y);
  }
  if (state->page == UI_PAGE_VACATION) {
    return vacationPixel(x, y);
  }
  if (state->page == UI_PAGE_CONSOLE_LOST) {
    return consoleLostPixel(x, y);
  }
  if (state->page == UI_PAGE_RF_ERROR) {
    return rfErrorPixel(x, y);
  }

  if (state->page == UI_PAGE_MENU) {
    return state->menuInSubmenu ? menuSubPixel(state, x, y) : menuMainPixel(state, x, y);
  }

  if (state->page != UI_PAGE_HOME) {
    return ThermioFont5x7::textPixel_P(PSTR("MENU"), 80, 38, x, y, 2);
  }

  if (state->setpointEditing) {
    return homeSetpointPixel(state->setpointDeciC, x, y);
  }

  return segmentedTempPixel(state->currentTempDeciC, state->currentTempKnown, 66, 20, x, y);
}
