jsdenim/thermonuino/main/Documentations/eInk/Sketch Demo/AU-GDEM0097T61-FP4G-20240821/GDEM0097T61_Arduino/Ap_29demo.h

#include <avr/pgmspace.h>
//////////////////////Bureau brush refreshes the number/////////////////////
///Digital presentation array
//////////////////////Bureau brush refreshes the number/////////////////////
///Digital presentation array
const unsigned char Num[10][96] PROGMEM= {
//0
{
0XFF,0XFF,0XFF,0XFF,0XFF,0XFF,0XFF,0XFF,0XFF,0XF8,0X0F,0XFF,0XFF,0XC0,0X01,0XFF,
0XFF,0X80,0X00,0XFF,0XFF,0X00,0X00,0X7F,0XFE,0X0F,0XF8,0X3F,0XFE,0X3F,0XFE,
0X3F,0XFC,0X7F,0XFF,0X1F,0XFC,0XFF,0XFF,0X9F,0XFD,0XFF,0XFF,0XDF,0XFD,0XFF,0XFF,
0XDF,0XFD,0XFF,0XFF,0XDF,0XFD,0XFF,0XFF,0XDF,0XFC,0XFF,0XFF,0X9F,0XFC,0XFF,
0XFF,0X1F,0XFE,0X3F,0XFE,0X3F,0XFE,0X0F,0XF8,0X3F,0XFF,0X00,0X00,0X7F,0XFF,0X80,
0X00,0XFF,0XFF,0XC0,0X01,0XFF,0XFF,0XF8,0X0F,0XFF,0XFF,0XFF,0XFF,0XFF,0XFF,
0XFF,0XFF,0XFF,},
//1
{
0XFF,0XFF,0XFF,0XFF,0XFF,0XFF,0XFF,0XFF,0XFF,0XFF,0XFF,0XFF,0XFF,0XFF,0XFF,0XFF,
0XFF,0XFF,0XFF,0XFF,0XFF,0XFF,0XFF,0XFF,0XFF,0X7F,0XFF,0XDF,0XFF,0X7F,0XFF,
0XDF,0XFF,0X7F,0XFF,0XDF,0XFF,0X7F,0XFF,0XDF,0XFF,0X7F,0XFF,0X9F,0XFE,0X00,0X00,
0X1F,0XFE,0X00,0X00,0X1F,0XFC,0X00,0X00,0X1F,0XFC,0X00,0X00,0X1F,0XFF,0XFF,
0XFF,0X9F,0XFF,0XFF,0XFF,0XDF,0XFF,0XFF,0XFF,0XDF,0XFF,0XFF,0XFF,0XDF,0XFF,0XFF,
0XFF,0XDF,0XFF,0XFF,0XFF,0XFF,0XFF,0XFF,0XFF,0XFF,0XFF,0XFF,0XFF,0XFF,0XFF,
0XFF,0XFF,0XFF,},
//2
{
0XFF,0XFF,0XFF,0XFF,0XFF,0XFF,0XFF,0XFF,0XFF,0XFF,0XFF,0X9F,0XFF,0X8F,0XFF,0X1F,
0XFF,0X07,0XFE,0X1F,0XFE,0X07,0XFC,0X9F,0XFE,0X07,0XF8,0X9F,0XFE,0XE7,0XF9,
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
0XEF,0XFF,0XE7,0XFF,0XEF,0XBF,0XF3,0XFF,0XFF,0XFF,0XCF,0XEF,0XFF,0XE7,0XFF,0XDE,
0X3F,0XF3,0XFF,0XFF,0XFF,0XC7,0XCF,0XFF,0XE7,0XFF,0XDD,0XBF,0XF3,0XFF,0XFF,0XFF,
0XF7,0XDF,0XFF,0XE7,0XFF,0XC3,0XBF,0XF3,0XFF,0XFF,0XFF,0XFF,0XFF,0XFF,0XE7,0XFF,
0XC3,0XBF,0XF3,0XFF,0XFF,0XFF,0XFF,0XFF,0XFF,0XE7,0XFF,0XFF,0XFF,0XF3,0XFF,0XFF,
0XFF,0XFF,0XFF,0XFF,0XE7,0XFF,0XE2,0X7F,0XF3,0XFF,0XFF,0XFC,0X00,0X0F,0XFF,0XE7,
0XFF,0XE2,0X7F,0XF3,0XFF,0XFF,0XFC,0X00,0X0F,0XFF,0XE7,0XFF,0XD3,0XBF,0XF3,0XFF,
0XFF,0XFC,0X00,0X0F,0XFF,0XE7,0XFF,0XD3,0XBF,0XF3,0XFF,0XFF,0XFF,0XFF,0XFF,0XFF,
0XE7,0XFF,0XD3,0XBF,0XF3,0XFF,0XFF,0XFF,0XFF,0XFF,0XFF,0XE7,0XFF,0XDC,0X7F,0XF3,
0XFF,0XFF,0XFF,0XFF,0XFF,0XFF,0XE7,0XFF,0XFF,0XFF,0XF3,0XFF,0XFF,0XFF,0XF0,0X1F,
0XFF,0XE7,0XFF,0XDF,0XFF,0XF3,0XFF,0XFF,0XFF,0XC0,0X0F,0XFF,0XE7,0XFF,0XDF,0XFF,
0XF3,0XFF,0XFF,0XFF,0XC0,0X0F,0XFF,0XE7,0XFF,0X2F,0XFF,0XF3,0XFF,0XFF,0XFF,0XCF,
0XEF,0XFF,0XE7,0XFF,0XDF,0XFF,0XF3,0XFF,0XFF,0XFF,0XCF,0XEF,0XFF,0XE7,0XFF,0XDF,
0XFF,0XF3,0XFF,0XFF,0XFF,0XCF,0XEF,0XFF,0XE7,0XFF,0XF0,0X7F,0XF3,0XFF,0XFF,0XFF,
0XC0,0X0F,0XFF,0XE7,0XFF,0XCE,0X7F,0XF3,0XFF,0XFF,0XFF,0XF0,0X1F,0XFF,0XE7,0XFF,
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
