jsdenim/thermonuino/(commit log)

2026-08-15 Replace repository with current Thermonuino workspace
    [Centrale-Commande.fzz, Centrale-DIN.fzz, Projet Fritzing.fzz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]
2026-08-17 Détail des icones
2026-08-19 Ajustement des tests, ménage.
    [Thermuino 5.6 Evnts de la base.skp, Thermuino.skp]
2026-08-22 Encore tentative de refaire marcher avec un protocole plus élaboré.
2026-08-22 Agrandissement de la tramme pour qu'il y ait la quantité de donnée prévu à la fin
2026-08-22 Tatonnement pour améliorer la parite RF
2026-08-22 Maj Spec à propose de millis
2026-08-22 TEst avec de presque données.
2026-08-22 Expliciter les offset des variables du playload
2026-08-22 LEcture de l'ACK
2026-08-22 Contrôle de cohérence.
2026-08-22 Travail sur les ID de chaque appareil, et le processus d'association
2026-08-22 Tatonnement pour touver un bug sur la phase association
    [pcb_porte_ouverte_test.ino]
2026-08-22 Leds plus claires.
2026-08-22 Mise en someil de l'atmega et du CC1101.
2026-08-23 Migration de tout ce qui a été appris dans les test vers les emplacements définitifs.
2026-08-23 Avancement sur la console et la logique de celle-ci (inclu simulateur)
2026-08-24 Ajustement de petites règles
2026-08-28 TEst pour les nouveaux PCB, écran eInk qui marche.
2026-08-29 Travail sur l'UI de la sonde.
2026-08-29 Icones et poursuite de l'UI
2026-08-30 ménage et structure de la sonde.
2026-08-30 Déparations en fichiers, et aménagement UI maintenant que tout est branché.
2026-09-09 Avant de faire plius simple pour l'écran
2026-09-09 Avant de passer à un affichage segmentaire.
2026-09-09 on fait passer la pillule avec un full refresh
2026-09-09 Avant d'allonger les chiffres.
2026-09-09 Hachures pour indiquer que ça travaille.
2026-09-10 menus et ménages dans les fichiers de compilation
2026-09-13 Tien, ça fait un moment que j'ai ouvlié de commiter...
2026-09-14 Des ajustements par rapport à la batterie.
2026-09-15 Encore des améliorations
2026-09-19 Send current sonde temperature only
2026-09-19 Learn simulated heating workload
2026-09-19 Set simulator zone power to 2100W
2026-09-19 Move heating regulator into commons
2026-09-19 Stabilize heating regulator catchup
2026-09-19 Smooth low-loss heating workload
2026-09-19 Wire heating regulator into console
2026-09-20 Ignore non protocol console noise in pilote simulator
    [pilote-simulation.ino]
2026-09-20 Use console temperature when zone has no sonde
2026-09-20 Use center LED for console system status
2026-10-03 Use adaptive default heating hold
2026-10-03 Add console failsafe thermostat mode
    [console.ino]
2026-10-03 Allow failsafe entry during association window
    [console.ino]
2026-10-03 Lock console failsafe control modes
    [console.ino]
2026-10-03 Separate console failsafe run mode
    [console.ino]
2026-10-03 Allow stop command in failsafe mode
    [console.ino]
2026-10-03 Apply sonde setpoint and temperature reports
2026-10-03 Move console RF indicators to center LED
2026-10-03 Invert door open reed LED indication
    [door-open.ino]
2026-10-03 Keep RF debug from disturbing console LEDs
2026-10-03 Cap maintenance heat by installed power
2026-10-04 Send sonde learning reset immediately
    [console.ino, sonde.ino]
2026-10-05 Add debug forced temperatures
2026-10-09 Stop maintenance heat above setpoint
2026-10-10 Improve sonde switch arbitration
2026-10-10 Ignore floating battery sense without cells
2026-10-11 Show bypassed door zones as heating
2026-10-11 Alternate bypassed door heating LED
2026-10-14 Limit hot temperature RF reports
2026-10-17 Share EEPROM-backed heating logic
2026-10-17 Anticipate scheduled heating by one slot
2026-10-17 Increase console daytime LED brightness
2026-10-19 Reduce schedule debug footprint
2026-10-21 Increase daytime console LED brightness
2026-10-21 Document pilote controls and LEDs
2026-10-23 Fix sleeping timers and share setpoint policy
2026-10-23 Validate pilote zone power readings
2026-10-23 Show unrounded AHT temperature on sonde
2026-10-23 Reduce console evening LED brightness
